b105-h2h/h2h/boards/2.0/3D/Resources/Kiwi/Renders/Kiwi Render.png

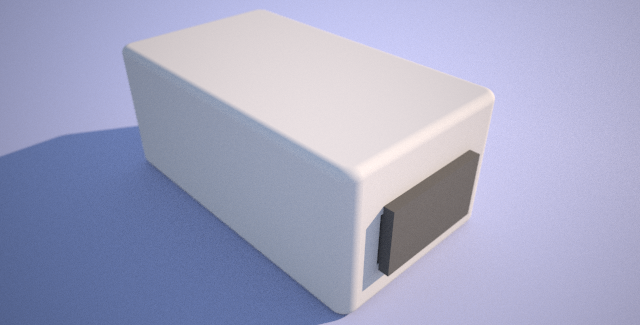
boards/2.0/3D/Resources/Kiwi/Renders/Kiwi Render.png
