b105-h2h/h2h/README.md

# h2h
PFC - Servicio de acceso inalámbrico a dispositivos médicos implantables mediante H2H
