b105-h2h/h2h/boards/2.0/3D/Resources/Persimmon/Renders/Persimmon Render 2.png

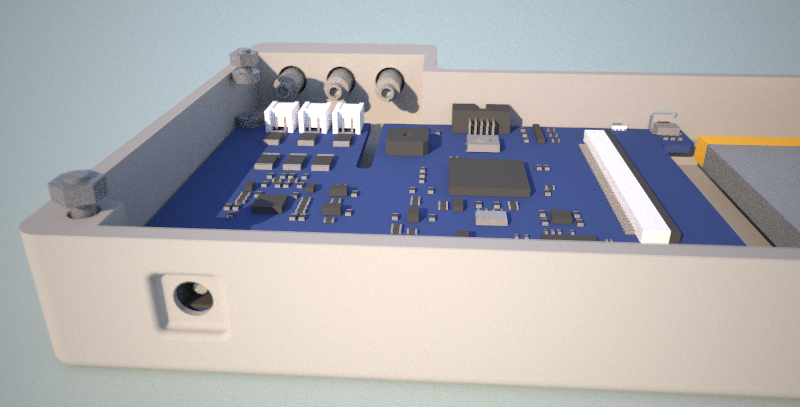
boards/2.0/3D/Resources/Persimmon/Renders/Persimmon Render 2.png
