b105-h2h/h2h/boards/2.0/H2H Main Board v1.1/Res/Images/res/Japanese-Persimmon1.jpg

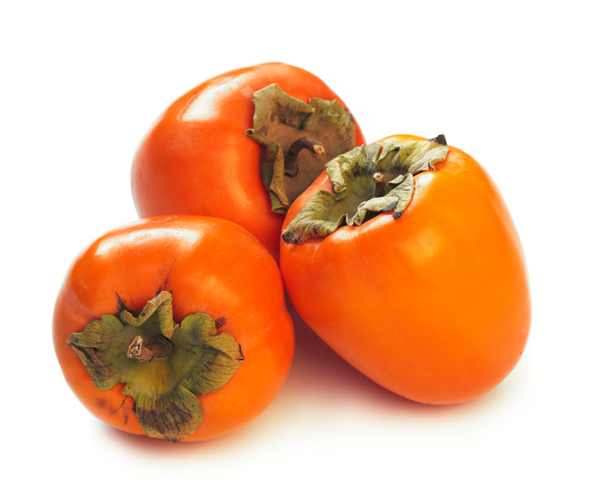
boards/2.0/H2H Main Board v1.1/Res/Images/res/Japanese-Persimmon1.jpg
