b105-h2h/h2h/boards/2.0/H2H Main Board v1.1/Res/Images/res/Persimmon.jpg

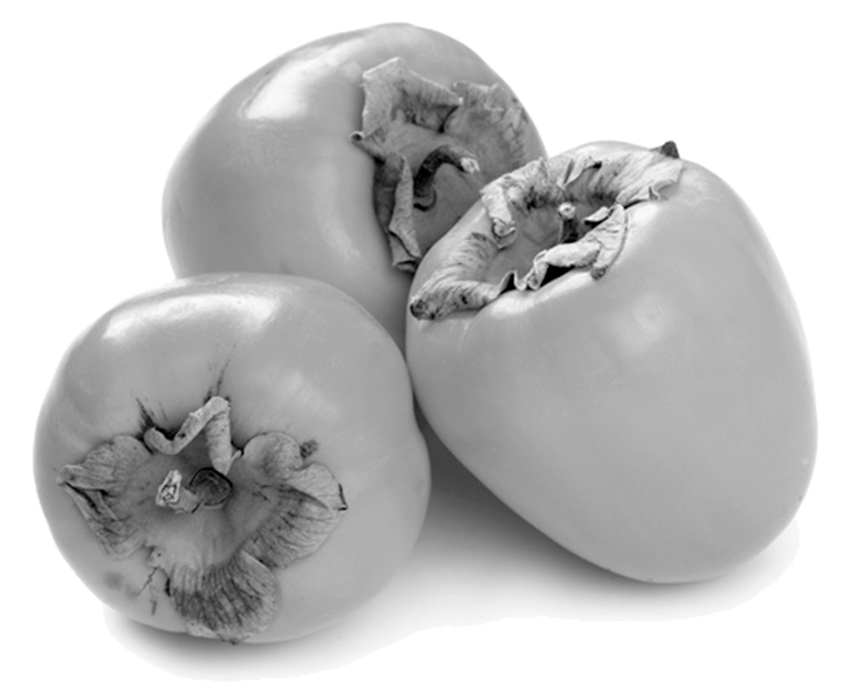
boards/2.0/H2H Main Board v1.1/Res/Images/res/Persimmon.jpg
