b105-h2h/h2h/code/dep/v3.0 PersimmonOS/FSM/Statechart Persimmon.png

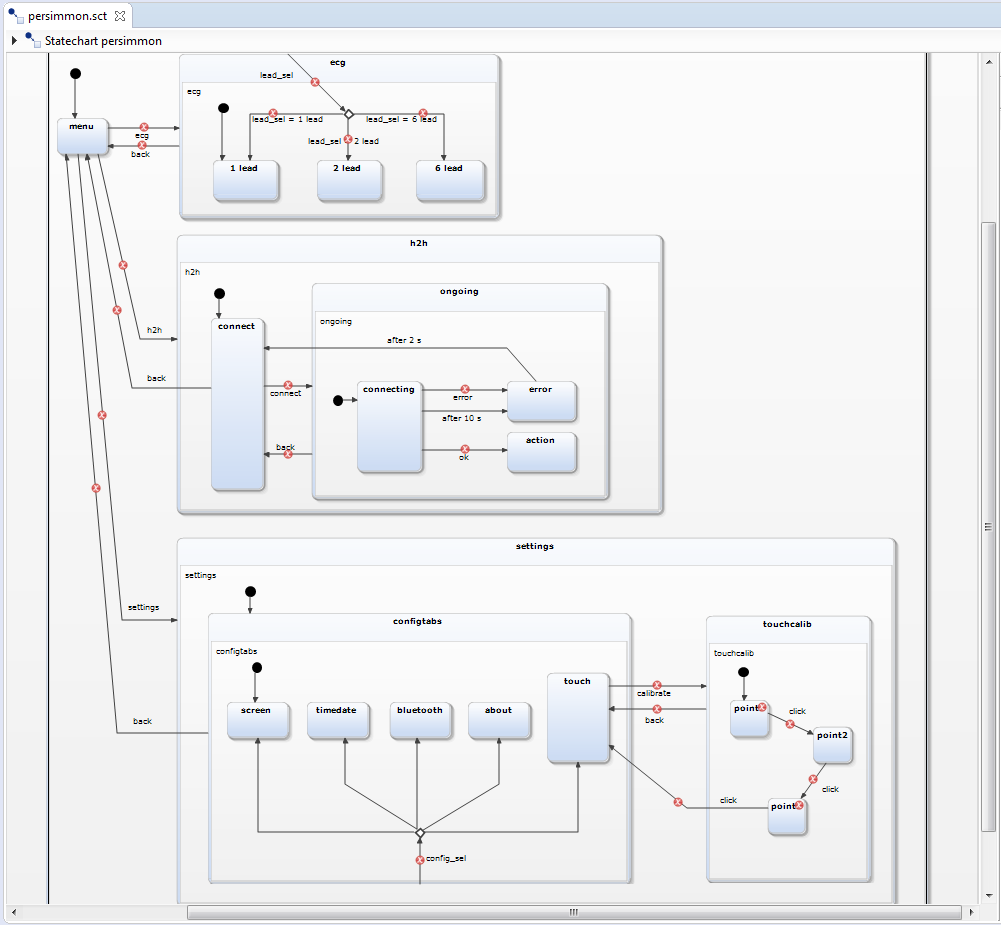
code/dep/v3.0 PersimmonOS/FSM/Statechart Persimmon.png
