b105-h2h/h2h/boards/1.0/BOM/BOM Delivered/Bill of Materials-Docking Station.xls

Sheet: BOM Report
Bill of Materials |  |  | <Parameter Title not found>
Source Data From: |  | Docking Station.PrjPcb
Project: |  | Docking Station.PrjPcb
Variant: |  | None
Creation Date: | 31/07/2015 | 21:06:06
Print Date: | 2015-07-31 | 21:06:16
 | Comment | LibRef | Designator | Description | Quantity
 | 6.8u | Pol Capacitor | C1, C2 | Polarized Capacitor | 2
 | 100p | Capacitor | C3 | Capacitor | 1
 | 4.7u | Pol Capacitor | C4 | Polarized Capacitor | 1
 | 0.1u | Capacitor | C5, C8, C10, C11 | Capacitor | 4
 | 2.2n | Capacitor | C6 | Capacitor | 1
 | 1.2m | Pol Capacitor | C7 | Polarized Capacitor | 1
 | 1u | Capacitor | C9, C12 | Capacitor | 2
 | MB6S-E3/45 | MB6S-E3/45 | D1 | Diode, Bridge Rectifier | 1
 | SM6T150A | SM6T150A | D2 | Diode, Transient Voltage Suppresor, 150V, 600W | 1
 | MRA4005T3G | MRA4005T3G | D3 | Diode, Standard, 1A | 1
 | 1N4148W-7-F | 1N4148W-7-F | D4 | Diode, Switch, 300mA, 100V | 1
 | B340LA-13-F | B340LA-13-F | D5 | Diode, Schottky, 40V, 3A | 1
 | ON | LED | D6 | LED | 1
 | CHG | LED | D7 | LED | 1
 | 4.7 | Fuse Resistor | FR1 | Resistor, Fuse | 1
 | UCC28910 | UCC28910 | IC1 | 700V Flyback Switcher with Constant-Voltage Constant-Current and Primary-side Control | 1
 | BQ24090 | BQ24090 | IC2 | Battery Charger, Single Cell Li-Ion/LiPo, 1A | 1
 | Inlet, IEC | Inlet, IEC - Plug | J1 | Inlet, IEC - Plug | 1
 | Header 3 | Header 3 | JP1 | Header, 3-Pin | 1
 | 1m | Inductor | L1, L2 | Inductor | 2
 | 2N7002 | 2N7002 | Q1 | Transistor, MOSFET, N-Channel, 60V, 300mA | 1
 | 6.8k | Resistor | R1, R2 | Resistor | 2
 | 2K | Resistor | R3, R5, R12 | Resistor | 3
 | 100K | Resistor | R4, R7, R16, R17 | Resistor | 4
 | 33 | Resistor | R6 | Resistor | 1
 | 31.6K | Resistor | R8 | Resistor | 1
 | 180 | Resistor | R9 | Resistor | 1
 | 15K | Resistor | R10 | Resistor | 1
 | 1.2K | Resistor | R11 | Resistor | 1
 | 10K | Resistor | R13 | Resistor | 1
 | 1.5K | Resistor | R14, R15 | Resistor | 2
 | WE7508110151 | WE7508110151 | T1 | Transformer, Flyback | 1
 |  |  |  |  | 45
Approved |  | Notes

Sheet: Project Information
Project Full Path | C:\Users\slopez\workspace\github\tiic-2015\Docking Station.PrjPcb
Project Filename | Docking Station.PrjPcb
Variant Name | None
Data-Source Filename | Docking Station.PrjPcb
Data-Source Full Path | C:\Users\slopez\workspace\github\tiic-2015\Docking Station.PrjPcb
Title | <Parameter Title not found>
Total Quantity | 45
Report Time | 21:06:06
Report Date | 31/07/2015
Report Date & Tine | 31/07/2015 21:06:06
Output Name | Bill of Materials
Output Type | BOM_PartType
Output Generator Name | BOM
Output Generator Description | Bill of Materials
