b105-h2h/h2h/boards/1.0/BOM/BOM Delivered/Bill of Materials-ECG Main Board.xls

Sheet: BOM Report
Bill of Materials |  |  | ECG Main Board
Source Data From: |  | ECG Main Board.PrjPcb
Project: |  | ECG Main Board.PrjPcb
Variant: |  | None
Creation Date: | 31/07/2015 | 21:04:40
Print Date: | 2015-07-31 | 21:05:37
 | Comment | LibRef | Designator | Description | Quantity
 | 6.8n | Capacitor | C1 | Capacitor | 1
 | 47p | Capacitor | C2, C3 | Capacitor | 2
 | 4.7n | Capacitor | C4, C5 | Capacitor | 2
 | 10u | Capacitor | C6, C18 | Capacitor | 2
 | 0.1u | Capacitor | C7, C12, C13, C14, C15, C16, C17, C24, C25, C30, C33, C34, C35, C36, C37 | Capacitor | 15
 | 1u | Capacitor | C8, C9, C10, C11, C31, C32, C40, C41, C42, C43, C44, C45, C46 | Capacitor | 13
 | 2.2n | Capacitor | C19 | Capacitor | 1
 | 15p | Capacitor | C20, C22 | Capacitor | 2
 | 8p | Capacitor | C21, C23 | Capacitor | 2
 | 12p | Capacitor | C26, C27 | Capacitor | 2
 | 0.47u | Capacitor | C28, C29, C39 | Capacitor | 3
 | 22p | Capacitor | C38 | Capacitor | 1
 | LED | LED | D1, D2, D3 | LED | 3
 | Touchscreen | Touchscreen | DISP |  | 1
 | RF Filter | LFB212G45SG8A127 | F1 | RF Filter 2.4 GHz | 1
 | 220 ohm 100 Mhz | Ferrita | FB1 | INDUCTOR, 0.04OHM, 3A, 0805 | 1
 | ADS1291 | ADS1291 | IC1 |  | 1
 | MSP430FR5972IPMR | MSP430FR5972IPMR | IC2 |  | 1
 | CC2560 | CC2560 | IC3 |  | 1
 | FUEL GUAGE | BQ27421 | IC4 |  | 1
 | LP5907 | LP5907 | IC5, IC6, IC7 |  | 3
 | LMS33460 | LMS33460 | IC8 |  | 1
 | TXB0106 | TXB0106 | IC9 |  | 1
 | Electrodes | JST PH 3 Pin Socket | J1 | JST PH 3 Pin Socket | 1
 | Batt | JST PH 2 Pin Socket | J2 | JST PH 2 Pin Socket | 1
 | Charger | JST PH 3 Pin Socket | J3 | JST PH 3 Pin Socket | 1
 | JTAG | JTAG 14 Pins | J4 | JTAG 7X2 Pin Header 90º | 1
 | 2N7002 | 2N7002 | Q1, Q2, Q3 | Transistor, MOSFET, N-Channel, 60V, 300mA | 3
 | BSS84 | BSS84 | Q4 | Transistor, MOSFET, P-Channel, 60V, 300mA | 1
 | 47K | Resistor | R1, R2 | Resistor | 2
 | 1M | Resistor | R3 | Resistor | 1
 | 100 | Resistor | R4, R5 | Resistor | 2
 | 1K | Resistor | R6, R12 | Resistor | 2
 | 220 | Resistor | R7 | Resistor | 1
 | 10K | Resistor | R8, R9, R10, R11, R13, R14, R15, R16 | Resistor | 8
 | 1.5M | Resistor | R17 | Resistor | 1
 | 470K | Resistor | R18 | Resistor | 1
 | 2.2K | Resistor | R19, R20, R21 | Resistor | 3
 | Spacer | Spacer 11mm M3x0.5 | SP1, SP2, SP3, SP4 | PCB Spacer 11mm M3x0.5 | 4
 | Spacer | Spacer 7mm M3x0.5 Screw | SP5, SP6, SP7, SP8 | PCB Spacer 7mm M3x0.5 Screw | 4
 | Switch SPDT | MFS201N-16-Z | SW1 |  | 1
 | XTAL_16MHZ | XTAL_16_MHz | X1 |  | 1
 | XTAL_32768 | XTAL_32768 | X2 |  | 1
 | XTAL_26_MHz | XTAL_26_MHz | X3 |  | 1
 | Buzzer | Buzzer | Z1 | Magnetic Buzzer 2.7 KHz | 1
 |  |  |  |  | 103
Approved |  | Notes

Sheet: Project Information
Project Full Path | C:\Users\slopez\workspace\github\tiic-2015\ECG Main Board.PrjPcb
Project Filename | ECG Main Board.PrjPcb
Variant Name | None
Data-Source Filename | ECG Main Board.PrjPcb
Data-Source Full Path | C:\Users\slopez\workspace\github\tiic-2015\ECG Main Board.PrjPcb
Title | ECG Main Board
Total Quantity | 103
Report Time | 21:04:40
Report Date | 31/07/2015
Report Date & Tine | 31/07/2015 21:04:40
Output Name | Bill of Materials
Output Type | BOM_PartType
Output Generator Name | BOM
Output Generator Description | Bill of Materials
