b105-h2h/h2h/boards/1.0/BOM/Main Board/BOM/Bill of Materials-ECG Main Board.xls

Sheet: BOM Report
Bill of Materials |  |  | ECG Main Board
Source Data From: |  | ECG Main Board.PrjPcb
Project: |  | ECG Main Board.PrjPcb
Variant: |  | None
Creation Date: | 23/07/2015 | 17:16:30
Print Date: | 2015-07-23 | 20:20:22
Production Quantity: | 1
Currency | <none>
 | Comment | LibRef | Designator | Quantity | Supplier 1 | Supplier Part Number 1
 | 6.8n | Capacitor | C1 | 1 | Digi-Key | 399-9120-1-ND
 | 47p | Capacitor | C2, C3 | 2 | Digi-Key | 399-1056-1-ND
 | 4.7n | Capacitor | C4, C5 | 2 | Digi-Key | 399-9091-1-ND
 | 10u | Capacitor | C6, C18 | 2 | Digi-Key | 490-10728-1-ND
 | 0.1u | Capacitor | C7, C12, C13, C14, C15, C16, C17, C24, C25, C30, C33, C34, C35, C36, C37 | 15 | Digi-Key | 490-1532-1-ND
 | 1u | Capacitor | C8, C9, C10, C11, C31, C32, C40, C41, C42, C43, C44, C45, C46 | 13 | Digi-Key | 490-3900-1-ND
 | 2.2n | Capacitor | C19 | 1 | Digi-Key | 399-7881-1-ND
 | 15p | Capacitor | C20, C22 | 2 | Digi-Key | 399-9004-1-ND
 | 8p | Capacitor | C21, C23 | 2 | Digi-Key | 490-9670-1-ND
 | 12p | Capacitor | C26, C27 | 2 | Digi-Key | 490-10704-1-ND
 | 0.47u | Capacitor | C28, C29, C39 | 3 | Digi-Key | 490-3295-1-ND
 | 22p | Capacitor | C38 | 1 | Digi-Key | 399-9031-1-ND
 | 47K | Resistor | R1, R2 | 2 | Digi-Key | CR0603-FX-4702ELFCT-ND
 | 1M | Resistor | R3 | 1 | Digi-Key | CR0603-FX-1004ELFCT-ND
 | 100 | Resistor | R4, R5 | 2 | Digi-Key | CR0603-FX-1000ELFCT-ND
 | 1K | Resistor | R6, R12 | 2 | Digi-Key | CR0603-FX-1001ELFCT-ND
 | 220 | Resistor | R7 | 1 | Digi-Key | CR0603-FX-2200ELFCT-ND
 | 10K | Resistor | R8, R9, R10, R11, R13, R14, R15, R16 | 8 | Digi-Key | CR0603-FX-1002ELFCT-ND
 | 1.5M | Resistor | R17 | 1 | Digi-Key | 311-1.50MHRCT-ND
 | 470K | Resistor | R18 | 1 | Digi-Key | CR0603-FX-4703ELFCT-ND
 | 2.2K | Resistor | R19, R20, R21 | 3 | Digi-Key | CR0603-FX-2201ELFCT-ND
 | 220 ohm 100 Mhz | Ferrita | FB1 | 1 | Digi-Key | 490-1054-1-ND
 | Header 20x2 | Touchscreen | DISP | 1 | Digi-Key | S6106-ND
 | RF Filter | LFB212G45SG8A127 | F1 | 1 | Digi-Key | 490-5021-1-ND
 | ADS1291 | ADS1291 | IC1 | 1 | Digi-Key | 296-36547-5-ND
 | BQ27421 | BQ27421 | IC4 | 1 | Digi-Key | 296-38880-1-ND
 | LP5907 | LP5907 | IC5, IC6 | 2 | Digi-Key | 296-38557-1-ND
 | LP5907 | LP5907 | IC7 | 1 | Digi-Key | 296-41463-1-ND
 | LMS33460 | LMS33460 | IC8 | 1 | Digi-Key | LMS33460MG/NOPBCT-ND
 | TXB0106 | TXB0106 | IC9 | 1 | Digi-Key | 296-23759-1-ND
 | Electrodes | JST PH 3 Pin Socket | J1 | 1 | Digi-Key | 455-1720-ND
 | Batt | JST PH 2 Pin Socket | J2 | 1 | Digi-Key | 455-1719-ND
 | Charger | JST PH 3 Pin Socket | J3 | 1 | Digi-Key | 455-1720-ND
 | JTAG | JTAG 14 Pins | J4 | 1 | Digi-Key | ED10534-ND
 | 2N7002 | 2N7002 | Q1, Q2, Q3 | 3 | Digi-Key | 568-5818-1-ND
 | BSS84 | BSS84 | Q4 | 1 | Digi-Key | BSS84CT-ND
 | Spacer | Spacer 11mm M3x0.5 | SP1, SP2, SP3, SP4 | 4 | Digi-Key | 952-2312-ND
 | Spacer | Spacer 7mm M3x0.5 Screw | SP5, SP6, SP7, SP8 | 4 | Digi-Key | 952-1498-ND
 | Switch SPDT | MFS201N-16-Z | SW1 | 1 | Digi-Key | 563-1558-ND
 | XTAL_32768 | XTAL_32768 | X2 | 1 | Digi-Key | 535-9032-ND
 | XTAL_26_MHz | XTAL_26_MHz | X3 | 1 | Digi-Key | 644-1261-1-ND
 | XTAL_16MHZ | XTAL_16_MHz | X1 | 1 | Farnell | 2467444
 | CC2560 | CC2560 | IC3 | 1 | Farnell | 2334559
 | LED | LED | D1 | 1 | Farnell | 2426228
 | LED | LED | D2 | 1 | Farnell | 2426227
 | LED | LED | D3 | 1 | Farnell | 2426229
 | Buzzer | Buzzer | Z1 | 1 | Farnell | 2215090
 |  |  |  | 102

Sheet: Project Information
Project Full Path | C:\Users\slopez\workspace\github\tiic-2015\ECG Main Board.PrjPcb
Project Filename | ECG Main Board.PrjPcb
Variant Name | None
Data-Source Filename | ECG Main Board.PrjPcb
Data-Source Full Path | C:\Users\slopez\workspace\github\tiic-2015\ECG Main Board.PrjPcb
Title | ECG Main Board
Total Quantity | 103
Report Time | 17:16:30
Report Date | 23/07/2015
Report Date & Tine | 23/07/2015 17:16:30
Output Name | Bill of Materials
Output Type | BOM_PartType
Output Generator Name | BOM
Output Generator Description | Bill of Materials
