b105-h2h/h2h/boards/1.0/BOM/Docking Station/BOM/BOM/Bill of Materials-Docking Station.xls

Sheet: BOM Report
Bill of Materials |  |  | <Parameter Title not found>
Source Data From: |  | Docking Station.PrjPcb
Project: |  | Docking Station.PrjPcb
Variant: |  | None
Creation Date: | 23/07/2015 | 19:10:10
Print Date: | 2015-07-23 | 20:02:44
Production Quantity: | 1
Currency | <none>
 | Comment | LibRef | Designator | Quantity | Supplier 1 | Supplier Part Number 1
 | 6.8u | Pol Capacitor | C1, C2 | 2 | Farnell | 1831315
 | 100p | Capacitor | C3 | 1 | Farnell | 2211011
 | 4.7u | Pol Capacitor | C4 | 1 | Farnell | 2069186
 | 0.1u | Capacitor | C5, C8, C10, C11 | 4 | Farnell | 2407345
 | 2.2n | Capacitor | C6 | 1 | Farnell | 2409062
 | 1.2m | Pol Capacitor | C7 | 1 | Farnell | 1848381
 | 1u | Capacitor | C9, C12 | 2 | Farnell | 2346954
 | MB6S-E3/45 | MB6S-E3/45 | D1 | 1 | Farnell | 1815631
 | SM6T150A | SM6T150A | D2 | 1 | Farnell | 9885889
 | MRA4005T3G | MRA4005T3G | D3 | 1 | Farnell | 1459136
 | 1N4148W-7-F | 1N4148W-7-F | D4 | 1 | Farnell | 1776392
 | B340LA-13-F | B340LA-13-F | D5 | 1 | Farnell | 1843681
 | ON | LED | D6 | 1 | Farnell | 2426228
 | CHG | LED | D7 | 1 | Farnell | 2426227
 | 4.7 | Fuse Resistor | FR1 | 1 | Farnell | 9474080
 | Inlet, IEC | Inlet, IEC - Plug | J1 | 1 | Farnell | 9248161
 | 1m | Inductor | L1, L2 | 2 | Farnell | 2457618
 | 2N7002 | 2N7002 | Q1 | 1 | Digi-key | 568-5818-1-ND
 | 6.8k | Resistor | R1, R2 | 2 | Digi-key | CR1206-FX-6801ELFCT-ND
 | 2K | Resistor | R3, R5, R12 | 3 | Digi-key | CR1206-FX-2001ELFCT-ND
 | 100K | Resistor | R4, R7, R16, R17 | 4 | Digi-key | CR1206-FX-1003ELFCT-ND
 | 33 | Resistor | R6 | 1 | Digi-key | P33.0FCT-ND
 | 31.6K | Resistor | R8 | 1 | Digi-key | CR1206-FX-3162ELFCT-ND
 | 180 | Resistor | R9 | 1 | Digi-key | CR1206-FX-1800ELFCT-ND
 | 15K | Resistor | R10 | 1 | Digi-key | CR1206-FX-1502ELFCT-ND
 | 1.2K | Resistor | R11 | 1 | Digi-key | CR1206-FX-1201ELFCT-ND
 | 10K | Resistor | R13 | 1 | Digi-key | CR1206-FX-1002ELFCT-ND
 | 1.5K | Resistor | R14, R15 | 2 | Digi-key | CR1206-FX-1501ELFCT-ND
 | WE7508110151 | WE7508110151 | T1 | 1 | Digi-key | 1297-1122-ND
 |  |  |  | 42
Approved |  | Notes

Sheet: Project Information
Project Full Path | C:\Users\slopez\workspace\github\tiic-2015\Docking Station.PrjPcb
Project Filename | Docking Station.PrjPcb
Variant Name | None
Data-Source Filename | Docking Station.PrjPcb
Data-Source Full Path | C:\Users\slopez\workspace\github\tiic-2015\Docking Station.PrjPcb
Title | <Parameter Title not found>
Total Quantity | 45
Report Time | 19:10:10
Report Date | 23/07/2015
Report Date & Tine | 23/07/2015 19:10:10
Output Name | Bill of Materials
Output Type | BOM_PartType
Output Generator Name | BOM
Output Generator Description | Bill of Materials
