b105-h2h/h2h/boards/2.0/H2H Main Board v1.1/Output/BOM/2016-07-04/H2H Main Board v1.1 (Persimmon) - BOM.xls

Sheet: BOM Report
Bill of Materials |  |  | Main Board
Source Data From: |  | H2H Main Board v1.1.PrjPCB
Project: |  | H2H Main Board v1.1.PrjPCB
Variant: |  | H2H Main Board (Main Flash Boot)
Creation Date: | 04/07/2016 | 18:04:44
Print Date: | 2016-07-04 | 18:12:51
Production Quantity: | 1
Currency | <none>
Comment | LibRef | Designator | Description | Quantity | Supplier 1 | Supplier Part Number 1 | Supplier Unit Price 1 | Supplier Order Qty 1 | Supplier Subtotal 1 | Manufacturer 1 | Manufacturer Part Number 1
1n | Capacitor | C1, C2 | Capacitor | 2 |  |  |  |  | $0.00
47p | Capacitor | C3, C4, C5 | Capacitor | 3 |  |  |  |  | $0.00
1.5n | Capacitor | C6 | Capacitor | 1 |  |  |  |  | $0.00
4.7n | Capacitor | C7, C8 | Capacitor | 2 |  |  |  |  | $0.00
1u | Capacitor | C9, C11, C15, C16, C17, C22, C25, C34, C60, C61, C62, C63, C65, C66, C67, C68, C69, C70, C71, C72 | Capacitor | 20 |  |  |  |  | $0.00
0.1u | Capacitor | C10, C12, C14, C18, C19, C20, C23, C24, C29, C30, C31, C32, C33, C35, C42, C43, C64 | Capacitor | 17 |  |  |  |  | $0.00
10u | Capacitor | C13, C28 | Capacitor | 2 |  |  |  |  | $0.00
0.47u | Capacitor | C21 | Capacitor | 1 |  |  |  |  | $0.00
10n | Capacitor | C27, C40 | Capacitor | 2 |  |  |  |  | $0.00
6p | Capacitor | C36, C37 | Capacitor | 2 |  |  |  |  | $0.00
10p | Capacitor | C38, C39 | Capacitor | 2 |  |  |  |  | $0.00
22p | Capacitor | C41 | Capacitor | 1 |  |  |  |  | $0.00
12p | Capacitor | C44, C45 | Capacitor | 2 |  |  |  |  | $0.00
1u | Capacitor | C46, C47 | Capacitor | 2 |  |  |  |  | $0.00
0.1u | Capacitor | C48, C49, C50, C51, C52, C53, C54, C55, C56, C57 | Capacitor | 10 |  |  |  |  | $0.00
0.47u | Capacitor | C58, C59 | Capacitor | 2 |  |  |  |  | $0.00
BAS70DW-04 | BAS70DW-04 | D1, D2 | TVS - Dual Schottky Rail-to-rail Protection | 2 | Digi-Key | BAS70DW-04FDICT-ND | 0,49 | 2 | $0.98 | Diodes Incorporated | BAS70DW-04-7-F
PESD5V0X1 | PESD5V0X1 | D3, D4, D5 | TVS - Bidirectional Zener Diode | 3 | Digi-Key | 568-4676-1-ND | 0,69 | 3 | $2.07 | NXP Semiconductors | PESD5V0X1BT,215
BAS16L | BAS16L | D6 | Diode - Switching diode, 1 V, 200 mA | 1 | Digi-Key | BAS16LT1GOSCT-ND | 0,11 | 1 | $0.11 | ON Semiconductor | BAS16LT1G
OVSRRGBCC3 | OVSRRGBCC3 | D7 | LED - RGB, Top/Side-emmiting | 1 | Digi-Key | 365-1981-1-ND | 0,45 | 1 | $0.45 | TT Electronics/Optek Technology | OVSRRGBCC3TM
LFB212G45SG8A127 | LFB212G45SG8A127 | F1 | Filter - RF 2.4 GHz | 1 | Digi-Key | 490-5021-1-ND | 0,32 | 1 | $0.32 | Murata Electronics North America | LFB212G45SG8A127
JST PH 2 Pin | S2B-PH-K-S | J1 | Conn - Battery, Male, 2 Pin, PCB, Right Angle | 1 | Digi-Key | 455-1719-ND | 0,15 | 1 | $0.15 | JST Sales America Inc. | S2B-PH-K-S(LF)(SN)
PJ-018H-SMT | PJ-018H-SMT | J2 | Conn - DC Power Plug - 4.0 mmOD / 1.7 mmID | 1 | Digi-Key | CP-018HPJCT-ND | 1,22 | 1 | $1.22 | CUI Inc. | PJ-018H-SMT-TR
JTAG 10 Pin | 3220-10-0200-00 | J3 | Conn - JTAG, Header, Male, Right Angle, 10 Pin, 1.27mm Pitch, ARM Standard | 1 | Digi-Key | 1175-1628-ND | 0,58 | 1 | $0.58 | CNC Tech | 3220-10-0200-00
FFC 40 Pin | ER-CON40HB-2 | J4 | Conn - FFC/FPC, 40 Pin, 1.0mm Pitch, ZIF | 1 |  |  |  |  | $0.00
Banana Jack | CT3151SP-6 | JE1, JE2, JE3, JE4 | Conn - 4mm Banana Female Jack, PCB mount, Right Angle | 4 | Digi-Key | BKCT3151SP-6-ND | 1,85 | 4 | $7.40 | B&K Precision | CT3151SP-6
GDT | 2051-09-SM | N1, N2, N3 | TVS - Gas Discharge Tube | 3 | Digi-Key | 2051-09-SM-RPLFCT-ND | 0,69 | 3 | $2.07 | Bourns Inc. | 2051-09-SM-RPLF
DMP3056L | DMP3056L | Q1 | Transistor - MOSFET, P-Channel, 30V, 4.3A | 1 | Digi-Key | DMP3056L-7DICT-ND | 0,35 | 1 | $0.35 | Diodes Incorporated | DMP3056L-7
BSS84 | BSS84 | Q2 | Transistor - MOSFET, P-Channel, 50V, 130mA | 1 | Digi-Key | BSS84CT-ND | 0,21 | 1 | $0.21 | Fairchild Semiconductor | BSS84
2N7002P | 2N7002P | Q3, Q4, Q5, Q6 | Transistor - MOSFET, N-Channel, 60V, 300mA | 4 | Digi-Key | 568-5818-1-ND | 0,13 | 4 | $0.52 | NXP Semiconductors | 2N7002P,215
22k | Resistor | R1, R2, R3, R4, R5, R6 | Resistor | 6 | Digi-Key | 541-22KXCT-ND | 0,32 | 6 | $1.92 | Vishay Dale | CRCW251222K0JNEG
47k | Resistor | R7, R8, R9 | Resistor | 3 |  |  |  |  | $0.00
0 | Resistor | R10, R27, R33, R41, R42 | Resistor | 5 |  |  |  |  | $0.00
1M | Resistor | R11, R20, R50, R51, R52, R53, R54 | Resistor | 7 |  |  |  |  | $0.00
100k | Resistor | R12, R25, R31, R32, R36, R37, R43, R47, R48, R49 | Resistor | 10 |  |  |  |  | $0.00
100 | Resistor | R13, R14, R18, R23 | Resistor | 4 |  |  |  |  | $0.00
10k | Resistor | R15, R16, R17, R29, R38, R40 | Resistor | 6 |  |  |  |  | $0.00
0.01 | Resistor | R19 | Resistor | 1 | Digi-Key | MCS1632R010FERCT-ND | 0,44 | 1 | $0.44 | Ohmite | MCS1632R010FER
1.2k | Resistor | R26 | Resistor | 1 |  |  |  |  | $0.00
2k | Resistor | R28 | Resistor | 1 |  |  |  |  | $0.00
680 | Resistor | R44 | Resistor | 1 |  |  |  |  | $0.00
220 | Resistor | R45, R46 | Resistor | 2 |  |  |  |  | $0.00
WS-TASU 436331045822 | WS-TASU 436331045822 | SW1 | Switch - Tactile, Off-Mom, SPST, Side-Actuated | 1 | Digi-Key | 732-7059-1-ND | 0,49 | 1 | $0.49 | Wurth Electronics Inc | 436331045822
EVQ-Q2K01W | EVQ-Q2K01W | SW2 | Switch - Tactile, Off-Mom, SPST | 1 | Digi-Key | P12941SCT-ND | 0,36 | 1 | $0.36 | Panasonic Electronic Components | EVQ-Q2K01W
ADS1292 | ADS1292 | U1 | IC - Analog Front End - Medical | 1 | Digi-Key | 296-30137-5-ND | 9,52 | 1 | $9.52 | Texas Instruments | ADS1292IPBS
BQ27441DRZR-G1A | BQ27441DRZR-G1A | U2 | IC - Fuel Gauge, System-Side Impedance Track | 1 | Digi-Key | 296-39941-1-ND | 2,55 | 1 | $2.55 | Texas Instruments | BQ27441DRZR-G1A
BQ24090 | BQ24090 | U3 | IC - Battery Charger, Single Cell Li-Ion/LiPo, 1A | 1 | Digi-Key | 296-38875-1-ND | 1,10 | 1 | $1.10 | Texas Instruments | BQ24090DGQR
STM32L162VDT6 | STM32L162VDT6 | U4 | ARM Cortex-M3 32-bit MCU, 384 KB Flash, 48 KB Internal RAM, 83 I/Os, 100-pin LQFP, -40 to 85 degC, Tray | 1 | Farnell | 2333341 | 10,22 | 1 | $10.22 | STMICROELECTRONICS | STM32L162VDT6
SN74LV4T125 | SN74LV4T125 | U5, U7 | IC - Voltage Level Translator | 2 | Digi-Key | 296-40546-1-ND | 1,00 | 2 | $2.00 | Texas Instruments | SN74LV4T125RGYR
CC2560A | CC2560A | U6 | IC - Bluetooth 4.0 controller (BR/EDR) | 1 | Farnell | 2334559 | 5,67 | 1 | $5.67 | TEXAS INSTRUMENTS | CC2560ARVMT
LP5907-3.3 | LP5907-3.3 | U8, U10, U12, U13 | Voltage Regulator - Linear | 4 | Digi-Key | 296-38557-1-ND | 0,51 | 4 | $2.04 | Texas Instruments | LP5907MFX-3.3/NOPB
TPS73633 | TPS73633 | U9 | Voltage Regulator - Linear | 1 | Digi-Key | 296-17884-1-ND | 1,98 | 1 | $1.98 | Texas Instruments | TPS73633DRBR
LP5907-1.8 | LP5907-1.8 | U11 | Voltage Regulator - Linear | 1 | Digi-Key | 296-41463-1-ND | 0,51 | 1 | $0.51 | Texas Instruments | LP5907MFX-1.8/NOPB
ABS07-120-32.768KHZ-T | ABS07-120-32.768KHZ-T | X1 | Crystal - 32.768 kHz | 1 | Digi-Key | 535-11937-1-ND | 0,64 | 1 | $0.64 | Abracon LLC | ABS07-120-32.768KHZ-T
ABM3B-16.000MHZ-10-1-U | ABM3B-16.000MHZ-10-1-U | X2 | Crystal - 16 MHz | 1 | Digi-Key | 300-8206-1-ND | 0,62 | 1 | $0.62 | Abracon LLC | ABM3B-16.000MHZ-10-1-U-T
NX2016SA | NX2016SA | X3 | Crystal - 26 MHz | 1 | Digi-Key | 644-1220-1-ND | 0,69 | 1 | $0.69 | NDK | NX2016SA-26M-STD-CZS-1
2.7 kHz | KSSG74B16 | Z1 | Transductor - Buzzer 2.7 kHz | 1 | Farnell | 2215090 | 1,47 | 1 | $1.47 | KINGSTATE | KSSG74B16
 |  |  |  | 162 |  |  |  |  | $58.65
Approved |  | Notes

Sheet: Project Information
Project Full Path | C:\Users\slopez\workspace\github\tiic-2015\boards\2.0\H2H Main Board v1.1\H2H Main Board v1.1.PrjPCB
Project Filename | H2H Main Board v1.1.PrjPCB
Variant Name | H2H Main Board (Main Flash Boot)
Data-Source Filename | H2H Main Board v1.1.PrjPCB
Data-Source Full Path | C:\Users\slopez\workspace\github\tiic-2015\boards\2.0\H2H Main Board v1.1\H2H Main Board v1.1.PrjPCB
Title | Main Board
Total Quantity | 162
Report Time | 18:04:44
Report Date | 04/07/2016
Report Date & Tine | 04/07/2016 18:04:44
Output Name | Bill of Materials
Output Type | BOM_PartType
Output Generator Name | BOM
Output Generator Description | Bill of Materials
