b105-h2h/h2h/boards/2.0/H2H Main Board v1.1/Output/BOM/2016-07-29/H2H Main Board v1.1 (Persimmon) - BOM.xls

Sheet: BOM Report
Bill of Materials |  |  | Main Board
Source Data From: |  | H2H Main Board v1.1.PrjPCB
Project: |  | H2H Main Board v1.1.PrjPCB
Variant: |  | H2H Main Board (Main Flash Boot)
Creation Date: | 29/07/2016 | 18:36:52
Print Date: | 2016-07-29 | 18:40:47
Production Quantity: | 1
Currency | <none>
Footprint | Comment | Designator | Description | Quantity | Supplier 1 | Supplier Part Number 1 | Supplier Unit Price 1
C0603 | 1n | C1, C2 | Capacitor | 2
C0603 | 47p | C3, C4, C5 | Capacitor | 3
C0603 | 1.5n | C6 | Capacitor | 1
C0603 | 4.7n | C7, C8 | Capacitor | 2
C0603 | 1u | C9, C11, C15, C16, C17, C22, C25, C27, C28, C29, C30, C32, C33, C34, C35, C36, C37, C38, C39, C66 | Capacitor | 20
C0603 | 0.1u | C10, C12, C14, C18, C19, C20, C23, C24, C31, C41, C42, C61, C62, C63, C64, C65, C67 | Capacitor | 17
C0603 | 10u | C13, C60 | Capacitor | 2
C0603 | 0.47u | C21 | Capacitor | 1
C0402 | 22p | C40 | Capacitor | 1
C0402 | 12p | C43, C44 | Capacitor | 2
C0402 | 1u | C45, C46 | Capacitor | 2
C0402 | 0.1u | C47, C48, C49, C50, C51, C52, C53, C54, C55, C56 | Capacitor | 10
C0402 | 0.47u | C57, C58 | Capacitor | 2
C0603 | 10n | C59, C72 | Capacitor | 2
C0603 | 6p | C68, C69 | Capacitor | 2
C0603 | 10p | C70, C71 | Capacitor | 2
 | BAS70DW-04 | D1, D2 | TVS - Dual Schottky Rail-to-rail Protection | 2 | Digi-Key | BAS70DW-04FDICT-ND | 0,49
 | PESD5V0X1 | D3, D4, D5 | TVS - Bidirectional Zener Diode | 3 | Digi-Key | 568-4676-1-ND | 0,69
 | BAS16L | D6 | Diode - Switching diode, 1 V, 200 mA | 1 | Digi-Key | BAS16LT1GOSCT-ND | 0,11
 | OVSRRGBCC3 | D7 | LED - RGB, Top/Side-emmiting | 1 | Digi-Key | 365-1981-1-ND | 0,45
 | LFB212G45SG8A127 | F1 | Filter - RF 2.4 GHz | 1 | Digi-Key | 490-5021-1-ND | 0,32
 | JST PH 2 Pin | J1 | Conn - Battery, Male, 2 Pin, PCB, Right Angle | 1 | Digi-Key | 455-1719-ND | 0,15
 | PJ-018H-SMT | J2 | Conn - DC Power Plug - 4.0 mmOD / 1.7 mmID | 1 | Digi-Key | CP-018HPJCT-ND | 1,22
 | FFC 40 Pin | J3 | Conn - FFC/FPC, 40 Pin, 1.0mm Pitch, ZIF | 1
 | JTAG 10 Pin | J4 | Conn - JTAG, Header, Male, Right Angle, 10 Pin, 1.27mm Pitch, ARM Standard | 1 | Digi-Key | 1175-1628-ND | 0,58
 | CT3151-6 | JE1, JE2, JE3, JE4 | Conn - 4mm Banana Female Jack, PCB mount, Right Angle | 4 | Digi-Key | BKCT3151SP-6-ND | 1,85
 | GDT | N1, N2, N3 | TVS - Gas Discharge Tube | 3 | Digi-Key | 2051-09-SM-RPLFCT-ND | 0,69
 | DMP3056L | Q1 | Transistor - MOSFET, P-Channel, 30V, 4.3A | 1 | Digi-Key | DMP3056L-7DICT-ND | 0,35
 | BSS84 | Q2 | Transistor - MOSFET, P-Channel, 50V, 130mA | 1 | Digi-Key | BSS84CT-ND | 0,21
 | 2N7002P | Q3, Q4, Q5, Q6 | Transistor - MOSFET, N-Channel, 60V, 300mA | 4 | Digi-Key | 568-5818-1-ND | 0,13
R2512 | 22k | R1, R2, R3, R4, R5, R6 | Resistor | 6 | Digi-Key | 541-22KXCT-ND | 0,32
R0603 | 47k | R7, R8, R9 | Resistor | 3
R0603 | 0 | R10, R25, R38, R39, R47 | Resistor | 5
R0603 | 1M | R11, R21, R33, R34, R35, R36, R37 | Resistor | 7
R0603 | 100k | R12, R28, R29, R31, R40, R44, R45, R46, R49, R50 | Resistor | 10
R0603 | 100 | R13, R14, R16, R17 | Resistor | 4
R1206 | 0.01 | R15 | Resistor | 1 | Digi-Key | MCS1632R010FERCT-ND | 0,51
R0603 | 10k | R18, R19, R20, R27, R52, R54 | Resistor | 6
R0603 | 1.2k | R24 | Resistor | 1
R0603 | 2k | R26 | Resistor | 1
R0603 | 680 | R41 | Resistor | 1
R0603 | 220 | R42, R43 | Resistor | 2
 | WS-TASU 436331045822 | SW1 | Switch - Tactile, Off-Mom, SPST, Side-Actuated | 1 | Digi-Key | 732-7059-1-ND | 0,49
 | EVQ-Q2K01W | SW2 | Switch - Tactile, Off-Mom, SPST | 1 | Digi-Key | P12941SCT-ND | 0,36
 | ADS1292 | U1 | IC - Analog Front End - Medical | 1 | Digi-Key | 296-30137-5-ND | 9,52
 | BQ27441DRZR-G1A | U2 | IC - Fuel Gauge, System-Side Impedance Track | 1 | Digi-Key | 296-39941-1-ND | 2,55
 | BQ24090 | U3 | IC - Battery Charger, Single Cell Li-Ion/LiPo, 1A | 1 | Digi-Key | 296-38875-1-ND | 1,10
 | LP5907-3.3 | U4, U6, U8, U9 | Voltage Regulator - Linear | 4 | Digi-Key | 296-38557-1-ND | 0,51
 | TPS73633 | U5 | Voltage Regulator - Linear | 1 | Digi-Key | 296-17884-1-ND | 1,98
 | LP5907-1.8 | U7 | Voltage Regulator - Linear | 1 | Digi-Key | 296-41463-1-ND | 0,51
 | SN74LV4T125 | U10, U11 | IC - Voltage Level Translator | 2 | Digi-Key | 296-40546-1-ND | 1,00
 | CC2560A | U12 | IC - Bluetooth 4.0 controller (BR/EDR) | 1 | Farnell | 2334559 | 5,67
 | STM32L162VDT6 | U13 | ARM Cortex-M3 32-bit MCU, 384 KB Flash, 48 KB Internal RAM, 83 I/Os, 100-pin LQFP, -40 to 85 degC, Tray | 1 | Farnell | 2333341 | 10,22
 | ABM3B-16.000MHZ-10-1-U | X1 | Crystal - 16 MHz | 1 | Digi-Key | 300-8206-1-ND | 0,62
 | ABS07-120-32.768KHZ-T | X2 | Crystal - 32.768 kHz | 1 | Digi-Key | 535-11937-1-ND | 0,64
 | NX2016SA | X3 | Crystal - 26 MHz | 1 | Digi-Key | 644-1220-1-ND | 0,69
 | 2.7 kHz | Z1 | Transductor - Buzzer 2.7 kHz | 1 | Farnell | 2215090 | 1,47
 |  |  |  | 162
Approved |  | Notes

Sheet: Project Information
Project Full Path | C:\Users\slopez\workspace\github\tiic-2015\boards\2.0\H2H Main Board v1.1\H2H Main Board v1.1.PrjPCB
Project Filename | H2H Main Board v1.1.PrjPCB
Variant Name | H2H Main Board (Main Flash Boot)
Data-Source Filename | H2H Main Board v1.1.PrjPCB
Data-Source Full Path | C:\Users\slopez\workspace\github\tiic-2015\boards\2.0\H2H Main Board v1.1\H2H Main Board v1.1.PrjPCB
Title | Main Board
Total Quantity | 162
Report Time | 18:36:52
Report Date | 29/07/2016
Report Date & Tine | 29/07/2016 18:36:52
Output Name | Bill of Materials
Output Type | BOM_PartType
Output Generator Name | BOM
Output Generator Description | Bill of Materials
