b105-h2h/h2h/boards/2.0/H2H Power Supply v1.1/Output/BOM/2016-07-04/H2H Power Supply v1.1 (Kiwi) - BOM.xls

Sheet: BOM Report
Bill of Materials |  |  | Bill of Materials For Project [H2H Power Supply v1.1.PrjPCB] (No PCB Document Selected)
Source Data From: |  | H2H Power Supply v1.1.PrjPCB
Project: |  | H2H Power Supply v1.1.PrjPCB
Variant: |  | None
Creation Date: | 04/07/2016 | 18:14:20
Print Date: | 2016-07-04 | 18:16:52
Production Quantity: | 1
Currency | <none>
Comment | LibRef | Designator | Description | Quantity | Supplier 1 | Supplier Part Number 1 | Supplier Unit Price 1 | Supplier Order Qty 1 | Supplier Subtotal 1 | Manufacturer 1 | Manufacturer Part Number 1
6.8u | 450BXC6R8MEFC10X16 | C1, C2 | Capacitor - Electrolytic Capacitor, 6.8 uF, 450 V, 20%, 10 mm | 2 | Farnell | 1831315 | 0,95 | 2 | $1.90 | RUBYCON | 450BXC6R8MEFC10X16
680p | Capacitor | C3 | Capacitor | 1 |  |  |  |  | $0.00
1n | Capacitor | C4, C7, C11 | Capacitor | 3 |  |  |  |  | $0.00
0.1u | Capacitor | C5, C9 | Capacitor | 2 |  |  |  |  | $0.00
4.7u | EXV475M035A9BAA | C6 | Capacitor - Electrolytic Capacitor, SMD, 4.7 uF, 35 V, 4 mm | 1 | Farnell | 2069186 |  | 1 | $0.00 | KEMET | EXV475M035A9BAA
1200u | EEUFM1A122 | C8 | Capacitor - Electrolytic Capacitor, 1200 uF, 10 V, 20%, 10 mm | 1 | Farnell | 1848381 | 0,798 | 1 | $0.80 | PANASONIC ELECTRONIC COMPONENTS | EEUFM1A122
10n | Capacitor | C10 | Capacitor | 1 |  |  |  |  | $0.00
MB6S-E3/45 | MB6S-E3/45 | D1 | Diode - Bridge Rectifier, 600 V, 0.5 A | 1 | Farnell | 1815631 | 0,396 | 1 | $0.40 | VISHAY | MB6S-E3/45
US1M-13-F | US1M-13-F | D2 | Diode - Ultra-fast, 75 ns, 1.7V, 1A, 1000V | 1 | Digi-Key | US1M-FDICT-ND | 0,38 | 1 | $0.38 | Diodes Incorporated | US1M-13-F
1N4148W-7-F | 1N4148W-7-F | D3 | Diode - Standard, Switch, 1.25V, 300mA, 100V | 1 | Farnell | 1776392 |  | 1 | $0.00 | DIODES INC. | 1N4148W-7-F.
B340LA-13-F | B340LA-13-F | D4 | Diode - Schottky, 450mV, 3A, 40V | 1 | Farnell | 1843681 |  | 1 | $0.00 | DIODES INC. | B340LA-13-F
4.7 | NFR25H0004708JA500 | FR1 | Resistor - Fusible, Non-flammable Resistor | 1 | Farnell | 9474080 |  | 1 | $0.00 | VISHAY | NFR25H0004708JA500
JR-201S | JR-201S | J1 | Conn - 250 V AC, Inlet, IEC, Plug | 1 | Farnell | 9248161 | 1,96 | 1 | $1.96 | MULTICOMP | JR-201S(PCB)
JST PH 2 Pin | B2B-PH-K-S | J2 | Conn - Battery, Male, 2 Pin, PCB | 1 | Digi-Key | 455-1704-ND | 0,15 | 1 | $0.15 | JST Sales America Inc. | B2B-PH-K-S(LF)(SN)
1m | DR0810-105L | L1, L2 | Inductor - Power, 1 mH, 0.5 A Sat. Current, 10% | 2 | Farnell | 2457618 | 2,56 | 2 | $5.12 | COILCRAFT | DR0810-105L
6.8k | Resistor | R1, R2 | Resistor | 2 |  |  |  |  | $0.00
2k | Resistor | R3 | Resistor | 1 |  |  |  |  | $0.00
0 | Resistor | R4 | Resistor | 1 |  |  |  |  | $0.00
150k | Resistor | R5 | Resistor | 1 |  |  |  |  | $0.00
33 | Resistor | R6 | Resistor | 1 |  |  |  |  | $0.00
100k | Resistor | R7 | Resistor | 1 |  |  |  |  | $0.00
33k | Resistor | R8 | Resistor | 1 |  |  |  |  | $0.00
22 | Resistor | R9 | Resistor | 1 |  |  |  |  | $0.00
15k | Resistor | R10 | Resistor | 1 |  |  |  |  | $0.00
WE7508110151 | WE7508110151 | T1 | Transformer - Flyback/Offline Transformer | 1 | Digi-Key | 1297-1122-ND | 4,00 | 1 | $4.00 | Wurth Electronics Midcom | 7508110151
UCC28910 | UCC28910 | U1 | IC - SMPS Flyback, 700V Flyback Switcher with Constant-Voltage/Constant-Current and Primary-Side Control | 1 | Digi-Key | 296-37829-1-ND | 1,85 | 1 | $1.85 | Texas Instruments | UCC28910DR
 |  |  |  | 32 |  |  |  |  | $16.55
Approved |  | Notes

Sheet: Project Information
Project Full Path | C:\Users\slopez\workspace\github\tiic-2015\boards\2.0\H2H Power Supply v1.1\H2H Power Supply v1.1.PrjPCB
Project Filename | H2H Power Supply v1.1.PrjPCB
Variant Name | None
Data-Source Filename | H2H Power Supply v1.1.PrjPCB
Data-Source Full Path | C:\Users\slopez\workspace\github\tiic-2015\boards\2.0\H2H Power Supply v1.1\H2H Power Supply v1.1.PrjPCB
Title | Bill of Materials For Project [H2H Power Supply v1.1.PrjPCB] (No PCB Document Selected)
Total Quantity | 32
Report Time | 18:14:20
Report Date | 04/07/2016
Report Date & Tine | 04/07/2016 18:14:20
Output Name | Bill of Materials
Output Type | BOM_PartType
Output Generator Name | BOM
Output Generator Description | Bill of Materials
