b105-h2h/h2h/boards/1.0/BOM/BOM Delivered/BOM Docking Station.png

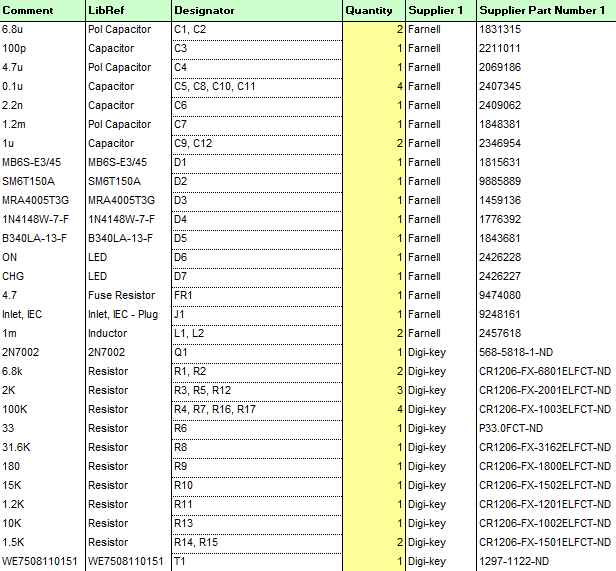
boards/1.0/BOM/BOM Delivered/BOM Docking Station.png
