b105-h2h/h2h/boards/1.0/BOM/BOM Delivered/BOM ECG Main Board.png

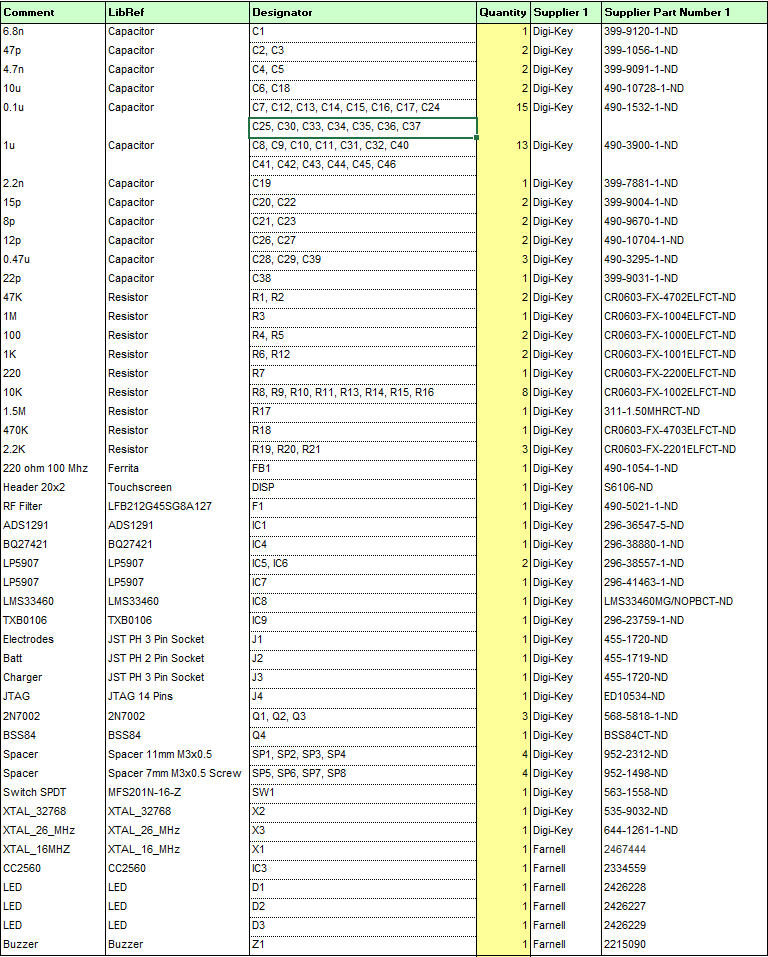
boards/1.0/BOM/BOM Delivered/BOM ECG Main Board.png
