b105-h2h/h2h/boards/1.0/3D/TIIC Main Board/TIIC Main Board STL/TIIC Main Board (hollow screen print).stl

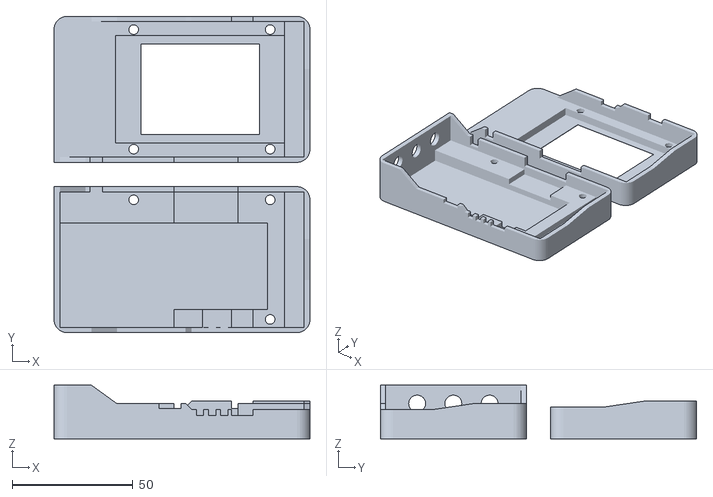
[picture p19: CAD file, 2016-09-28]
boards/1.0/3D/TIIC Main Board/TIIC Main Board STL/TIIC Main Board (hollow screen print).stl
106.0 x 131.0 x 22.2
