b105-h2h/h2h/boards/2.0/H2H Main Board v1.1/Output/3D Models/Main Board.step

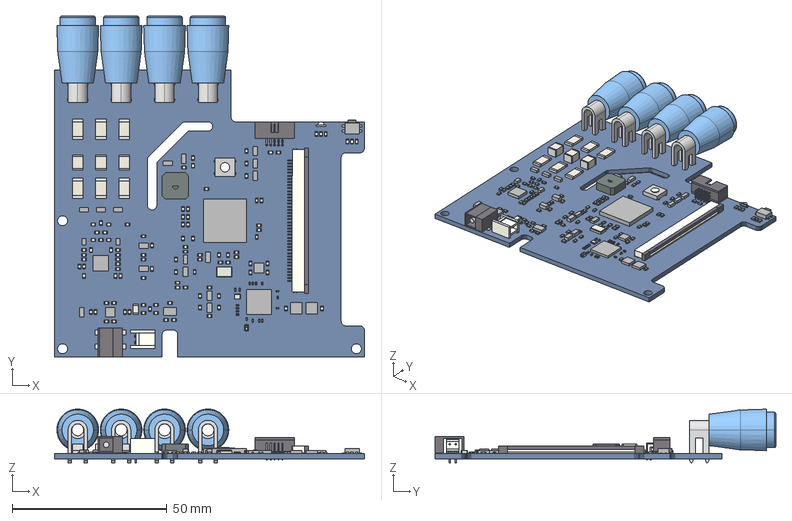
[picture p20: CAD file, 2016-09-28]
boards/2.0/H2H Main Board v1.1/Output/3D Models/Main Board.step
100.0 x 109.9 x 17.4 mm
Board
Extruded x 573
User_Library-ct3151sp-6-BLU-300 x 4
User_Library-ct3151sp-6-BLU-301 x 4
