b105-h2h/h2h/boards/1.0/3D/TIIC Power Supply/Batt.step

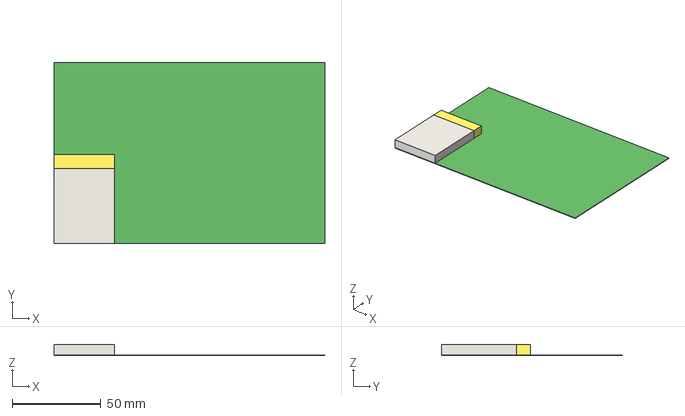
[picture p21: CAD file, 2016-09-28]
boards/1.0/3D/TIIC Power Supply/Batt.step
152.4 x 101.6 x 6.41 mm
Board
Extruded x 2
