b105-h2h/h2h/boards/2.0/3D/Print Service/2016-03-29 Print Service/Persimmon Access Device Print v1.1 - Top.stl

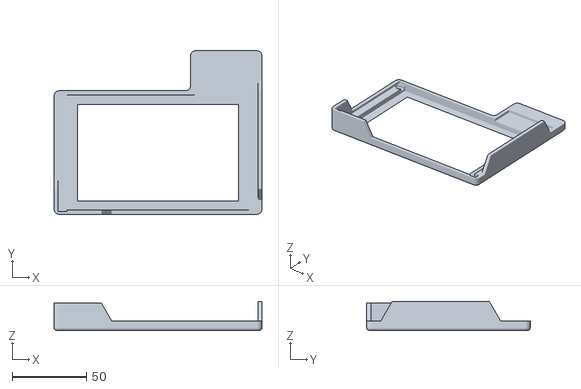
[picture p23: CAD file, 2016-09-28]
boards/2.0/3D/Print Service/2016-03-29 Print Service/Persimmon Access Device Print v1.1 - Top.stl
139.7 x 109.9 x 19.6
