b105-h2h/h2h/boards/2.0/3D/Print Service/2016-06-01 Print Service/Persimmon Pacemaker Print v1.3 - Top.stl

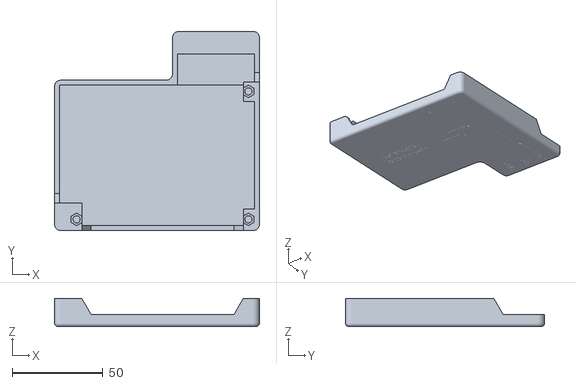
[picture p24: CAD file, 2016-09-28]
boards/2.0/3D/Print Service/2016-06-01 Print Service/Persimmon Pacemaker Print v1.3 - Top.stl
113.1 x 109.9 x 15.6
