b105-h2h/h2h/boards/2.0/3D/Print Service/2016-06-01 Result v1.3/Persimmon Pacemaker Belt Holder v1.3.stl

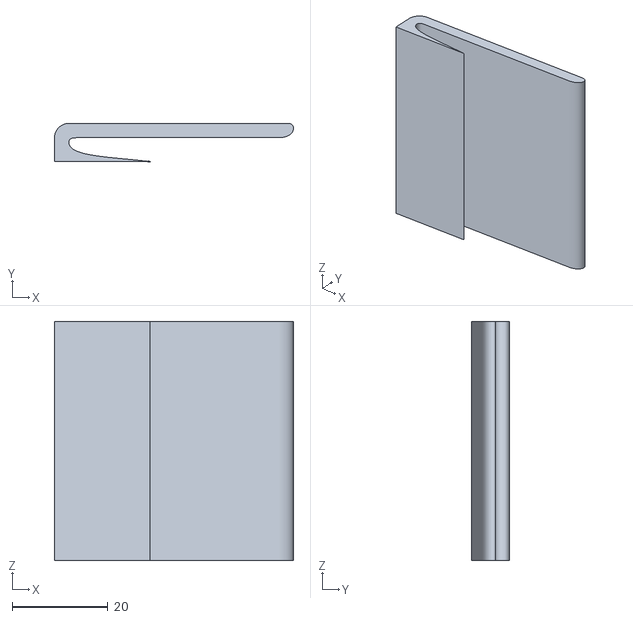
[picture p25: CAD file, 2016-09-28]
boards/2.0/3D/Print Service/2016-06-01 Result v1.3/Persimmon Pacemaker Belt Holder v1.3.stl
50.0 x 8.00 x 50.0
