b105-h2h/h2h/boards/2.0/3D/Print Service/2016-07-07 Result/Kiwi Charger Print v2.0 - Top.stl

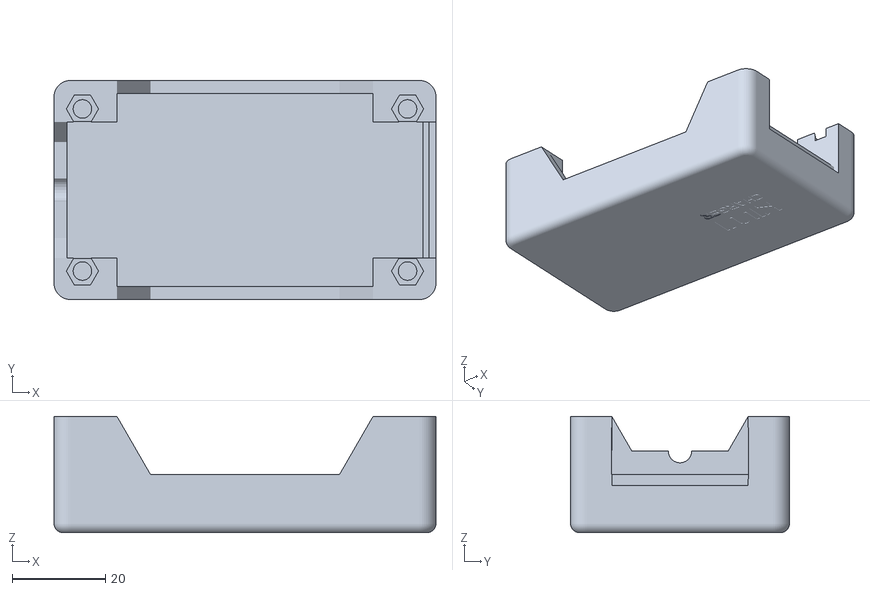
[picture p26: CAD file, 2016-09-28]
boards/2.0/3D/Print Service/2016-07-07 Result/Kiwi Charger Print v2.0 - Top.stl
82.0 x 47.0 x 25.0
