b105-h2h/h2h/boards/2.0/3D/Print Service/2016-07-13 Final Result/Persimmon Pacemaker Print v2.1 - Bottom.stl

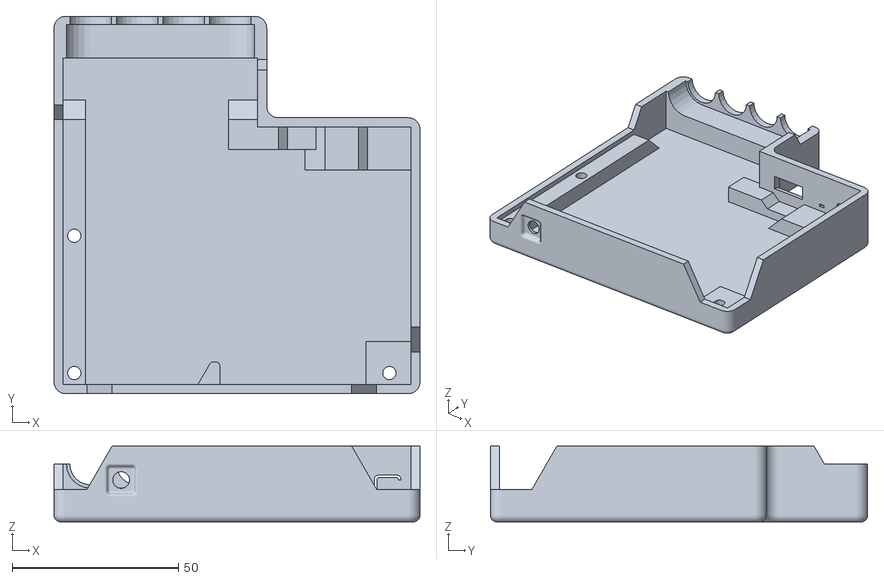
[picture p27: CAD file, 2016-09-28]
boards/2.0/3D/Print Service/2016-07-13 Final Result/Persimmon Pacemaker Print v2.1 - Bottom.stl
110.1 x 113.5 x 22.8
