b105-h2h/h2h/boards/2.0/3D/Prototypes/Persimmon Access Device/Persimmon Access Device v2.1/STL/Persimmon Access Device Print v2.1 - Bottom.stl

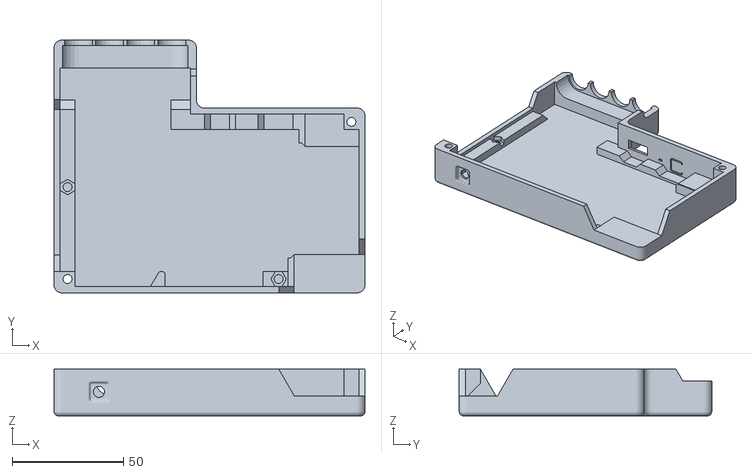
[picture p28: CAD file, 2016-09-28]
boards/2.0/3D/Prototypes/Persimmon Access Device/Persimmon Access Device v2.1/STL/Persimmon Access Device Print v2.1 - Bottom.stl
139.7 x 113.5 x 21.0
