b105-h2h/h2h/boards/2.0/3D/Resources/3D Lib/Banana PCB/ct3151sp-6.STEP

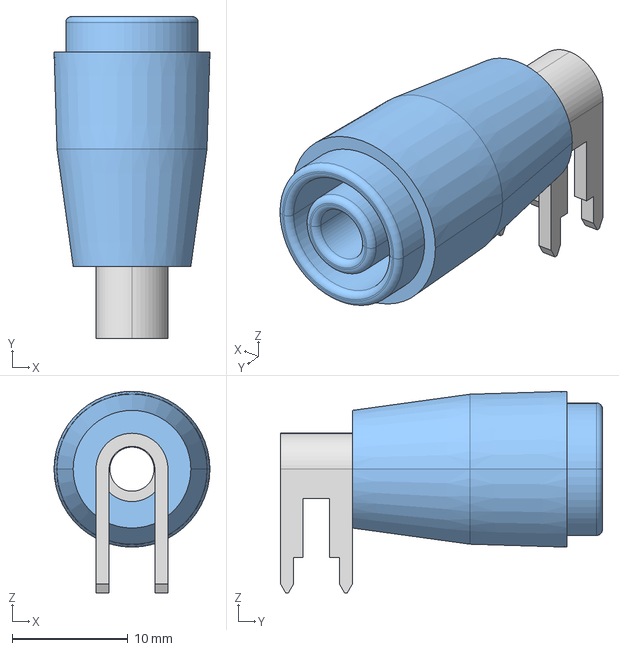
[picture p29: CAD file, 2016-09-28]
boards/2.0/3D/Resources/3D Lib/Banana PCB/ct3151sp-6.STEP
13.5 x 27.8 x 17.4 mm
User_Library-ct3151sp-6-BLU-300
User_Library-ct3151sp-6-BLU-301
