b105-h2h/h2h/boards/2.0/3D/Resources/3D Lib/Banana PCB/Exports/Banana PCB.step

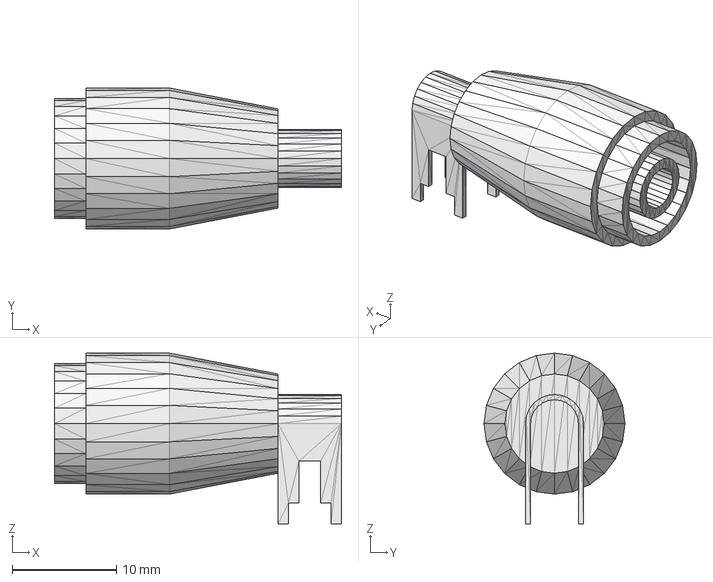
[picture p30: CAD file, 2016-09-28]
boards/2.0/3D/Resources/3D Lib/Banana PCB/Exports/Banana PCB.step
27.5 x 13.5 x 16.4 mm
