b105-h2h/h2h/boards/2.0/3D/Resources/Kiwi/Board - Kiwi/Kiwi Board.step

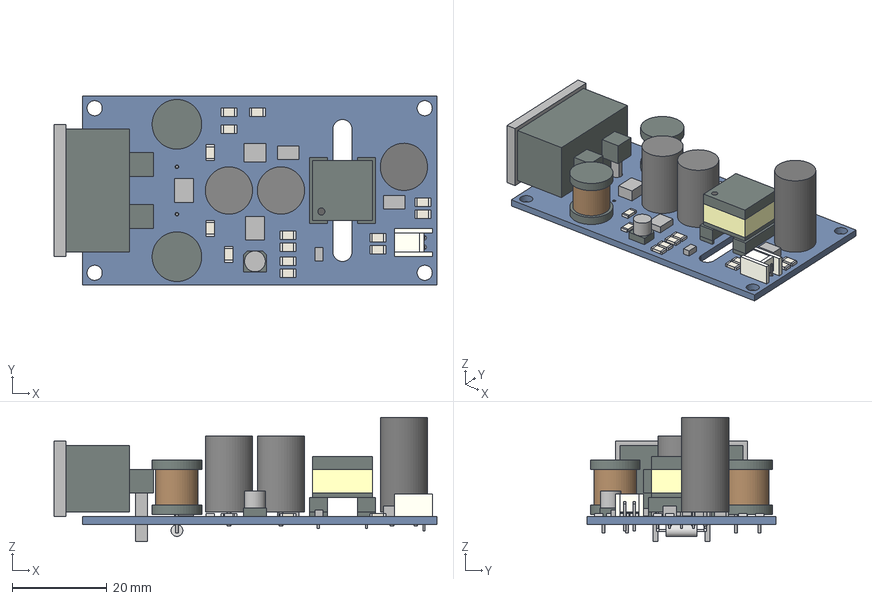
[picture p31: CAD file, 2016-09-28]
boards/2.0/3D/Resources/Kiwi/Board - Kiwi/Kiwi Board.step
81.0 x 40.0 x 26.3 mm
Board
Extruded x 88
