b105-h2h/h2h/boards/2.0/3D/Resources/Persimmon/Board - Persimmon/Persimmon Board.step

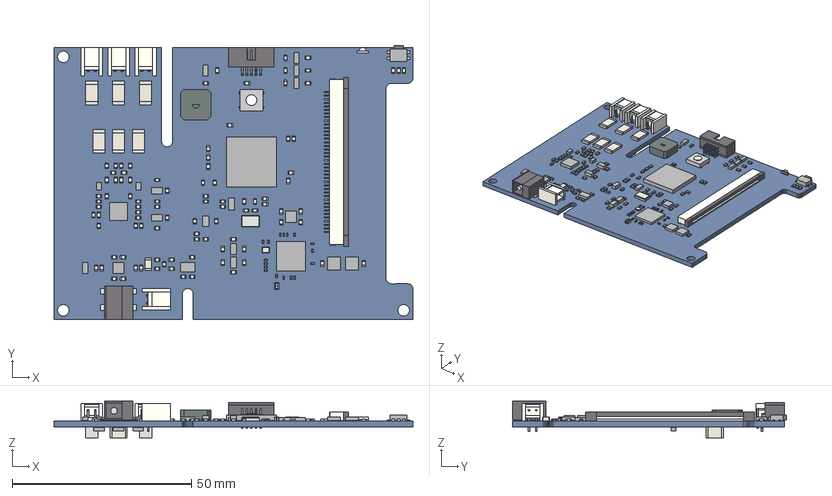
[picture p32: CAD file, 2016-09-28]
boards/2.0/3D/Resources/Persimmon/Board - Persimmon/Persimmon Board.step
100.0 x 76.4 x 10.3 mm
Board
Extruded x 577
