b105-h2h/h2h/boards/2.0/3D/Resources/Persimmon/Board - Screen/Screen.step

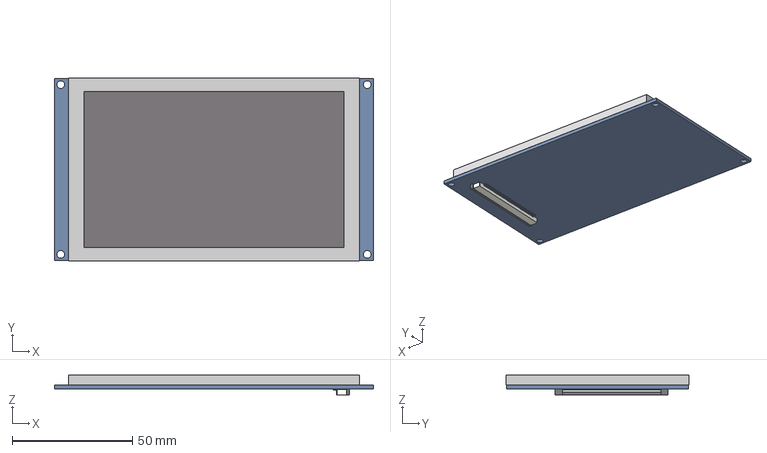
[picture p33: CAD file, 2016-09-28]
boards/2.0/3D/Resources/Persimmon/Board - Screen/Screen.step
132.7 x 76.0 x 8.29 mm
Board
Extruded x 89
