b105-h2h/h2h/boards/1.0/3D/TIIC Power Supply/STL/TIIC Power Supply (Box).stl

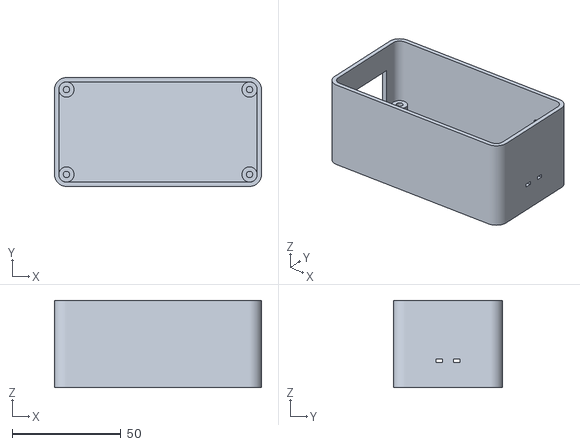
[picture p34: CAD file, 2016-09-28]
boards/1.0/3D/TIIC Power Supply/STL/TIIC Power Supply (Box).stl
95.0 x 50.0 x 40.0
