b105-h2h/h2h/boards/1.0/3D/TIIC Power Supply/Touchscreen.step

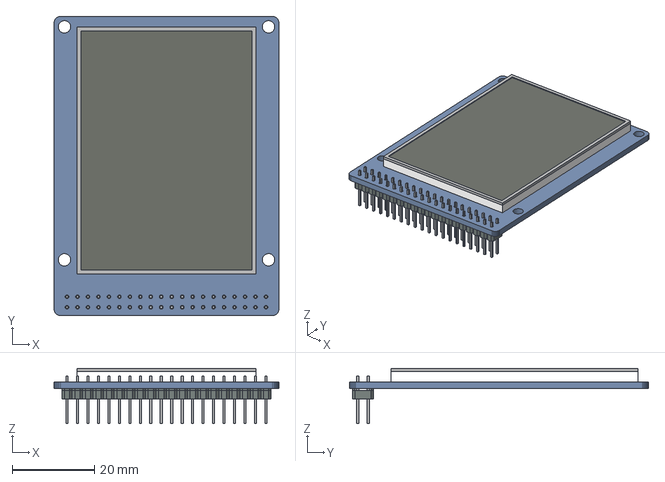
[picture p35: CAD file, 2016-09-28]
boards/1.0/3D/TIIC Power Supply/Touchscreen.step
54.5 x 72.5 x 13.4 mm
Board
Extruded x 103
