b105-h2h/h2h/boards/2.0/3D/Print Service/2016-03-29 Print Service/Kiwi Charger Print v1.2 - Bottom.stl

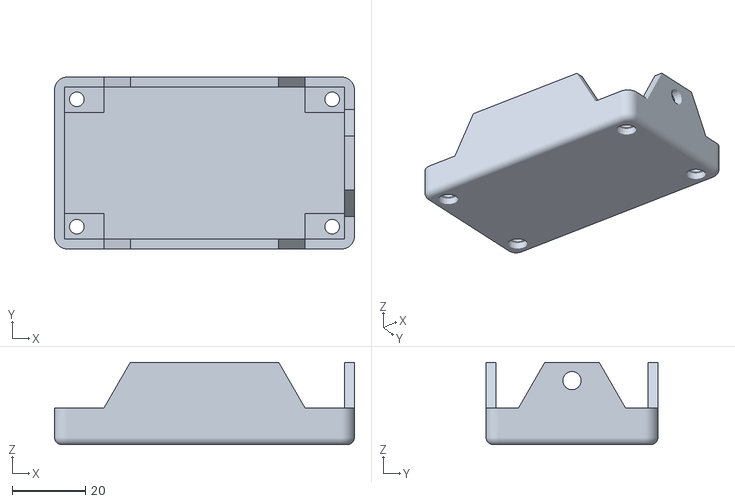
[picture p36: CAD file, 2016-09-28]
boards/2.0/3D/Print Service/2016-03-29 Print Service/Kiwi Charger Print v1.2 - Bottom.stl
82.0 x 47.0 x 22.5
