b105-h2h/h2h/boards/2.0/3D/Print Service/2016-06-01 Print Service/Persimmon Access Device Print v1.2 - Top.stl

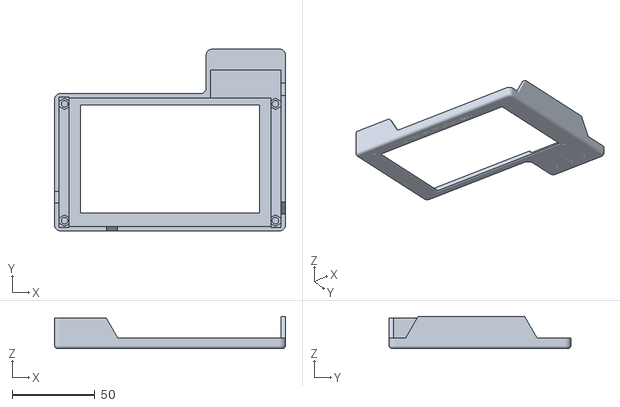
[picture p37: CAD file, 2016-09-28]
boards/2.0/3D/Print Service/2016-06-01 Print Service/Persimmon Access Device Print v1.2 - Top.stl
139.7 x 109.9 x 19.6
