b105-h2h/h2h/boards/2.0/3D/Prototypes/Persimmon Access Device/Persimmon Access Device v2.1/STL/Persimmon Access Device Print v2.1 - Top.stl

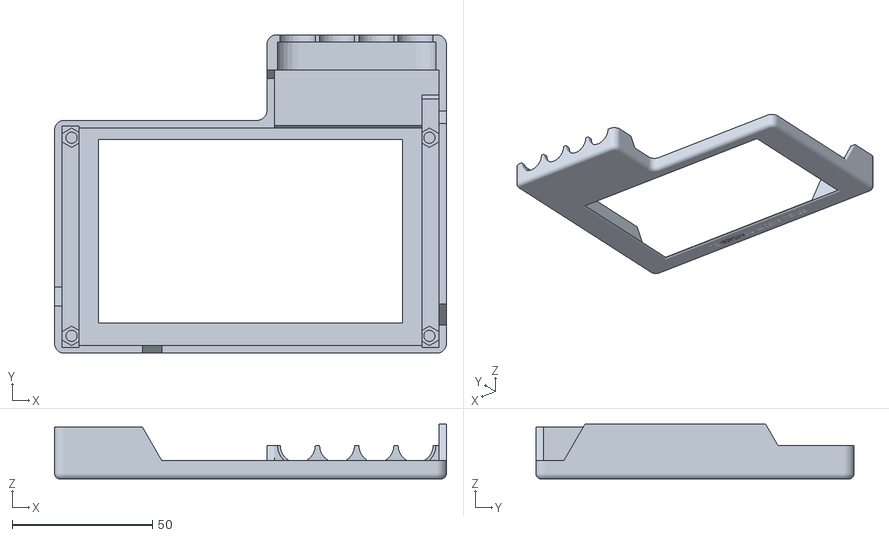
[picture p38: CAD file, 2016-09-28]
boards/2.0/3D/Prototypes/Persimmon Access Device/Persimmon Access Device v2.1/STL/Persimmon Access Device Print v2.1 - Top.stl
139.7 x 113.5 x 19.6
