b105-h2h/h2h/boards/2.0/3D/Print Service/2016-07-07 Result/Persimmon Pacemaker Print v2.0 - Top.stl

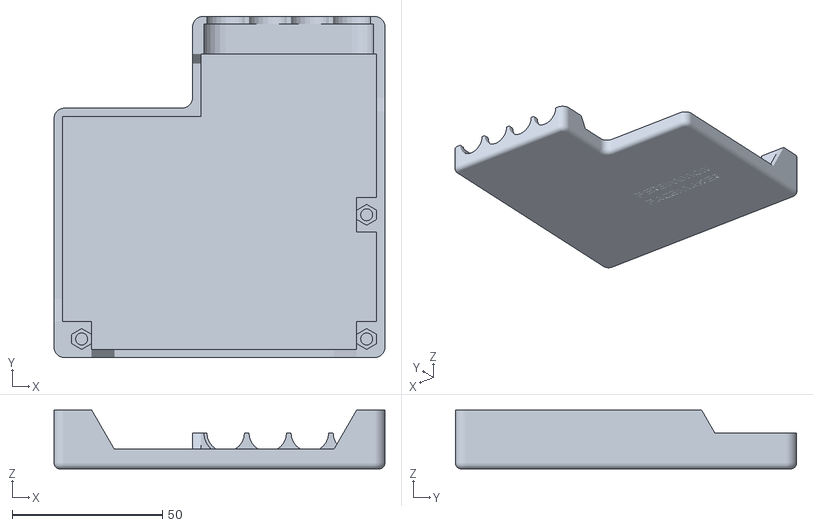
[picture p39: CAD file, 2016-09-28]
boards/2.0/3D/Print Service/2016-07-07 Result/Persimmon Pacemaker Print v2.0 - Top.stl
110.1 x 113.5 x 19.6
