b105-h2h/h2h/boards/2.0/3D/Print Service/2016-03-29 Print Service/Persimmon Pacemaker Print v1.1 - Bottom.stl

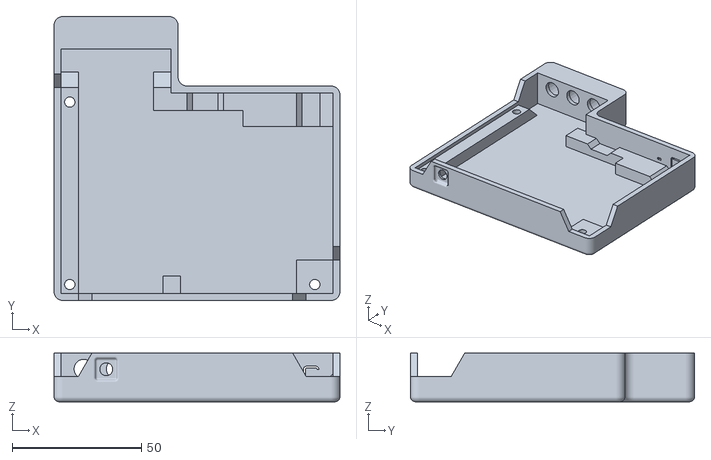
[picture p40: CAD file, 2016-09-28]
boards/2.0/3D/Print Service/2016-03-29 Print Service/Persimmon Pacemaker Print v1.1 - Bottom.stl
110.7 x 109.9 x 18.8
