b105-h2h/h2h/(list of files, cad)

Other CAD files:
boards/1.0/3D/TIIC Main Board/TIIC Main Board STL/TIIC Main Board (print).stl
boards/2.0/H2H Power Supply v1.1/Output/3D Models/Power Supply.step
boards/2.0/3D/Print Service/2016-07-07 Result/Persimmon Pacemaker Print v2.0 - Bottom.stl
boards/2.0/3D/Prototypes/Kiwi Charger/Kiwi Charger v2.0/STL/Kiwi Charger Print v2.0 - Bottom.stl
boards/2.0/3D/Prototypes/Persimmon Pacemaker/Persimmon Pacemaker v2.1/STL/Persimmon Pacemaker Belt Holder Print v2.1.stl
boards/2.0/3D/Resources/3D Lib/Banana PCB/ct3151sp-6-BLU-300.STEP
boards/2.0/3D/Print Service/2016-03-29 Print Service/Persimmon Pacemaker Belt Holder v1.1.stl
boards/2.0/3D/Print Service/2016-06-01 Result v1.3/Kiwi Charger Print v1.3 - Top.stl
boards/2.0/3D/Print Service/2016-07-13 Final Result/Kiwi Charger Print v2.0 - Bottom.stl
boards/2.0/3D/Print Service/2016-03-29 Print Service/Persimmon Pacemaker Print v1.1 - Top.stl
boards/2.0/3D/Print Service/2016-07-07 Result/Kiwi Charger Print v2.0 - Bottom.stl
boards/2.0/3D/Print Service/2016-07-13 Final Result/Persimmon Pacemaker Belt Holder Print v2.1.stl
boards/2.0/3D/Print Service/2016-03-29 Print Service/Kiwi Charger Print v1.2 - Top.stl
boards/2.0/3D/Print Service/2016-06-01 Result v1.3/Kiwi Charger Print v1.3 - Bottom.stl
boards/2.0/3D/Print Service/2016-07-07 Result/Persimmon Access Device Print v2.0 - Bottom.stl
boards/2.0/3D/Print Service/2016-03-29 Print Service/Persimmon Access Device Print v1.1 - Bottom.stl
boards/2.0/3D/Print Service/2016-07-07 Result/Persimmon Pacemaker Belt Holder Print v2.0.stl
boards/1.0/3D/TIIC Main Board/TIIC Main Board (hollow screen print).skp
boards/1.0/3D/TIIC Main Board/TIIC Main Board (hollow screen).skp
boards/1.0/3D/TIIC Main Board/TIIC Main Board (print).skp
boards/1.0/3D/TIIC Main Board/TIIC Main Board STL/TIIC Main Board (old print Alfonso).stl
boards/1.0/3D/TIIC Main Board/TIIC Main Board.skp
boards/1.0/3D/TIIC Power Supply/STL/deprecated/TIIC Power Supply.stl
boards/1.0/3D/TIIC Power Supply/TIIC Power Supply (With text).skp
boards/2.0/3D/Prototypes/Kiwi Charger/Kiwi Charger v1.0/Kiwi Charger Merged v1.0.skp
boards/2.0/3D/Prototypes/Kiwi Charger/Kiwi Charger v1.0/Kiwi Charger Print v1.0.skp
boards/2.0/3D/Prototypes/Kiwi Charger/Kiwi Charger v1.0/Kiwi Charger v1.0.skp
boards/2.0/3D/Prototypes/Kiwi Charger/Kiwi Charger v1.0/STL/Kiwi Charger Print v1.0.stl
boards/2.0/3D/Prototypes/Kiwi Charger/Kiwi Charger v1.1/Kiwi Charger Merged v1.1.skp
boards/2.0/3D/Prototypes/Kiwi Charger/Kiwi Charger v1.1/Kiwi Charger Print v1.1.skp
boards/2.0/3D/Prototypes/Kiwi Charger/Kiwi Charger v1.1/Kiwi Charger v1.1.skp
boards/2.0/3D/Prototypes/Kiwi Charger/Kiwi Charger v1.1/STL/Kiwi Charger Print v1.1.stl
boards/2.0/3D/Prototypes/Kiwi Charger/Kiwi Charger v1.2/Kiwi Charger v1.2.skp
boards/2.0/3D/Prototypes/Kiwi Charger/Kiwi Charger v1.2/Print/Kiwi Charger Print v1.2.skp
boards/2.0/3D/Prototypes/Kiwi Charger/Kiwi Charger v1.2/STL/Kiwi Charger Print v1.2 - Top.stl
boards/2.0/3D/Prototypes/Kiwi Charger/Kiwi Charger v1.3/Kiwi Charger v1.3.skp
boards/2.0/3D/Prototypes/Kiwi Charger/Kiwi Charger v1.3/Print/Kiwi Charger Print v1.3.skp
boards/2.0/3D/Prototypes/Kiwi Charger/Kiwi Charger v1.3/STL/Kiwi Charger Print v1.3 - Bottom.stl
boards/2.0/3D/Prototypes/Kiwi Charger/Kiwi Charger v1.3/STL/Kiwi Charger Print v1.3 - Top.stl
boards/2.0/3D/Prototypes/Kiwi Charger/Kiwi Charger v2.0/Kiwi Charger v2.0.skp
boards/2.0/3D/Prototypes/Kiwi Charger/Kiwi Charger v2.0/Print/Kiwi Charger Print v2.0.skp
boards/2.0/3D/Prototypes/Persimmon Access Device/Persimmon Access Device v1.0/Persimmon Access Device Print v1.0.skp
boards/2.0/3D/Prototypes/Persimmon Access Device/Persimmon Access Device v1.0/STL/Persimmon Access Device Print v1.0.stl
boards/2.0/3D/Prototypes/Persimmon Access Device/Persimmon Access Device v1.1/STL/Persimmon Access Device Print v1.1 - Bottom.stl
boards/2.0/3D/Prototypes/Persimmon Access Device/Persimmon Access Device v2.0/Print/Persimmon Access Device Print v2.0.skp
boards/2.0/3D/Prototypes/Persimmon Access Device/Persimmon Access Device v2.0/STL/Persimmon Access Device Print v2.0 - Bottom.stl
boards/2.0/3D/Prototypes/Persimmon Access Device/Persimmon Access Device v2.1/Print/Persimmon Access Device Print v2.1.skp
boards/2.0/3D/Prototypes/Persimmon Pacemaker/Persimmon Pacemaker v1.0/Persimmon Pacemaker v1.0.skp
boards/2.0/3D/Prototypes/Persimmon Pacemaker/Persimmon Pacemaker v1.1/Persimmon Pacemaker Belt Holder v1.1.skp
boards/2.0/3D/Prototypes/Persimmon Pacemaker/Persimmon Pacemaker v1.1/STL/Persimmon Pacemaker Belt Holder v1.1.stl
boards/2.0/3D/Prototypes/Persimmon Pacemaker/Persimmon Pacemaker v1.1/STL/Persimmon Pacemaker Print v1.1 - Top.stl
boards/2.0/3D/Prototypes/Persimmon Pacemaker/Persimmon Pacemaker v1.2/Persimmon Pacemaker Belt Holder v1.2.skp
boards/2.0/3D/Prototypes/Persimmon Pacemaker/Persimmon Pacemaker v1.2/STL/Persimmon Pacemaker Print v1.2 - Top.stl
boards/2.0/3D/Prototypes/Persimmon Pacemaker/Persimmon Pacemaker v1.3/Persimmon Pacemaker Belt Holder v1.3.skp
boards/2.0/3D/Prototypes/Persimmon Pacemaker/Persimmon Pacemaker v2.0/Persimmon Pacemaker Belt Holder v2.0.skp
boards/2.0/3D/Prototypes/Persimmon Pacemaker/Persimmon Pacemaker v2.0/Print/Persimmon Pacemaker Belt Holder Print v2.0.skp
boards/2.0/3D/Prototypes/Persimmon Pacemaker/Persimmon Pacemaker v2.0/Print/Persimmon Pacemaker Print v2.0.skp
boards/2.0/3D/Prototypes/Persimmon Pacemaker/Persimmon Pacemaker v2.0/STL/Persimmon Pacemaker Belt Holder Print v2.0.stl
boards/2.0/3D/Prototypes/Persimmon Pacemaker/Persimmon Pacemaker v2.0/STL/Persimmon Pacemaker Print v2.0 - Bottom.stl
boards/2.0/3D/Prototypes/Persimmon Pacemaker/Persimmon Pacemaker v2.1/Persimmon Pacemaker Belt Holder v2.1.skp
boards/2.0/3D/Prototypes/Persimmon Pacemaker/Persimmon Pacemaker v2.1/Print/Persimmon Pacemaker Belt Holder Print v2.1.skp
boards/2.0/3D/Prototypes/Persimmon Pacemaker/Persimmon Pacemaker v2.1/Print/Persimmon Pacemaker Print v2.1.skp
boards/2.0/3D/Resources/3D Lib/Banana PCB/Banana PCB.skp
boards/2.0/3D/Resources/3D Lib/Banana PCB/Exports/Banana PCB.FCStd
boards/2.0/3D/Resources/3D Lib/Banana PCB/Exports/Banana PCB.stl
boards/2.0/3D/Resources/3D Lib/Banana PCB/ct3151sp-6.FCStd
boards/2.0/3D/Resources/3D Lib/Nut M3-0.5.skp
boards/2.0/3D/Resources/3D Lib/Screw M3x0.5 20mm.skp
boards/2.0/3D/Resources/3D Lib/Screw M3x0.5 25mm.skp
boards/2.0/3D/Resources/3D Lib/Screw M3x0.5 5mm.skp
boards/2.0/3D/Resources/Kiwi/Board - Kiwi/Kiwi Board.FCStd
boards/2.0/3D/Resources/Persimmon/Board - Persimmon/Persimmon Board.FCStd
boards/2.0/3D/Resources/Persimmon/Board - Screen/Screen.FCStd
boards/2.0/H2H Main Board v1.0/3D/Screen.skp
boards/2.0/H2H Main Board v1.1/Output/3D Models/Main Board.FCStd
boards/2.0/H2H Main Board v1.1/Res/3D/Screen.skp
boards/2.0/H2H Power Supply v1.1/Output/3D Models/Power Supply.FCStd
