b105-h2h/h2h/boards/2.0/3D/Print Service/2016-06-01 Result v1.3/README.txt

Samuel López Asunción
ETSI Telecomunicación - UPM B105Lab
samuel.lopez.asuncion@alumnos.upm.es

Software de diseño:	SketchUp Make 15.3
Slicer:			Cura 15.04
Perfil de impresión:	BQ Witbox 2 - PLA - Medium Quality (altura de capa = 0.2 mm)
Color preferido:	Blanco/Azul/Gris

							Tiempo		Longitud	Peso		X		Y		Z

Kiwi Charger Print v1.3 - Bottom			1h 27m		5.99 m		18 g		82 mm		47 mm		22.5 mm
Kiwi Charger Print v1.3 - Top				1h 39m		7.06 m		21 g		82 mm		47 mm		25 mm
Persimmon Access Device Print v1.2 - Bottom		4h 25m		18.37 m		55 g		139.7 mm	109.9 mm	21 mm
Persimmon Access Device Print v1.2 - Top		1h 41m		6.83 m		20 g		139.7 mm	109.9 mm	19.6 mm
Persimmon Pacemaker Belt Holder v1.3			39m		2.57 m		8 g		50 mm		8 mm		50 mm
Persimmon Pacemaker Print v1.3 - Bottom			3h 37m		14.93 m		45 g		113.1 mm	109.9 mm	18.8 mm
Persimmon Pacemaker Print v1.3 - Top			2h 46m		12.01 m		36 g		113.1 mm	109.9 mm	15.6 mm
