b105-h2h/h2h/boards/2.0/3D/Print Service/2016-07-07 Result/README.txt

Samuel López Asunción
ETSI Telecomunicación - UPM B105Lab
samuel.lopez.asuncion@alumnos.upm.es

Software de diseño:	SketchUp Make 15.3
Slicer:			Cura 15.04
Perfil de impresión:	BQ Witbox 2 - PLA - Medium Quality (altura de capa = 0.2 mm)
Color preferido:	Blanco/Azul/Gris

							Tiempo		Longitud	Peso		X		Y		Z

Kiwi Charger Print v2.0 - Bottom			1h 27m		5.99 m		18 g		82 mm		47 mm		22.5 mm
Kiwi Charger Print v2.0 - Top				1h 41m		6.90 m		21 g		82 mm		47 mm		25 mm
Persimmon Access Device Print v2.0 - Bottom		4h 17m		18.04 m		54 g		139.7 mm	113.5 mm	21 mm
Persimmon Access Device Print v2.0 - Top		1h 53m		7.50 m		22 g		139.7 mm	113.5 mm	19.6 mm
Persimmon Pacemaker Belt Holder v2.0			39m		2.57 m		8 g		50 mm		8 mm		50 mm
Persimmon Pacemaker Print v2.0 - Bottom			3h 41m		15.42 m		46 g		110.1 mm	113.5 mm	22.8 mm
Persimmon Pacemaker Print v2.0 - Top			3h 4m		12.95 m		39 g		110.1 mm	113.5 mm	19.6 mm
