b105-h2h/h2h/code/res/matlab_testerino/Filter coef.xlsx

LP FIR 1 KSPS (f3dB = 151) |  |  |  | LP FIR 1 KSPS (f3dB = 41) |  |  |  | DIFF FIR 1KSPS(Fc = 35 Hz) |  |  |  | DIFF FIR 1KSPS(all pass) |  |  |  | sintonizer num |  |  | sintonizer dem
fpass = 145 | fstop=165 | ripple = 0.1 | at = 60 | fpass = 35 | fstop=55 | ripple = 0.1 | at = 60 | fpass = 35 | fstop=55 | ripple = 1 | at = 60 | fpass = 35 | fstop=55 | ripple = 0.1 | at = 60
-0.0003283035223 | -0.3361828068 | 0 | 0 | 0.0004901222743 | 0.5018852089 | 1 | 1 | -2.447926236e-05 | -0.02506676465 | 0 | 0 | 0.01963494451 | 20.10618318 | 20 | 20 | 0.5960861831 | 610 | 610 | 1 | 1024 | 1024
0.0005393883425 | 0.5523336627 | 1 | 0, 1 | -7.75248313e-07 | -0.0007938542725 | 0 | 1, 0 | -1.020104012e-06 | -0.001044586508 | 0 | 0, 0 | -0.03861118164 | -39.53785 | -40 | 20, -40 | -2.384339431 | -2442 | 610, -2442 | -3.153940376 | -3230 | 1024, -3230
0.001022713493 | 1.047258617 | 1 | 0, 1, 1 | -5.356529204e-05 | -0.05485085905 | 0 | 1, 0, 0 | 9.367662816e-07 | 0.0009592486724 | 0 | 0, 0, 0 | 0.05499172569 | 56.31152711 | 56 | 20, -40, 56 | 3.943095568 | 4038 | 610, -2442, 4038 | 3.943095568 | 4038 | 1024, -3230, 4038
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
