b105-h2h/h2h/code/res/matlab_testerino/stored probability.xlsx

Pe4= | 0.009 |  | Qe1 | 0.5
Pe3= | 0.018
Pe2= | 0.039
Pe1= | 0.08
 | 0 | 1 | 2 | 3 | 4 | 5 | 6 | 7 | 8 | 9 | 10 | 11 | 12 | 13 | 14 | 15 | 16
Q(x4) | 0.8653234473 | 0.1257382204 | 0.008564409563 | 0.0003629719492 | 1.071334966e-05 | 2.335099421e-07 | 3.887905192e-09 | 5.044132439e-11 | 5.15356619e-13 | 4.160295613e-15 | 2.64478934e-17 | 1.310142412e-19 | 4.957652922e-22 | 1.385356712e-24 | 2.696023585e-27 | 3.26460979e-30 | 1.853020189e-33
Q(x3) | 0.7477971482 | 0.2193132166 | 0.03014998395 | 0.00257902103 | 0.0001536382182 | 6.758829966e-06 | 2.271297239e-07 | 5.947534231e-09 | 1.226451814e-10 | 1.998292162e-12 | 2.564000126e-14 | 2.563525399e-16 | 1.957885997e-18 | 1.104244022e-20 | 4.337298311e-23 | 1.060032174e-25 | 1.214395311e-28
Q(x2) | 0.5291443981 | 0.3435859567 | 0.1045774114 | 0.01980550351 | 0.002612224318 | 0.000254426843 | 1.892978073e-05 | 1.097460158e-06 | 5.01051659e-08 | 1.807470431e-09 | 5.134645451e-11 | 1.136606788e-12 | 1.921941759e-14 | 2.399927274e-16 | 2.087048395e-18 | 1.129308185e-20 | 2.864400312e-23
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
