b105-h2h/h2h/boards/meas/H2H Power Supply debug/dep/BMP/BK000004.BMP

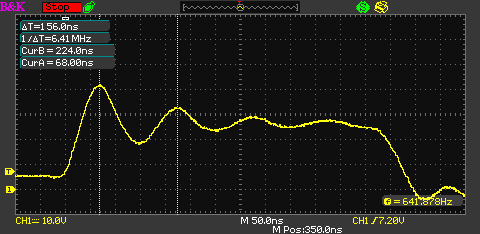
boards/meas/H2H Power Supply debug/dep/BMP/BK000004.BMP
