b105-h2h/h2h/boards/meas/H2H Power Supply debug/dep/H2H_PS_Vout_100mA_Freq_1.BMP

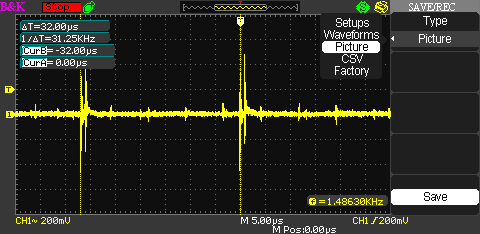
boards/meas/H2H Power Supply debug/dep/H2H_PS_Vout_100mA_Freq_1.BMP
