b105-h2h/h2h/boards/meas/H2H Power Supply debug/dep/H2H_PS_Vout_Vsec_AC.BMP

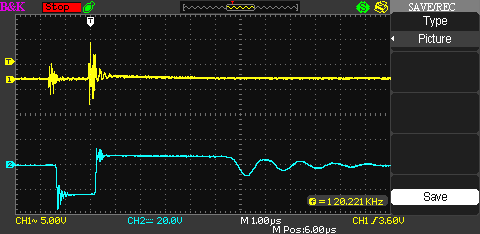
boards/meas/H2H Power Supply debug/dep/H2H_PS_Vout_Vsec_AC.BMP
