b105-h2h/h2h/boards/meas/H2H Power Supply debug/H2H_PS_Iout_500mA_100us.BMP

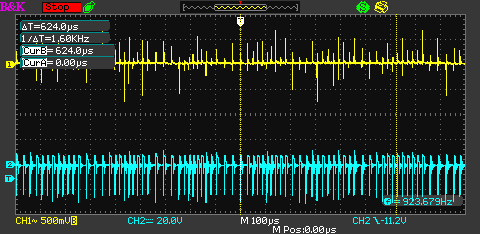
boards/meas/H2H Power Supply debug/H2H_PS_Iout_500mA_100us.BMP
