b105-h2h/h2h/boards/meas/H2H Power Supply debug/H2H_PS_PW_Iout_500mA_1us.BMP

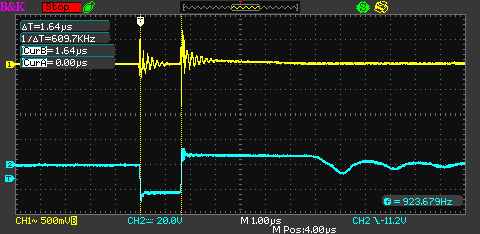
boards/meas/H2H Power Supply debug/H2H_PS_PW_Iout_500mA_1us.BMP
