b105-h2h/h2h/boards/meas/H2H Power Supply debug/H2H_PS_ResTime_FEdge_Snubber_2.BMP

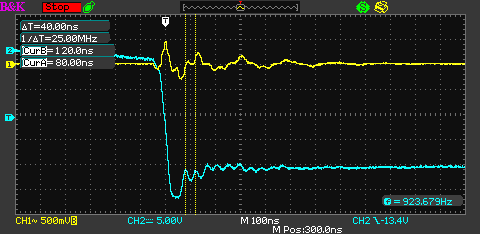
boards/meas/H2H Power Supply debug/H2H_PS_ResTime_FEdge_Snubber_2.BMP
