b105-h2h/h2h/boards/meas/H2H Power Supply debug/H2H_PS_ResTime_Primary.BMP

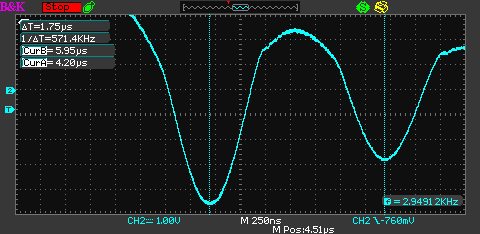
boards/meas/H2H Power Supply debug/H2H_PS_ResTime_Primary.BMP
