b105-h2h/h2h/boards/meas/H2H Power Supply debug/H2H_PS_ResTime_REdge_NoSnubber.BMP

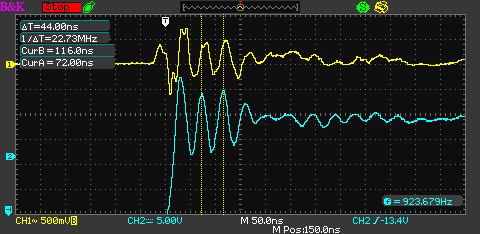
boards/meas/H2H Power Supply debug/H2H_PS_ResTime_REdge_NoSnubber.BMP
