b105-h2h/h2h/boards/2.0/H2H Main Board v1.1/Output/Schematics/H2H Main Board v1.1 (Persimmon).pdf

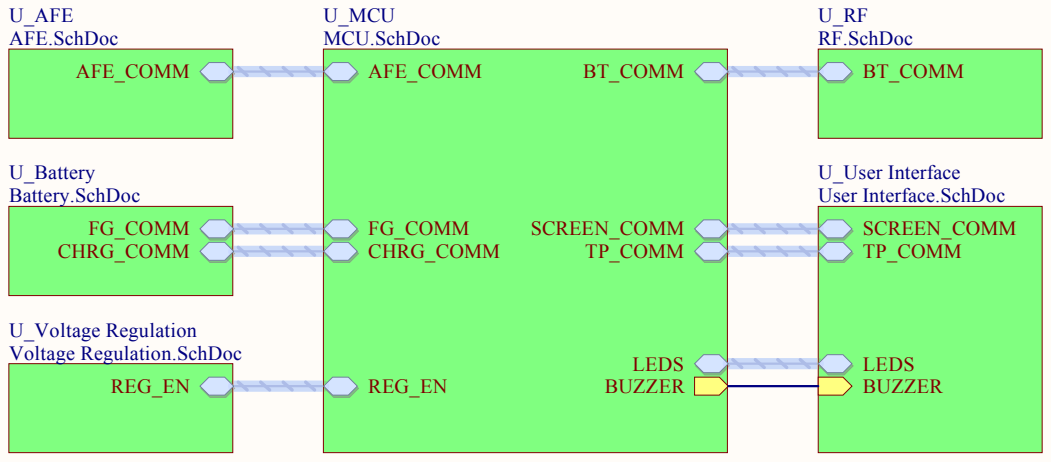
[picture p70: page 1]

Cannot open file
C:\Users\Smau\Deskt
op\IMGs\Eye\Eye.pn

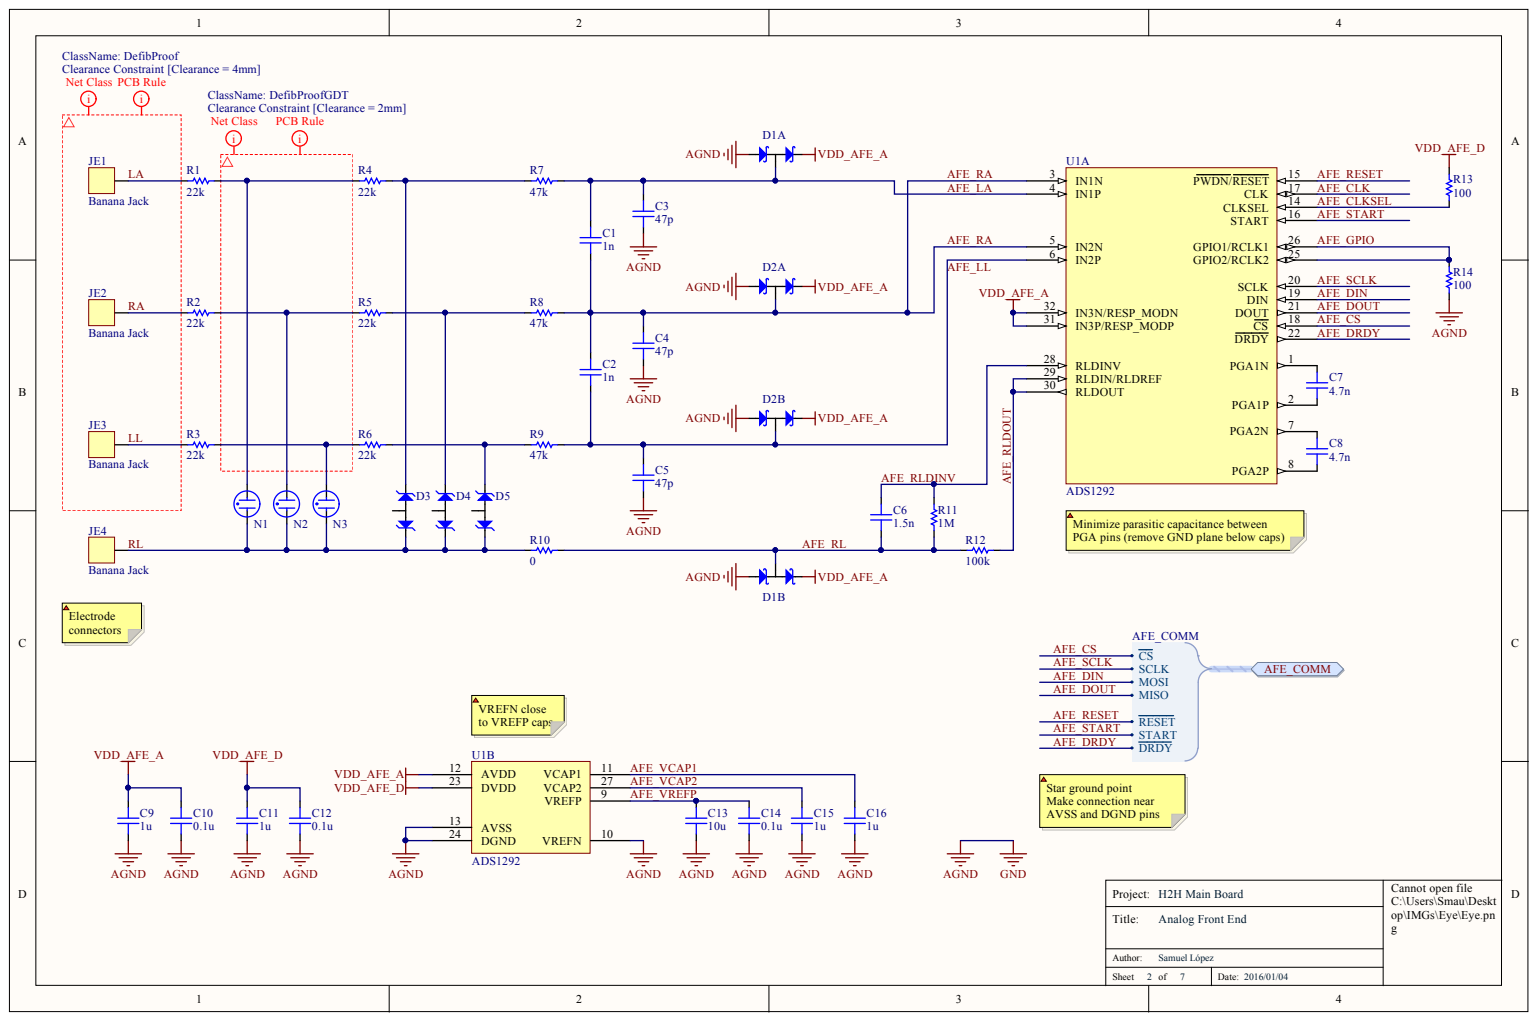
[picture p71: page 2]

IN3N/RESP_MODN 32 IN3P/RESP_MODP 31

Minimize parasitic capacitance between
PGA pins (remove GND plane below caps)

Star ground point
Make connection near
AVSS and DGND pins

Cannot open file
C:\Users\Smau\Deskt
op\IMGs\Eye\Eye.pn

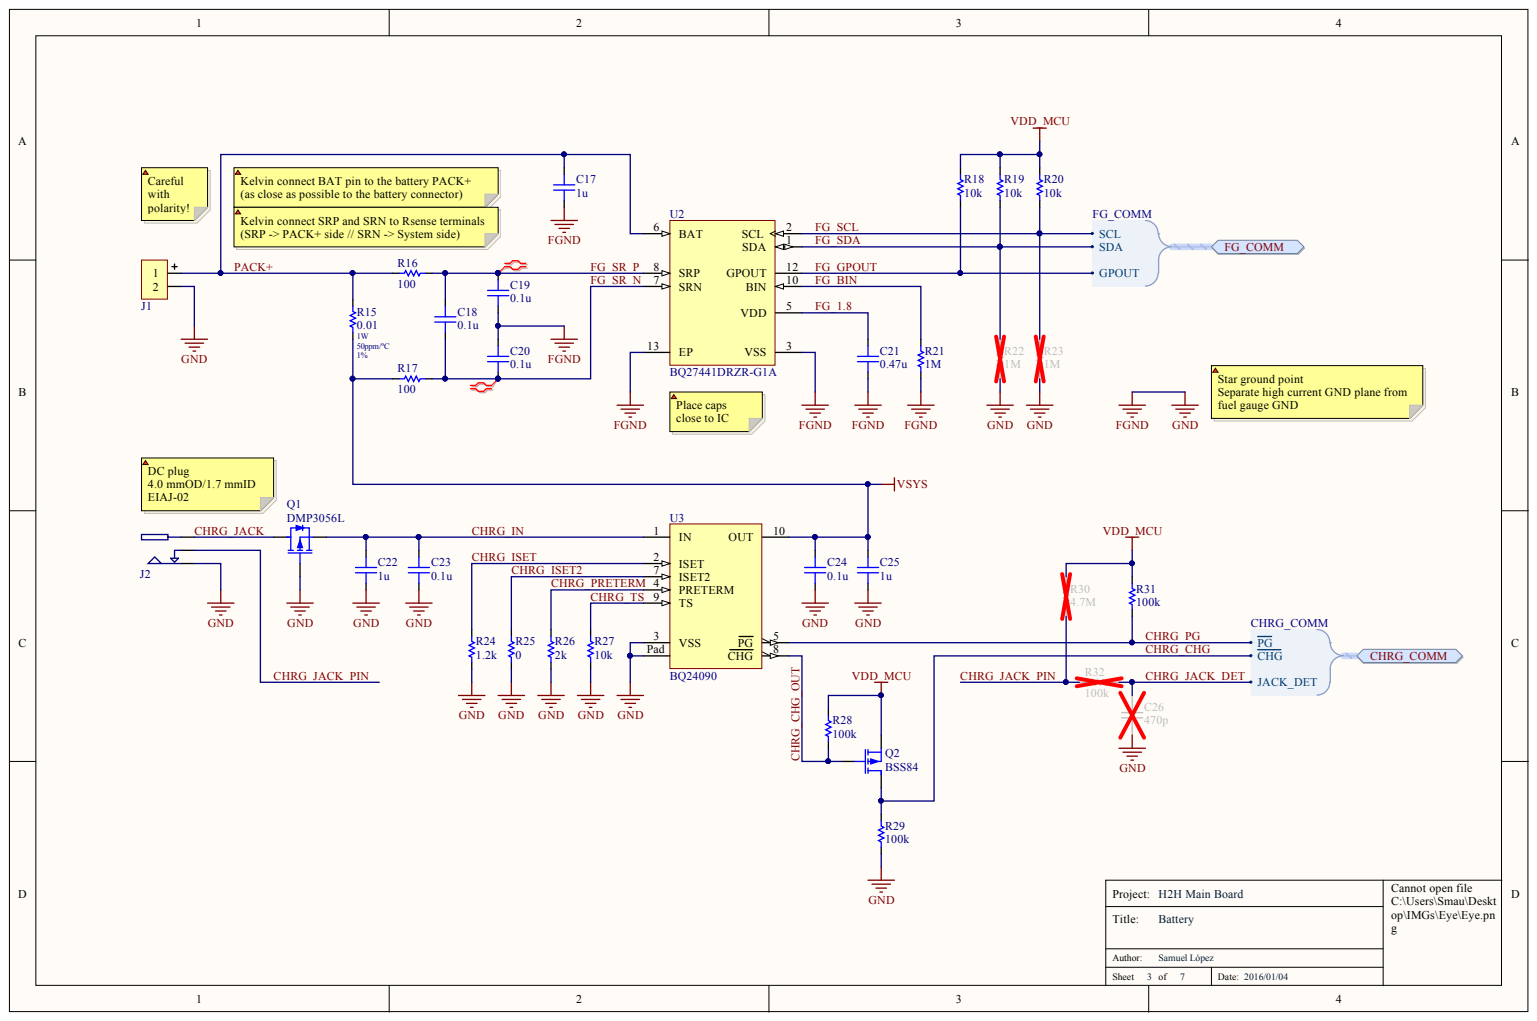
[picture p72: page 3]

Kelvin connect BAT pin to the battery PACK+
(as close as possible to the battery connector)

Kelvin connect SRP and SRN to Rsense terminals
(SRP -> PACK+ side // SRN -> System side)

Star ground point
Separate high current GND plane from
fuel gauge GND

ISET 2

CHRG_ISET2 | ISET2 7

CHRG_PRETERM | PRETERM 4

VSS 3
Pad

Q2 BSS84 | CHRG_JACK_DET

Cannot open file
C:\Users\Smau\Deskt
op\IMGs\Eye\Eye.pn

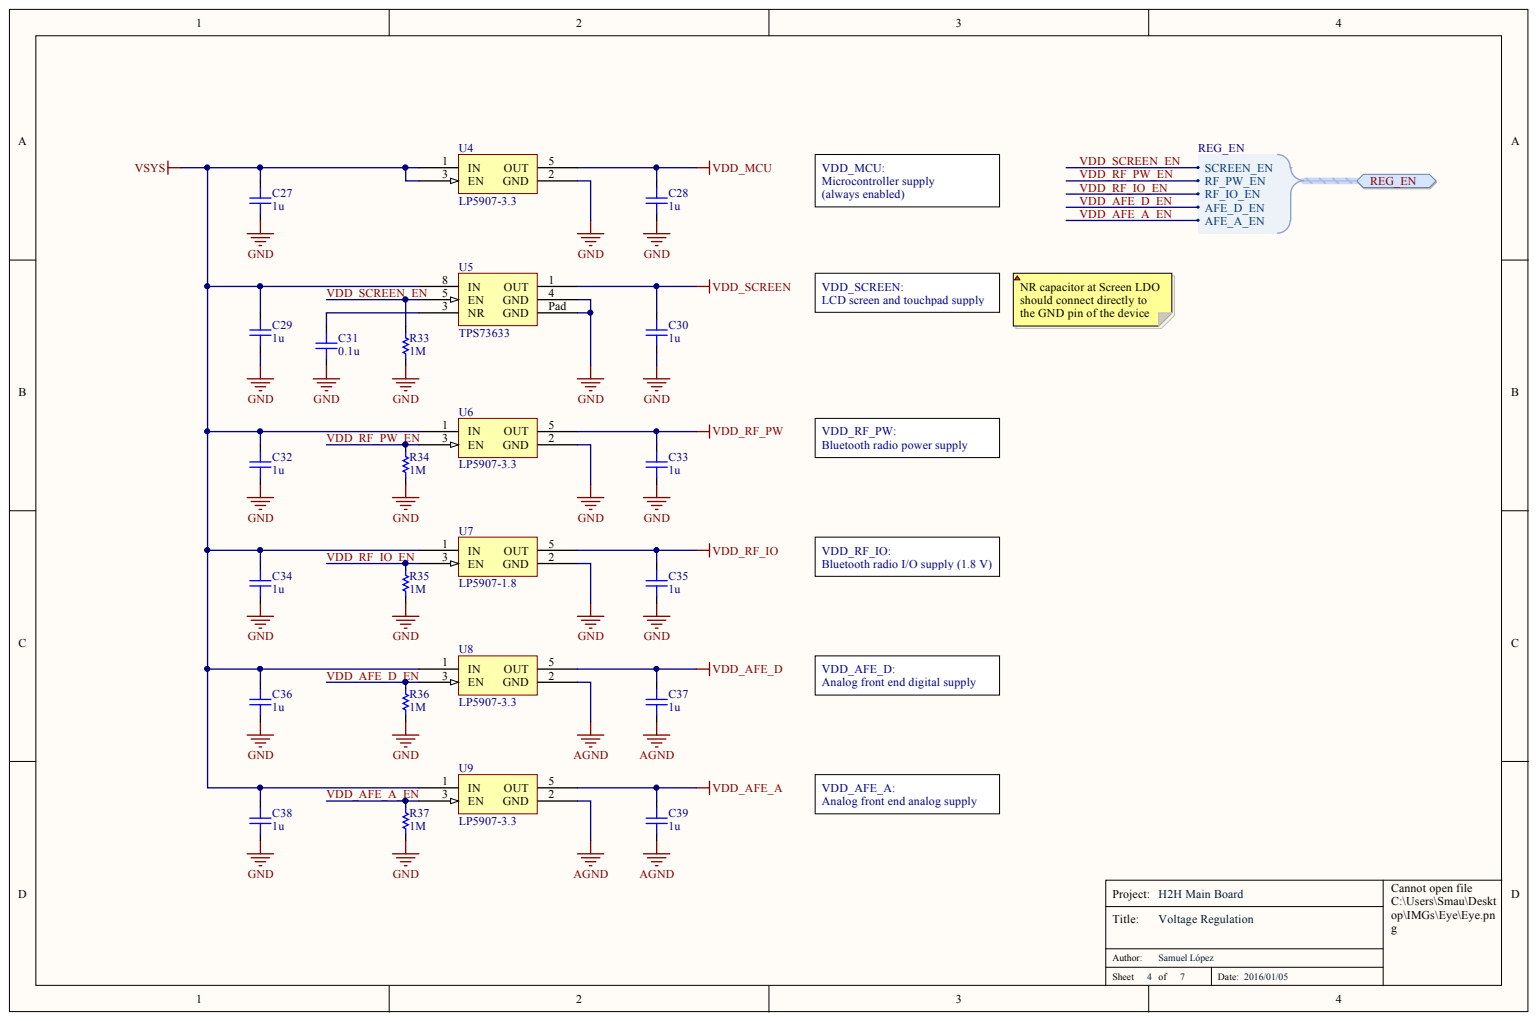
[picture p73: page 4]

G | V D D _SCRE E N _ E | N 5 | 4

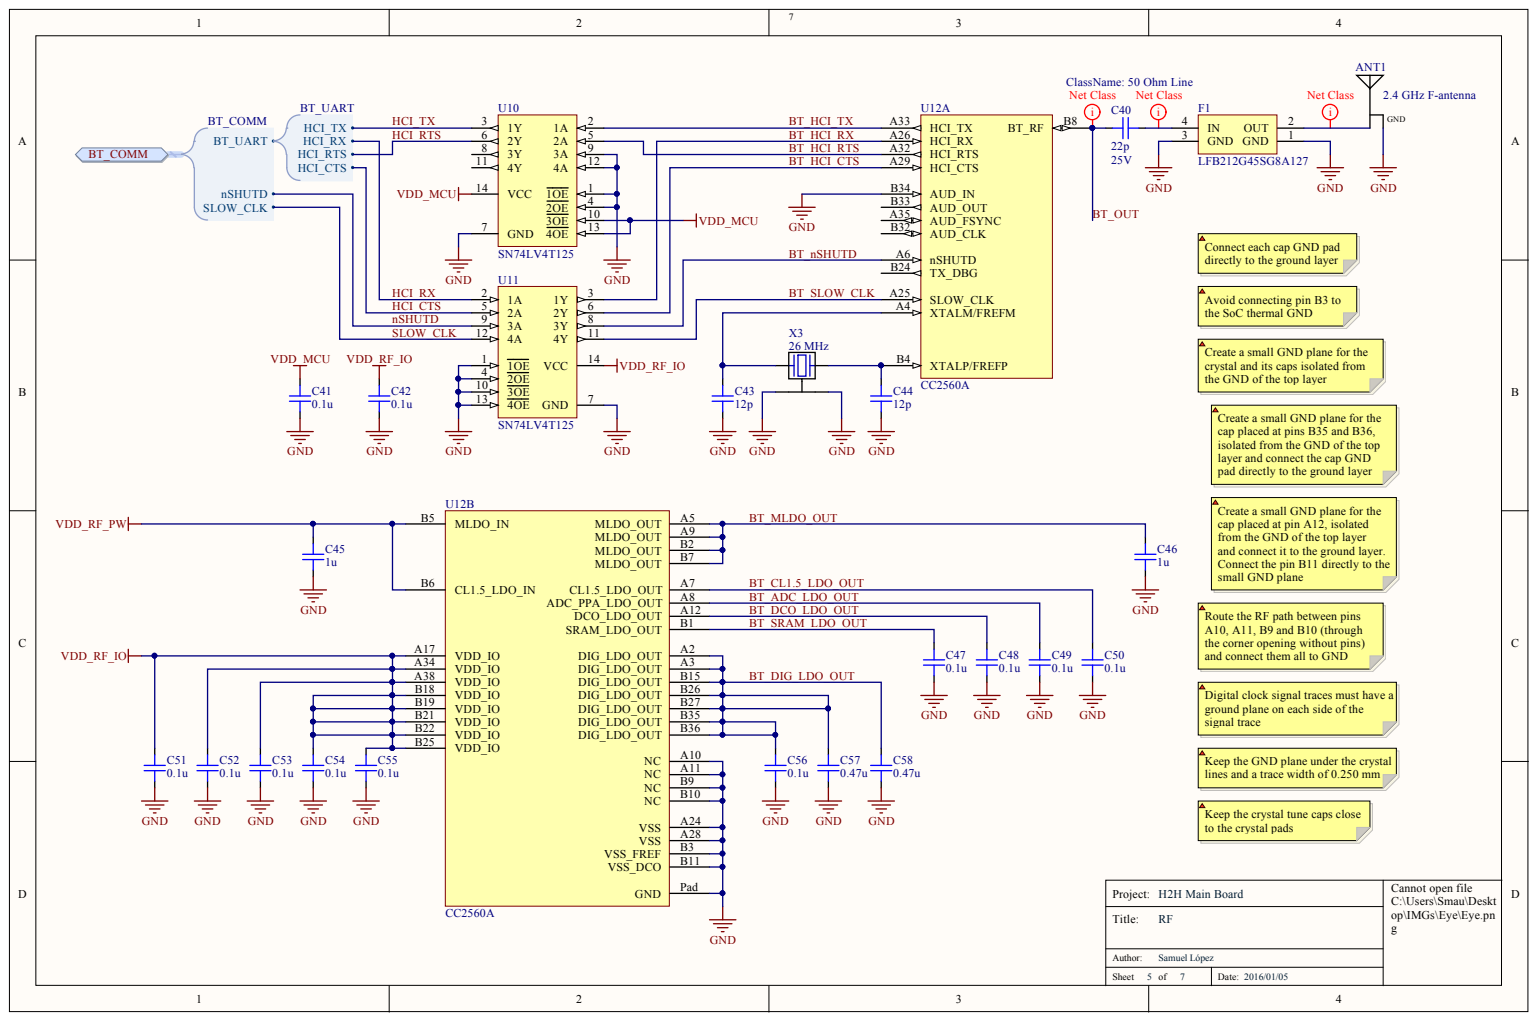
[picture p74: page 5]

Connect each cap GND pad
directly to the ground layer

Avoid connecting pin B3 to
the SoC thermal GND

SLOW_CLK | | X3

1OE 1 | 26 MHz

Create a small GND plane for the
crystal and its caps isolated from
the GND of the top layer

cap placed at pins B35 and B36,
isolated from the GND of the top
layer and connect the cap GND
pad directly to the ground layer

cap placed at pin A12, isolated
from the GND of the top layer
and connect it to the ground layer.
Connect the pin B11 directly to the
small GND plane

CL1.5_LDO_IN B6
VDD_IO A17 | | BT_ADC_LDO_OUT

BT_DCO_LDO_OUT
BT_SRAM_LDO_OUT

Route the RF path between pins
A10, A11, B9 and B10 (through
the corner opening without pins)
and connect them all to GND

VDD_IO A34
VDD_IO A38
VDD_IO B18
VDD_IO B19
VDD_IO B21
VDD_IO B22
VDD_IO B25

Digital clock signal traces must have a
ground plane on each side of the
signal trace

Keep the GND plane under the crystal
lines and a trace width of 0.250 mm

Keep the crystal tune caps close
to the crystal pads

Cannot open file
C:\Users\Smau\Deskt
op\IMGs\Eye\Eye.pn

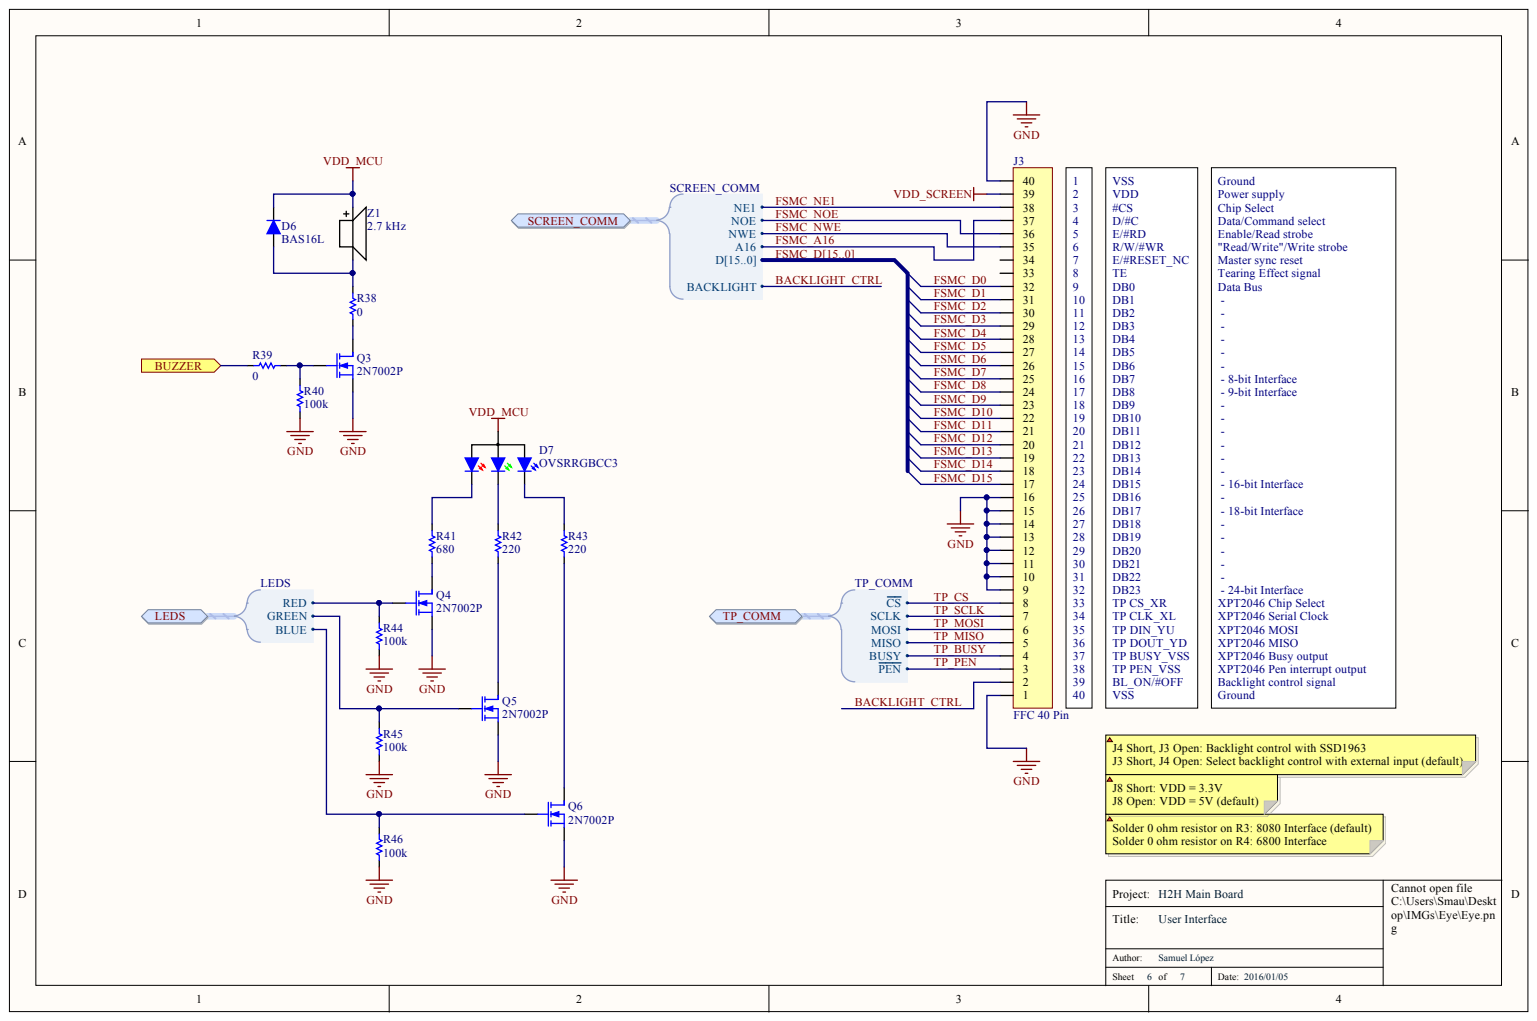
[picture p75: page 6]

FSMC_NWE
FSMC_A16

J4 Short, J3 Open: Backlight control with SSD1963
J3 Short, J4 Open: Select backlight control with external input (default)

Solder 0 ohm resistor on R3: 8080 Interface (default)
Solder 0 ohm resistor on R4: 6800 Interface

Cannot open file
C:\Users\Smau\Deskt
op\IMGs\Eye\Eye.pn

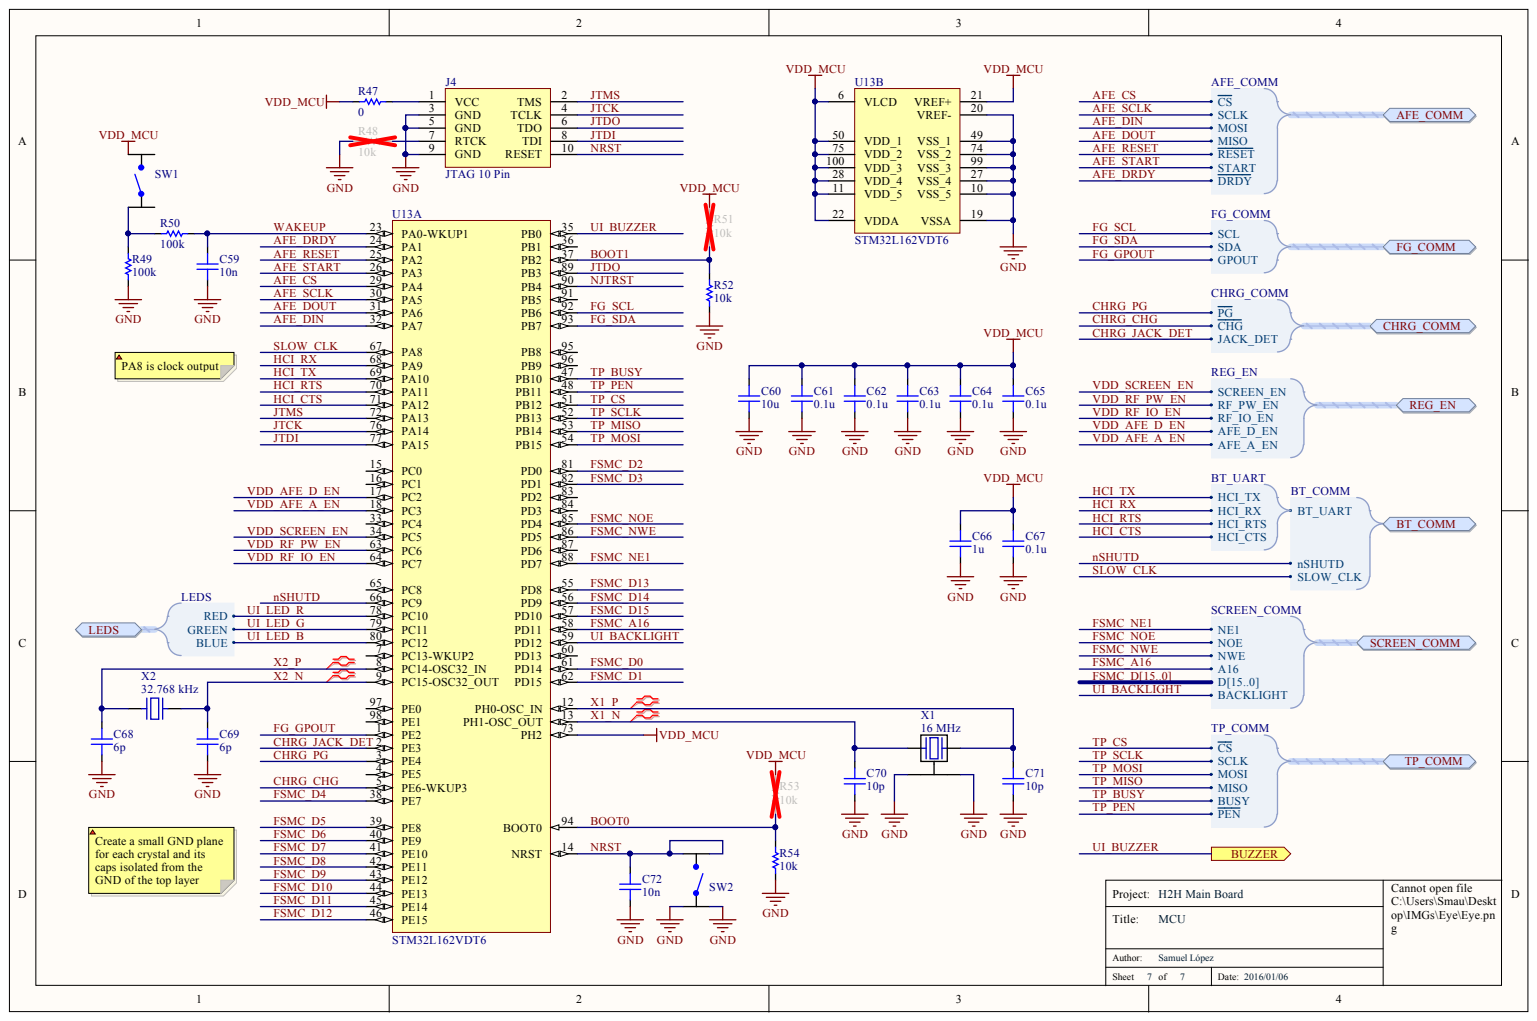
[picture p76: page 7]

7 5 | 7 4
1 0 0 | 9 9
2 8 | 2 7
1 1 | 1 0

9 | 13 PH0-OSC_IN 12 3 PH1-OSC_OUT | X 1 _N X 1
