b105-h2h/h2h/boards/2.0/H2H Power Supply v1.1/Output/PCB Prints/H2H Power Supply v1.1 (Kiwi) - PCB.pdf

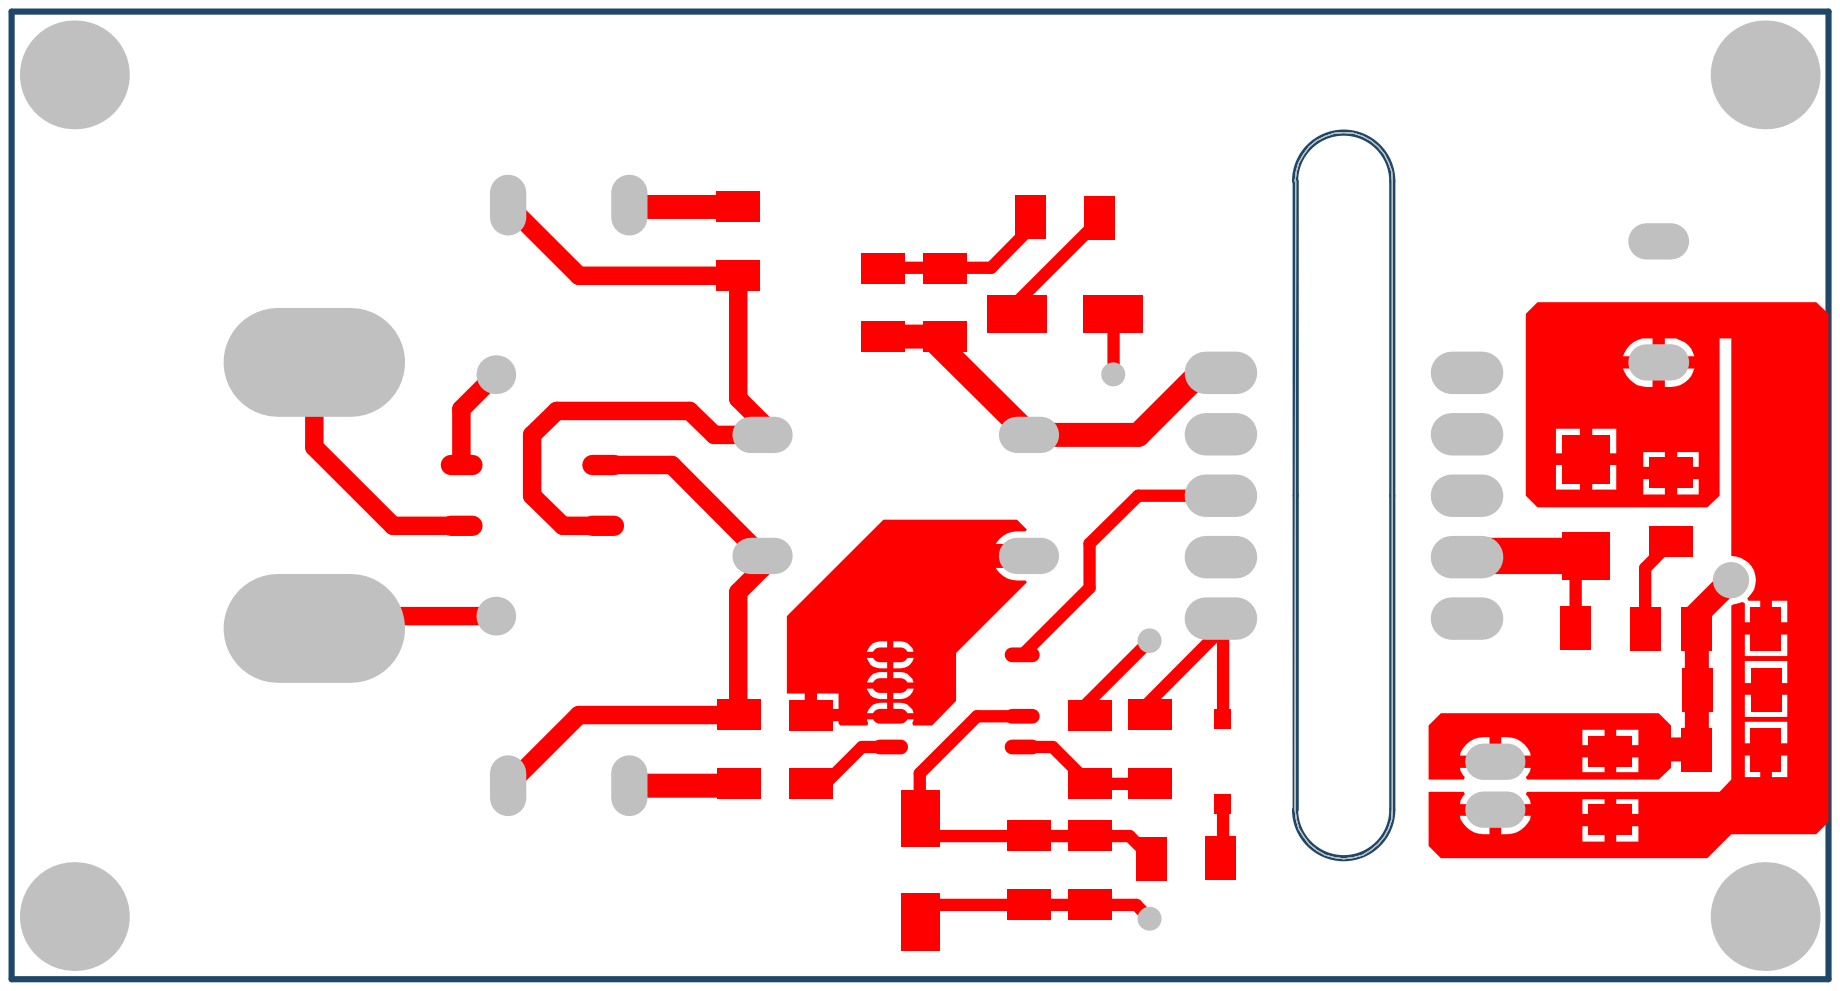
[picture p77: page 1]

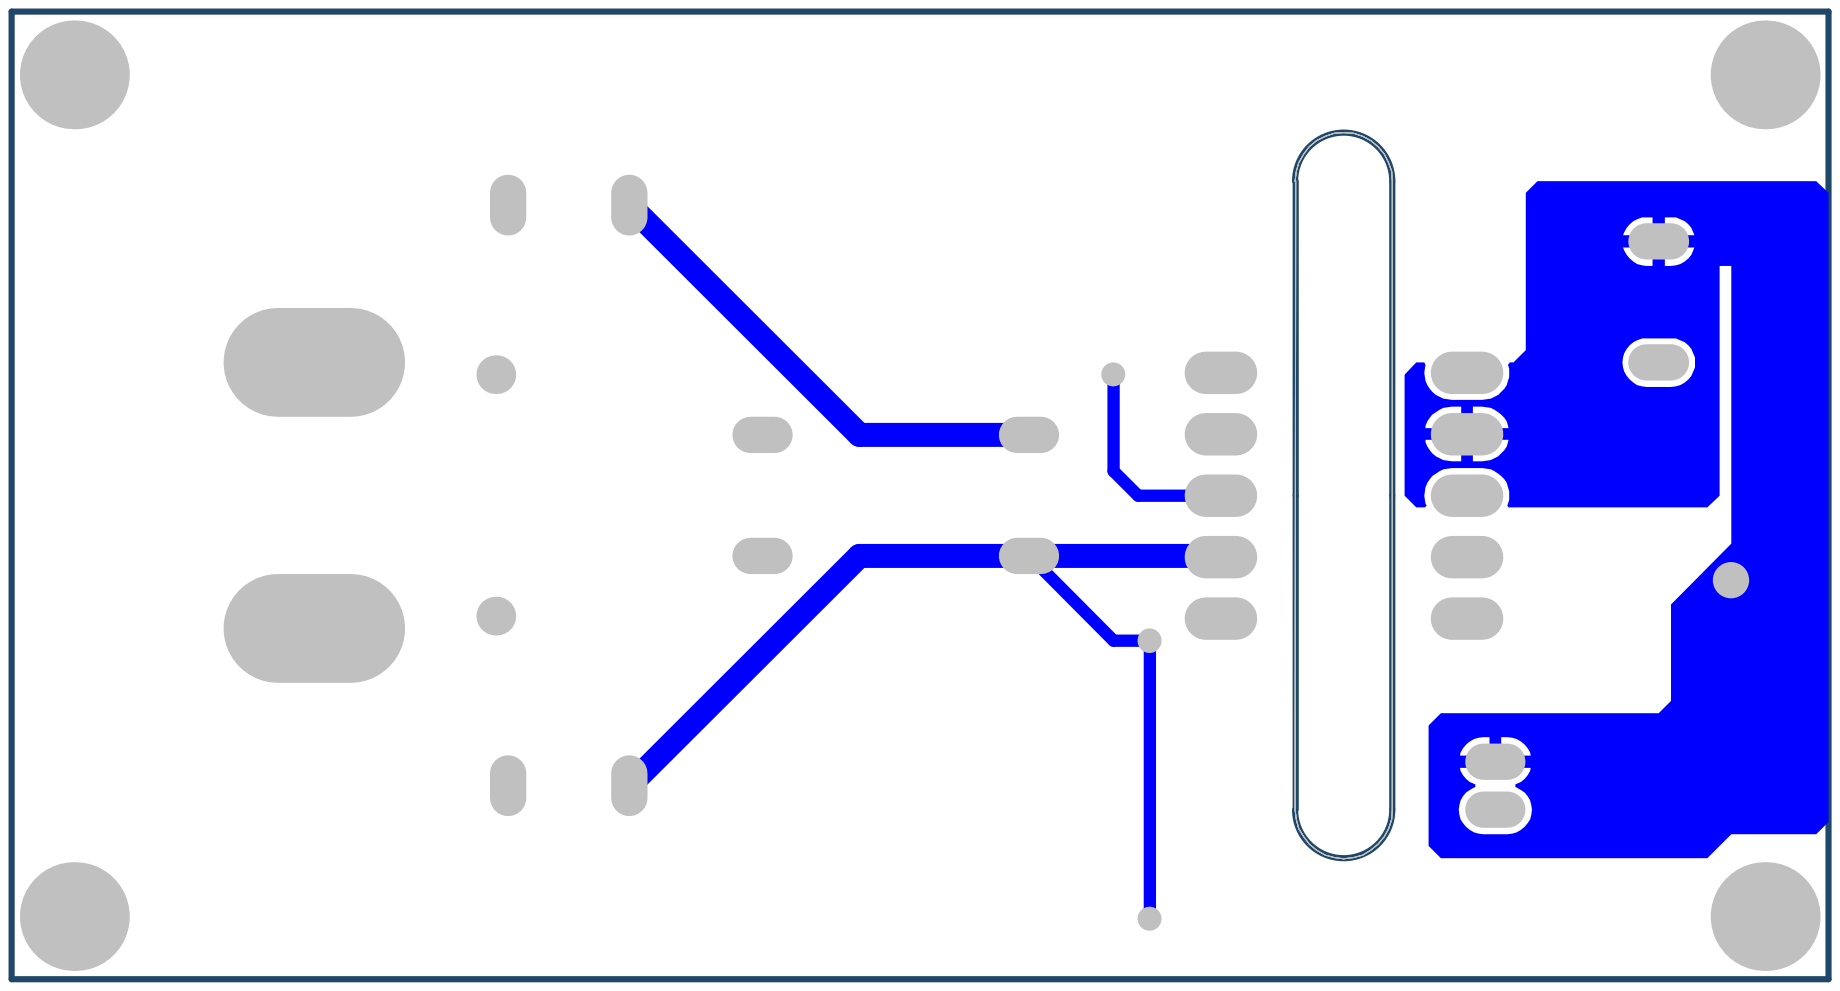
[picture p78: page 2]

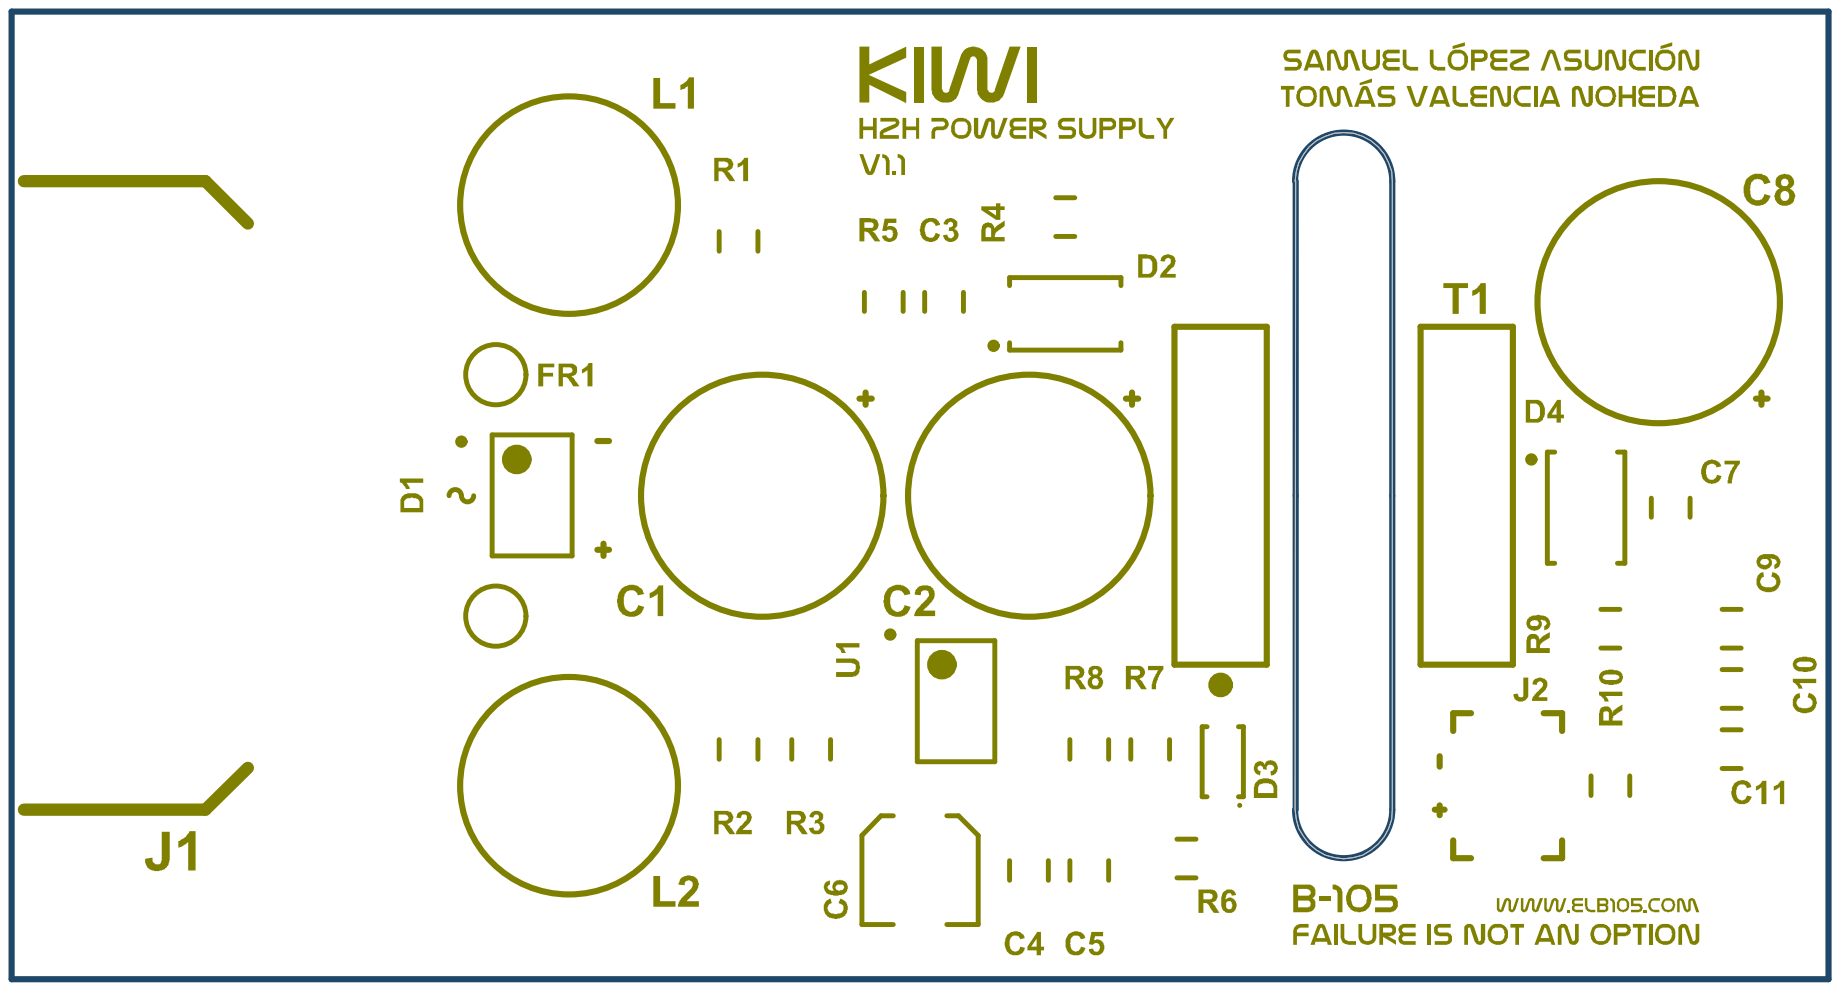
[picture p79: page 3]

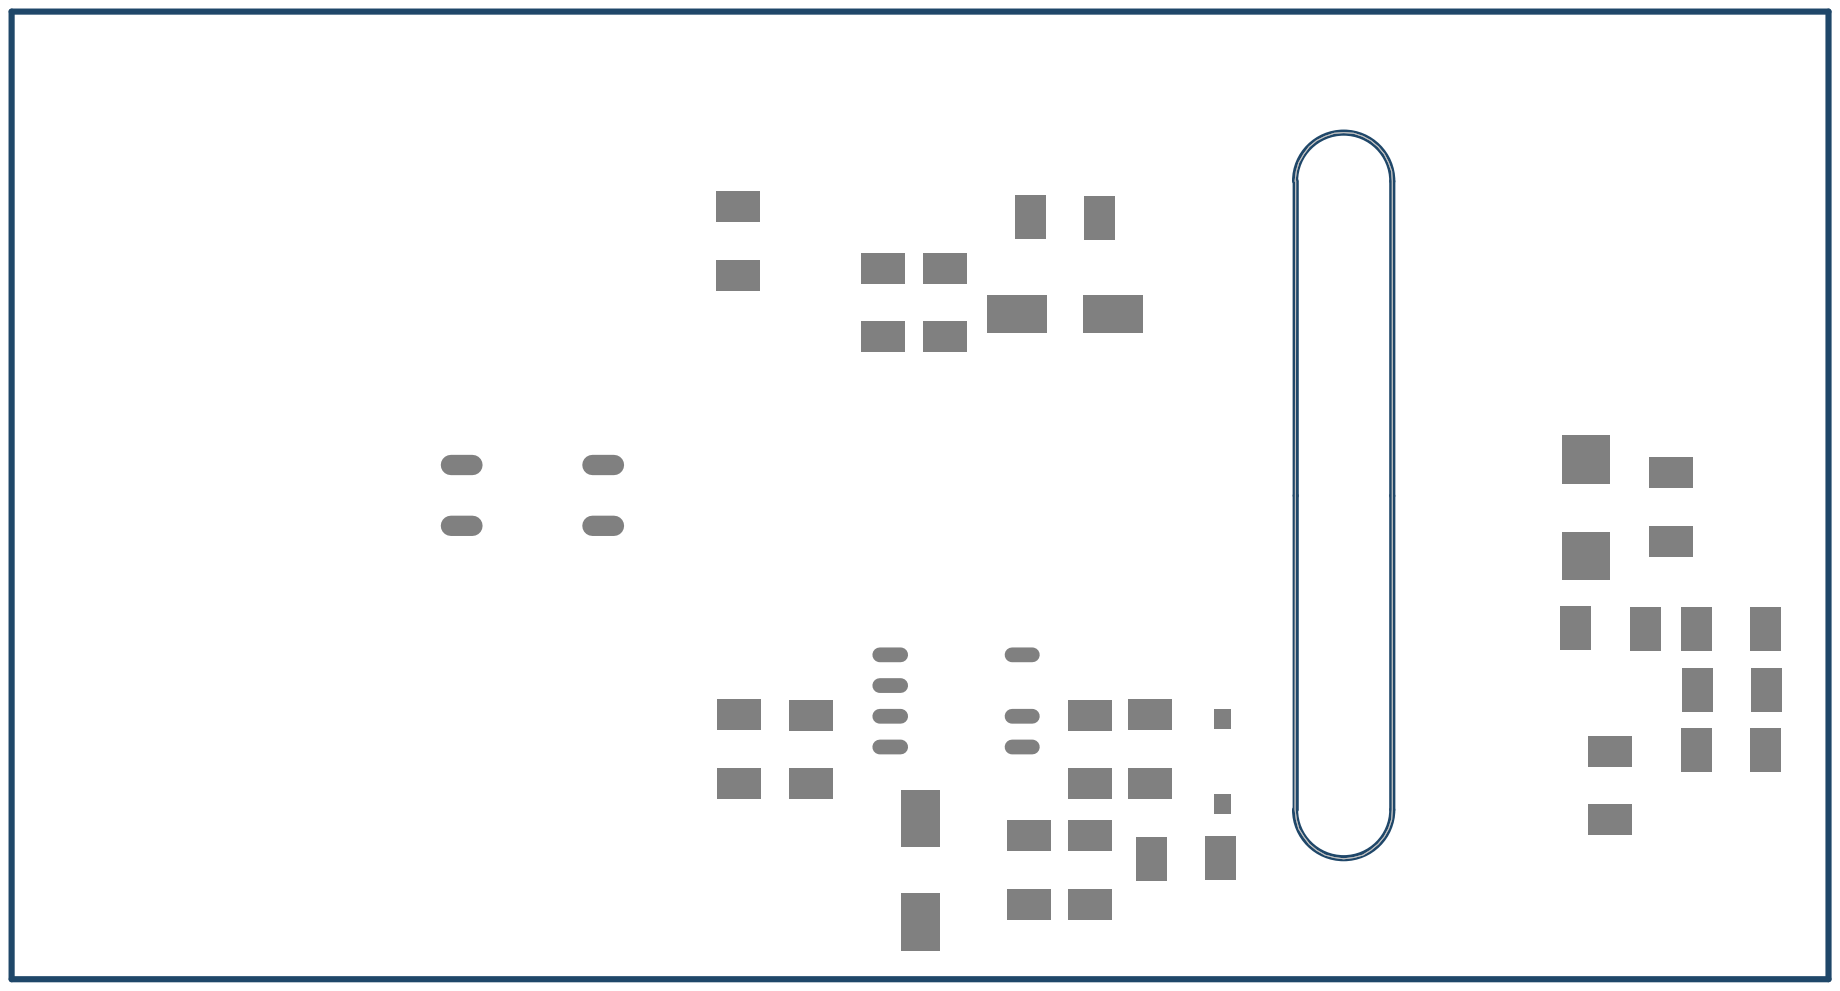
[picture p80: page 4]
