b105-h2h/h2h/boards/2.0/H2H Power Supply v1.1/Output/Schematics/H2H Power Supply v1.1 (Kiwi).pdf

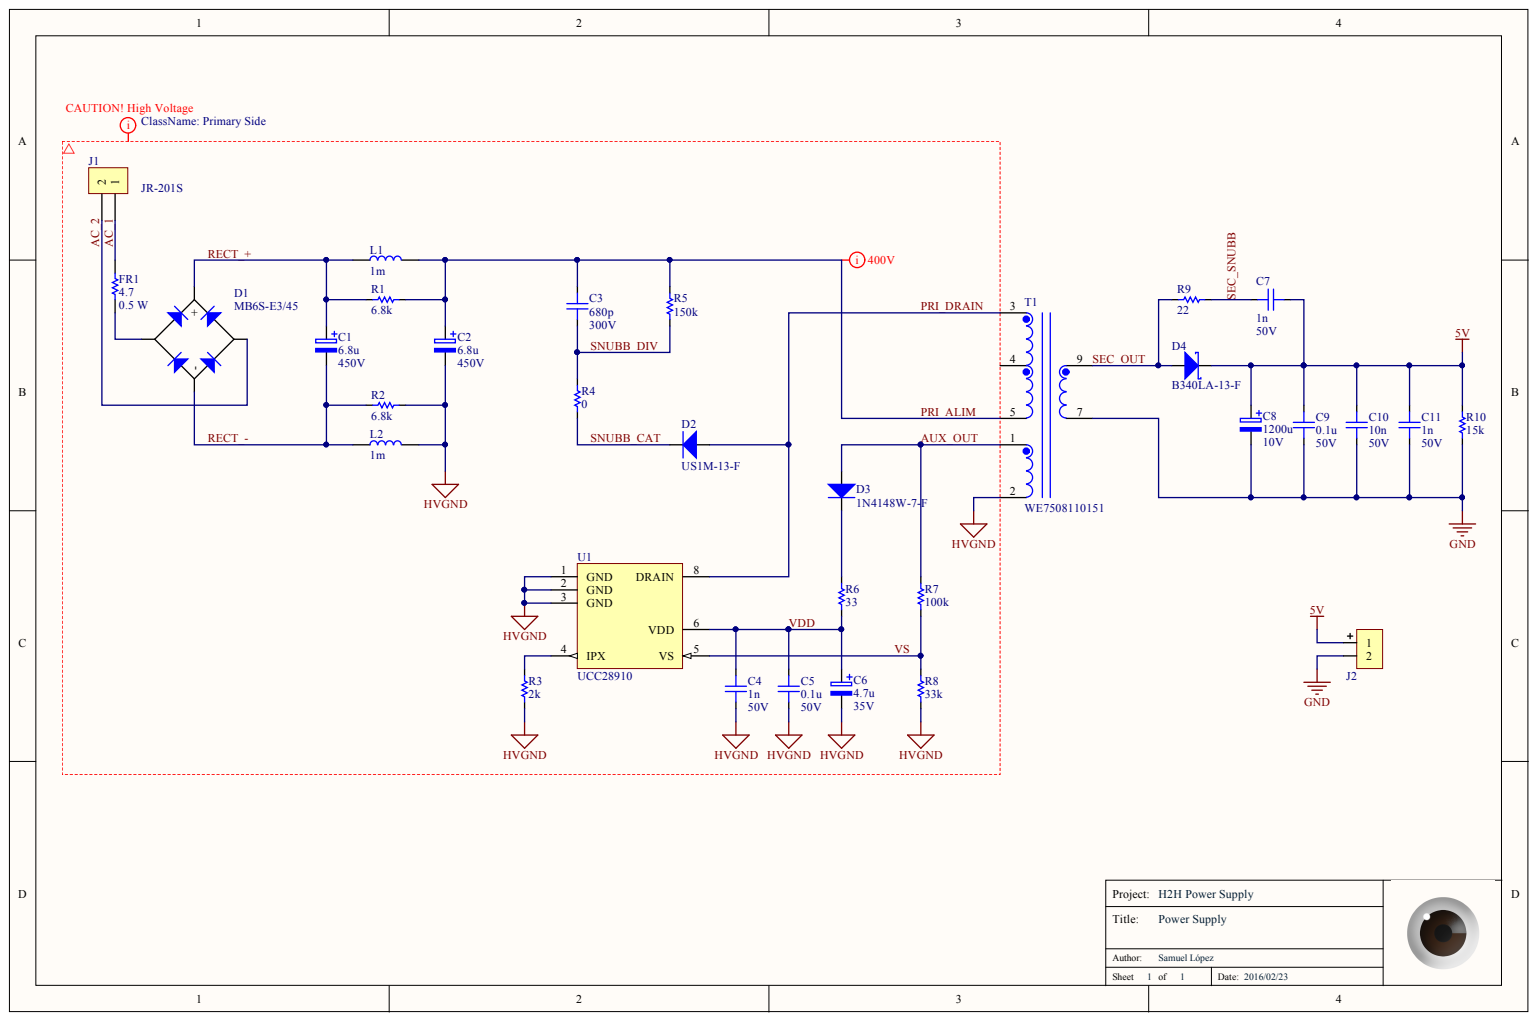
[picture p81: page 1]

RECT _ | +
