b105-h2h/h2h/boards/2.0/H2H Main Board v1.0/PDF/Output Main Board.PDF

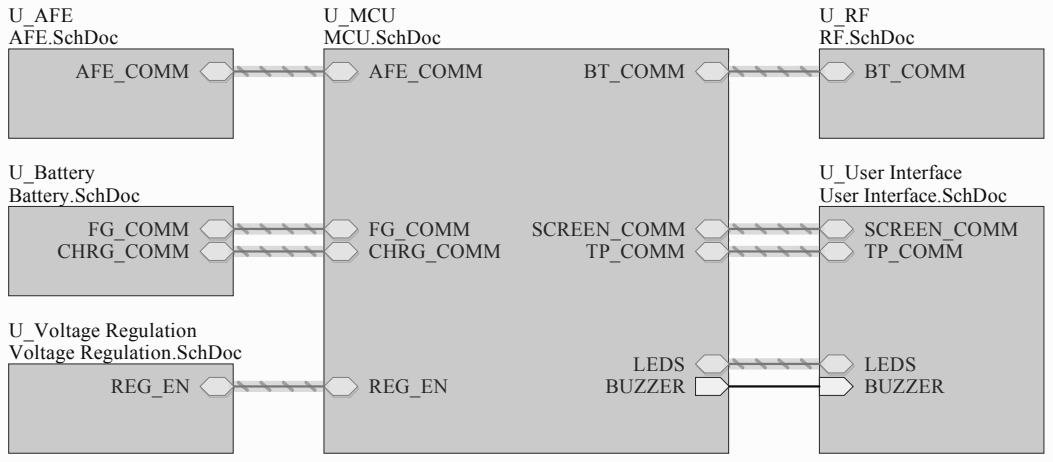
[picture p82: page 1]

Cannot open file
C:\Users\Smau\Deskt
op\IMGs\Eye\Eye.pn

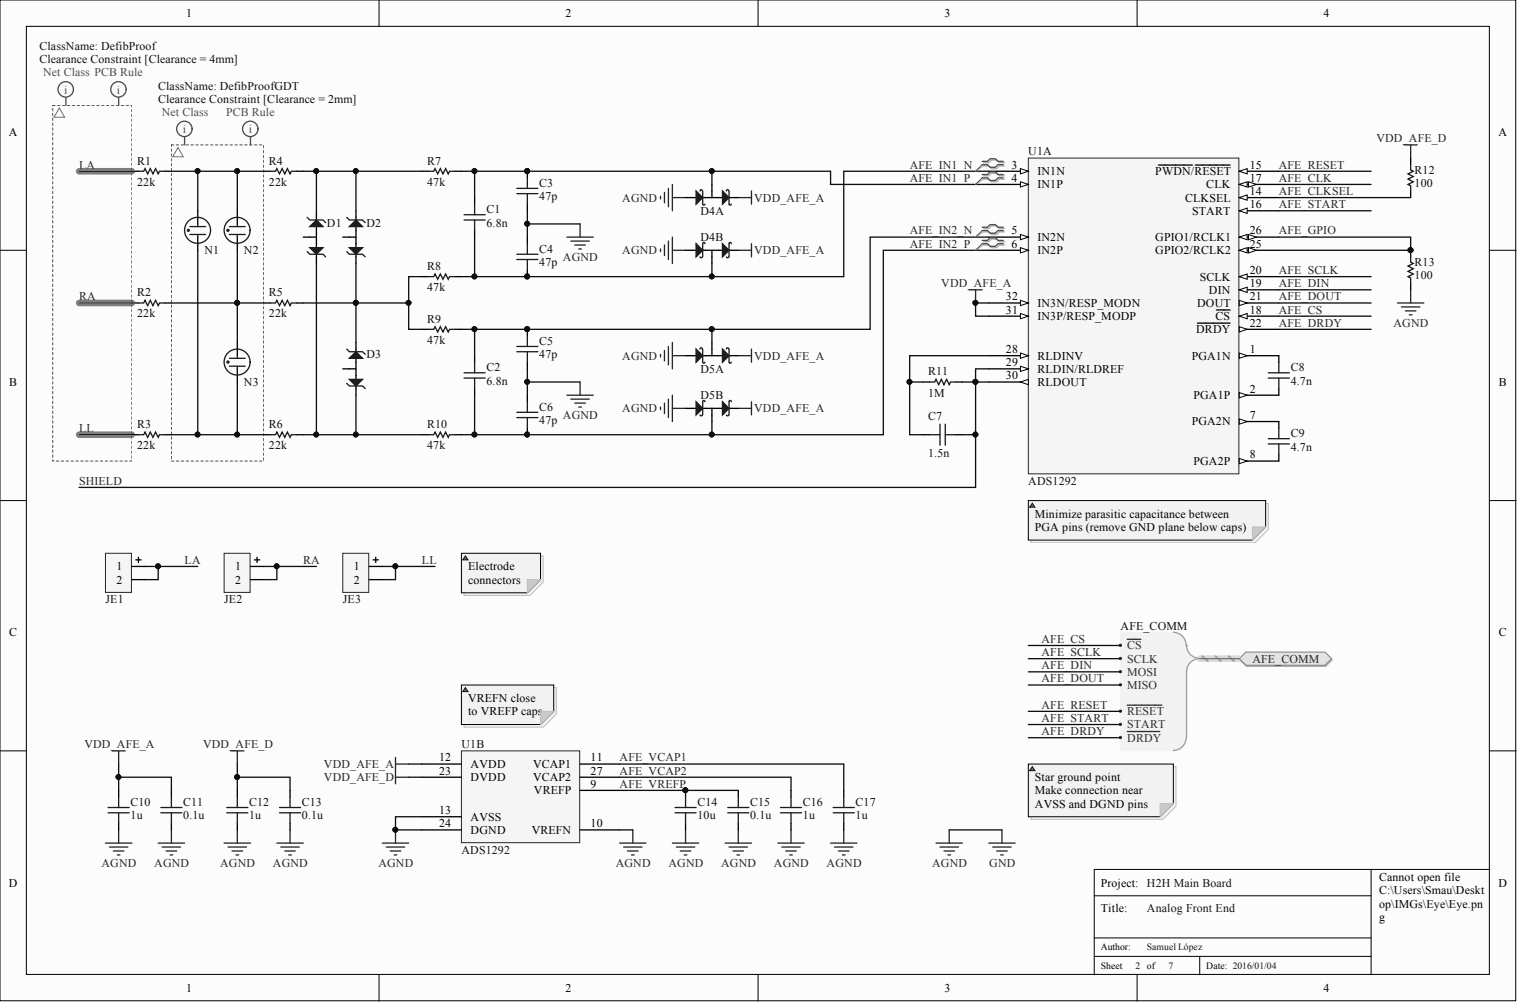
[picture p83: page 2]

AFE_IN2_N | | IN2N 5

IN3N/RESP_MODN 32

Minimize parasitic capacitance between
PGA pins (remove GND plane below caps)

Star ground point
Make connection near
AVSS and DGND pins

Cannot open file
C:\Users\Smau\Deskt
op\IMGs\Eye\Eye.pn

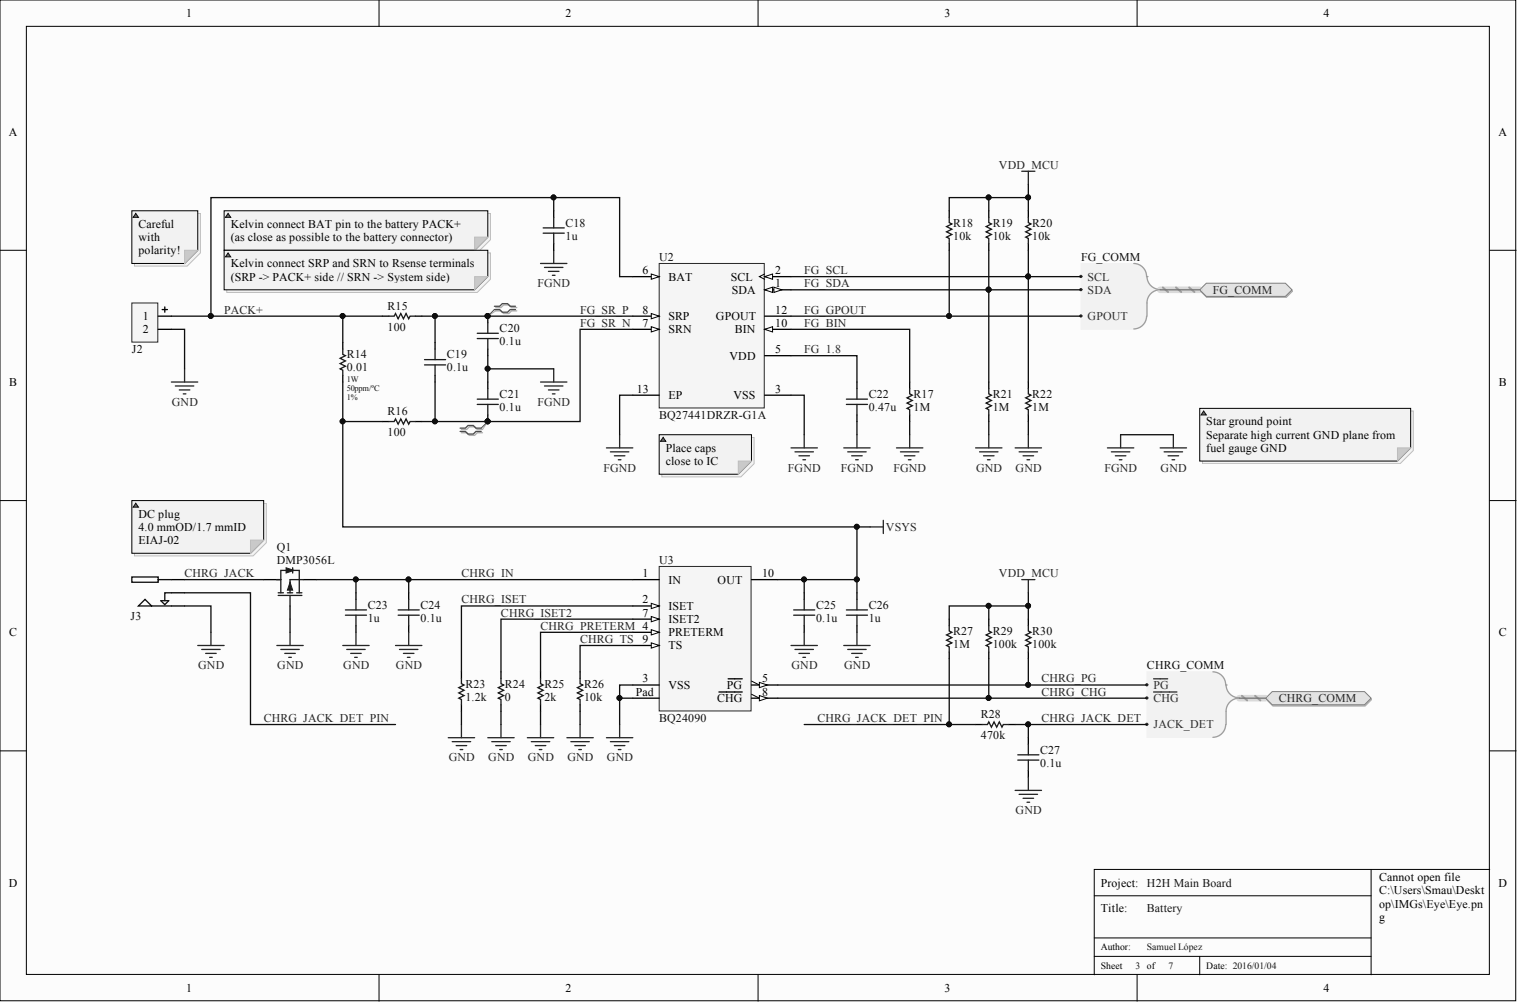
[picture p84: page 3]

Kelvin connect BAT pin to the battery PACK+
(as close as possible to the battery connector)

Kelvin connect SRP and SRN to Rsense terminals
(SRP -> PACK+ side // SRN -> System side)

Star ground point
Separate high current GND plane from
fuel gauge GND

CHRG_ISET2 | | ISET2 7

ISET 2

CHRG_PRETERM | | PRETERM 4

CHRG_TS | | TS 9

VSS 3
Pad

Cannot open file
C:\Users\Smau\Deskt
op\IMGs\Eye\Eye.pn

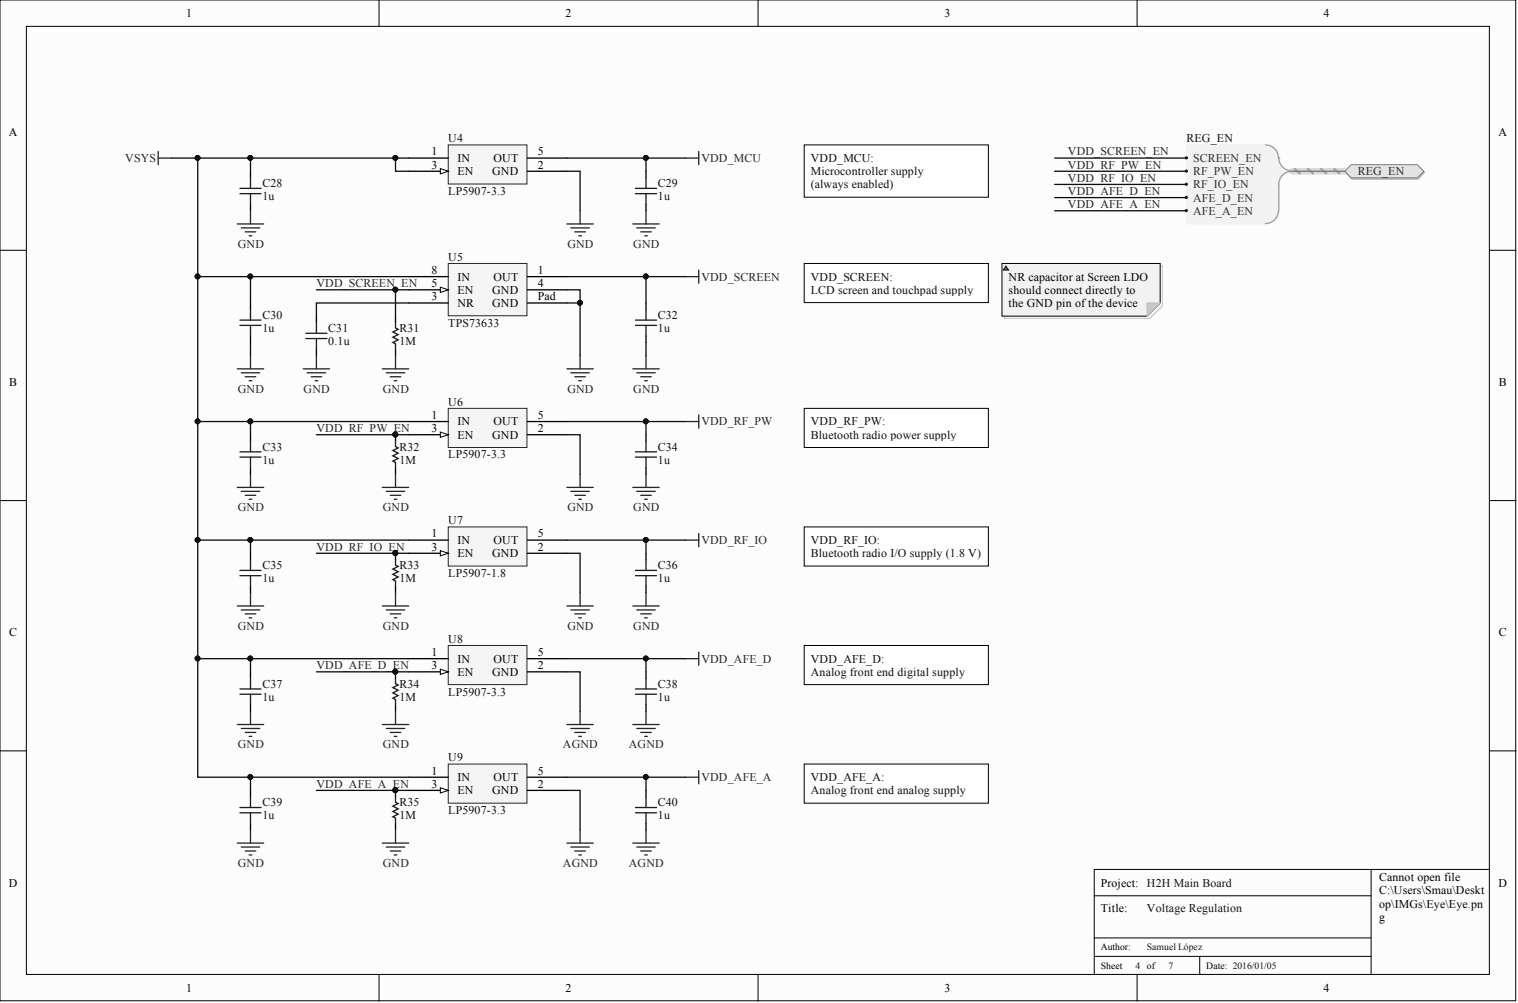
[picture p85: page 4]

G | V D D _SCRE E N _ E | N 5 | 4

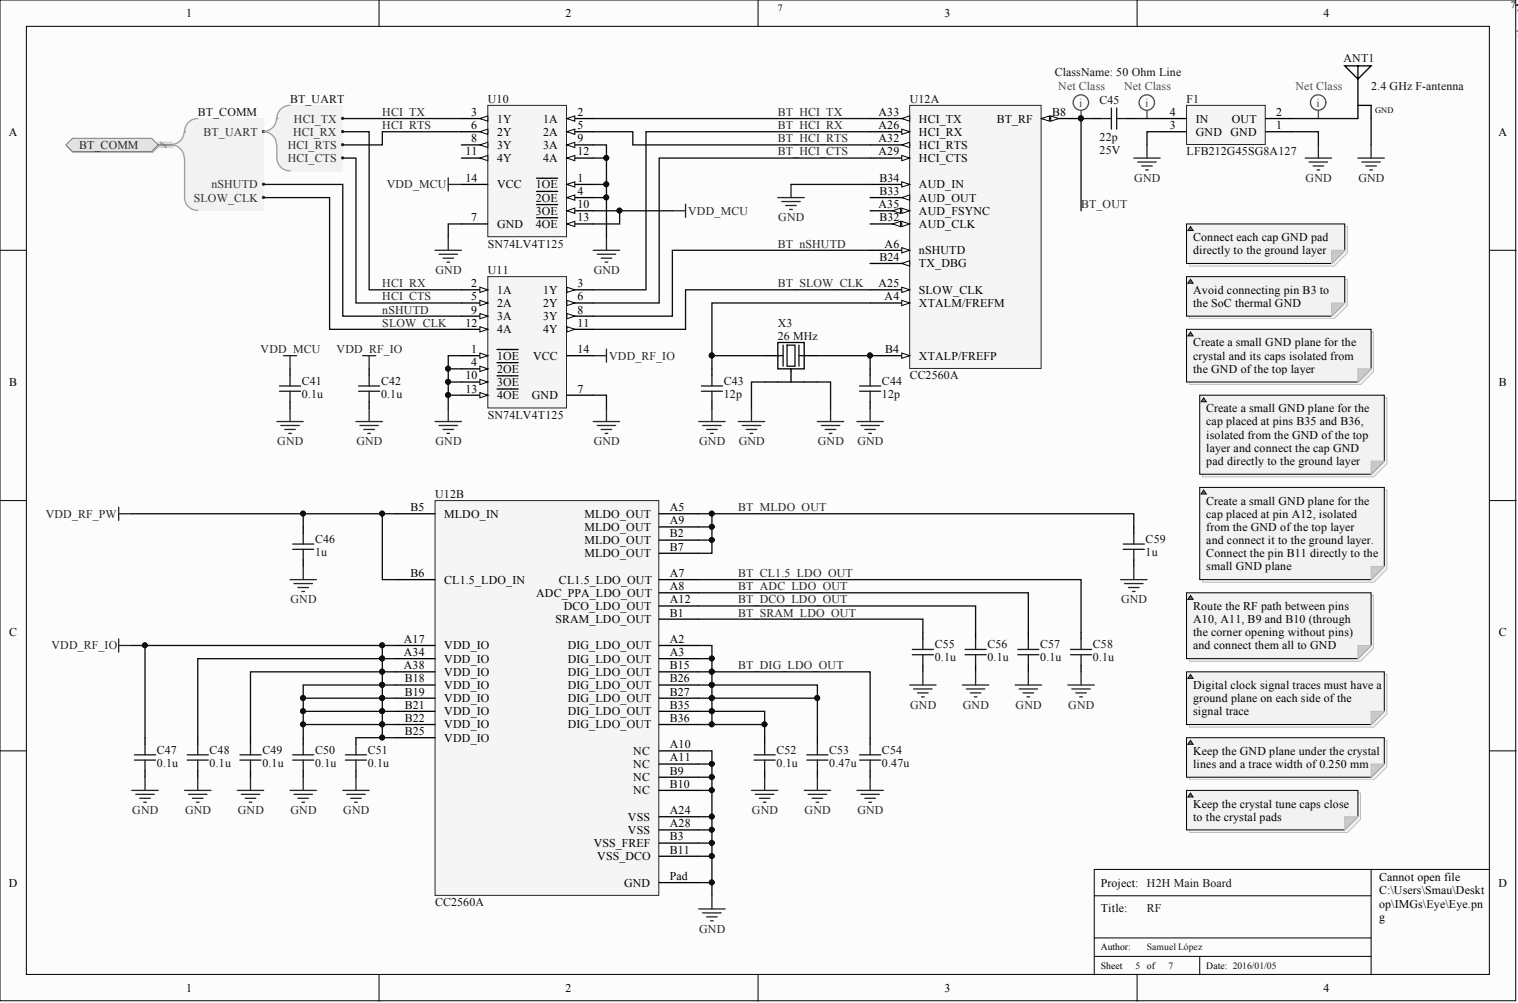
[picture p86: page 5]

Connect each cap GND pad
directly to the ground layer

Avoid connecting pin B3 to
the SoC thermal GND

SLOW_CLK | | X3

1OE 1 | 26 MHz

Create a small GND plane for the
crystal and its caps isolated from
the GND of the top layer

cap placed at pins B35 and B36,
isolated from the GND of the top
layer and connect the cap GND
pad directly to the ground layer

cap placed at pin A12, isolated
from the GND of the top layer
and connect it to the ground layer.
Connect the pin B11 directly to the
small GND plane

CL1.5_LDO_IN B6
VDD_IO A17 | | BT_ADC_LDO_OUT

BT_DCO_LDO_OUT
BT_SRAM_LDO_OUT

Route the RF path between pins
A10, A11, B9 and B10 (through
the corner opening without pins)
and connect them all to GND

VDD_IO A34
VDD_IO A38
VDD_IO B18
VDD_IO B19

Digital clock signal traces must have a
ground plane on each side of the
signal trace

VDD_IO B22

Keep the GND plane under the crystal
lines and a trace width of 0.250 mm

Keep the crystal tune caps close
to the crystal pads

Cannot open file
C:\Users\Smau\Deskt
op\IMGs\Eye\Eye.pn

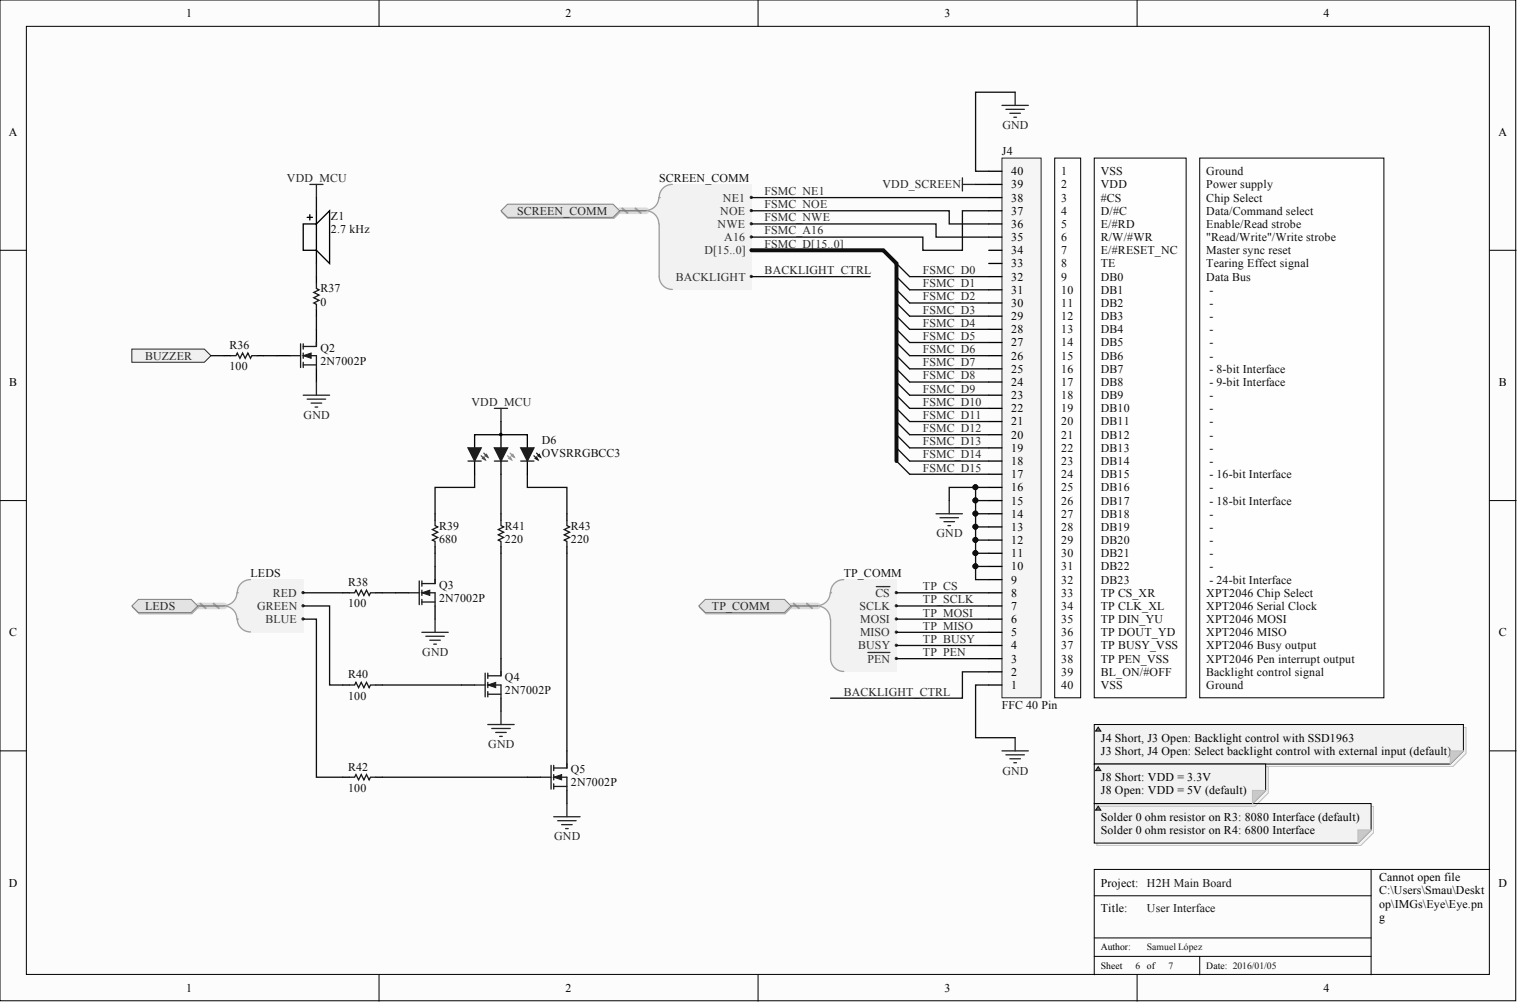
[picture p87: page 6]

VSS VDD #CS D/#C E/#RD

FSMC_N W E
FSMC_ A 1 6

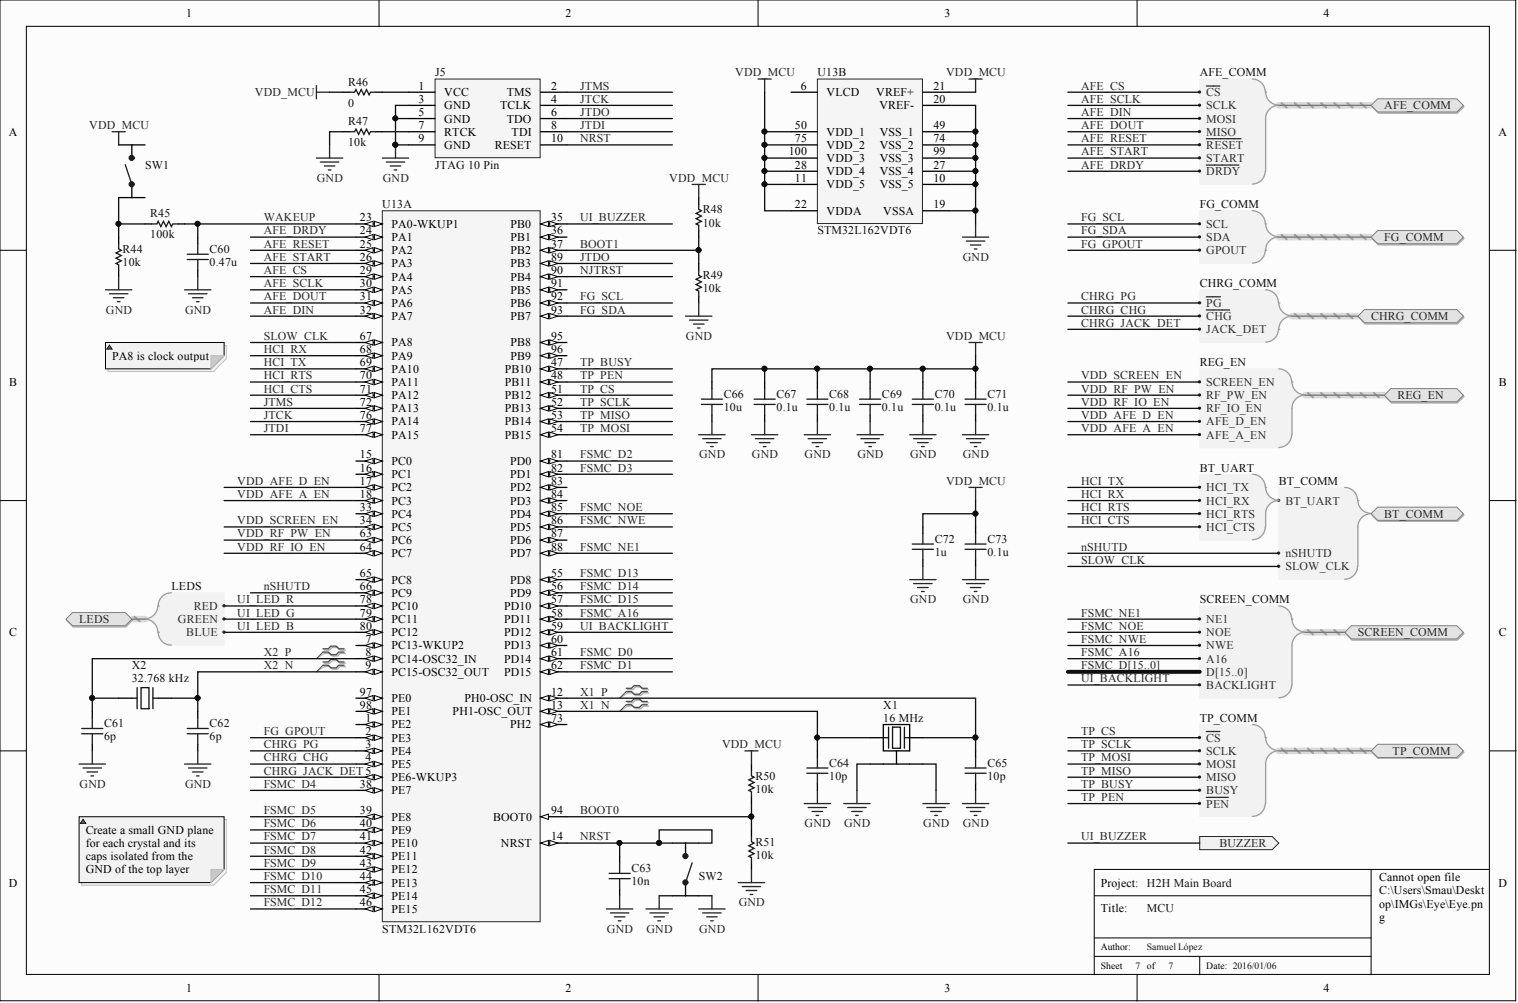
[picture p88: page 7]

7 5 | 7 4
1 0 0 | 9 9
2 8 | 2 7
1 1 | 1 0

13 PH0-OSC_IN 12 3 PH1-OSC_OUT | X 1 _N X 1
