b105-h2h/h2h/boards/sim/AFE Input.asc

C1: cap; 6.8n
C2: cap; 47p
C3: cap; 47p
R1: res; 47K
R2: res; 47K
V1: voltage; SINE(2 1 10 0); AC 1 0; Rser=10K
V2: voltage; SINE(2 1 10 0); AC 1 180; Rser=10K
Named nets: 0
.ac dec 20 0.1 1000
