b105-h2h/h2h/(list of files, drawings)

Other design files:
boards/1.0/3D/TIIC Power Supply/Touchscreen/Touchscreen.PcbDoc
boards/1.0/3D/TIIC Power Supply/Touchscreen/Touchscreen.PrjPcb
boards/1.0/AFE.SchDoc
boards/1.0/Battery Charger.SchDoc
boards/1.0/Docking Station 2.0.PrjPcb
boards/1.0/Docking Station.PcbDoc
boards/1.0/Docking Station.PrjPcb
boards/1.0/Docking Station.SchDoc
boards/1.0/ECG Main Board.PrjPcb
boards/1.0/Main Board.PcbDoc
boards/1.0/Main Board.SchDoc
boards/1.0/MCU.SchDoc
boards/1.0/Mechanical.SchDoc
boards/1.0/Power Supply.SchDoc
boards/1.0/RF.SchDoc
boards/1.0/Supply.SchDoc
boards/2.0/H2H Main Board v1.0/3D/Persimon Logo.PcbDoc
boards/2.0/H2H Main Board v1.0/3D/Screen.PcbDoc
boards/2.0/H2H Main Board v1.0/H2H Main Board v1.0.PrjPCB
boards/2.0/H2H Main Board v1.0/Schematics/AFE.SchDoc
boards/2.0/H2H Main Board v1.0/Schematics/Battery.SchDoc
boards/2.0/H2H Main Board v1.0/Schematics/Main Board.SchDoc
boards/2.0/H2H Main Board v1.0/Schematics/MCU.SchDoc
boards/2.0/H2H Main Board v1.0/Schematics/old/AFE_old.SchDoc
boards/2.0/H2H Main Board v1.0/Schematics/old/Battery_old.SchDoc
boards/2.0/H2H Main Board v1.0/Schematics/old/MCU_old.SchDoc
boards/2.0/H2H Main Board v1.0/Schematics/old/RF_old.SchDoc
boards/2.0/H2H Main Board v1.0/Schematics/old/Voltage Regulation_old.SchDoc
boards/2.0/H2H Main Board v1.0/Schematics/RF.SchDoc
boards/2.0/H2H Main Board v1.0/Schematics/User Interface.SchDoc
boards/2.0/H2H Main Board v1.0/Schematics/Voltage Regulation.SchDoc
boards/2.0/H2H Main Board v1.1/H2H Main Board v1.1.PrjPCB
boards/2.0/H2H Main Board v1.1/Res/3D/Persimon Logo.PcbDoc
boards/2.0/H2H Main Board v1.1/Res/3D/Screen.PcbDoc
boards/2.0/H2H Main Board v1.1/Schematics/AFE.SchDoc
boards/2.0/H2H Main Board v1.1/Schematics/Battery.SchDoc
boards/2.0/H2H Main Board v1.1/Schematics/Main Board.SchDoc
boards/2.0/H2H Main Board v1.1/Schematics/MCU.SchDoc
boards/2.0/H2H Main Board v1.1/Schematics/old/AFE_old.SchDoc
boards/2.0/H2H Main Board v1.1/Schematics/old/Battery_old.SchDoc
boards/2.0/H2H Main Board v1.1/Schematics/old/MCU_old.SchDoc
boards/2.0/H2H Main Board v1.1/Schematics/old/RF_old.SchDoc
boards/2.0/H2H Main Board v1.1/Schematics/old/Voltage Regulation_old.SchDoc
boards/2.0/H2H Main Board v1.1/Schematics/RF.SchDoc
boards/2.0/H2H Main Board v1.1/Schematics/User Interface.SchDoc
boards/2.0/H2H Main Board v1.1/Schematics/Voltage Regulation.SchDoc
boards/2.0/H2H Power Supply v1.0/H2H Power Supply v1.0.PrjPCB
boards/2.0/H2H Power Supply v1.0/PCB/Power Supply.PcbDoc
boards/2.0/H2H Power Supply v1.0/Schematics/Power Supply.SchDoc
boards/2.0/H2H Power Supply v1.1/H2H Power Supply v1.1.PrjPCB
boards/2.0/H2H Power Supply v1.1/PCB/Power Supply.PcbDoc
boards/2.0/H2H Power Supply v1.1/Schematics/Power Supply.SchDoc
