b105-h2h/h2h/code/Persimmon/H2H Access Device/Inc/bt_const_and_struct.h

/*
 * bt_const_and_struct.h
 *
 *  Created on: 22/6/2015
 *      Author: Tomas Funk
 */
#ifndef BT_CONST_AND_STRUCT_H_
#define BT_CONST_AND_STRUCT_H_

#define MAX_INQUIRY_RESULTS                        (20)  /* Denotes the max   */
                                                         /* number of inquiry */
                                                         /* results.          */

																		 
#define MAX_SUPPORTED_LINK_KEYS                    (1)   /* Max supported Link*/
                                                         /* keys.             */

#define DEFAULT_IO_CAPABILITY          (icNoInputNoOutput)  /* Denotes the       */
                                                         /* default I/O       */
                                                         /* Capability that is*/
                                                         /* used with Secure  */
                                                         /* Simple Pairing.   */

#define DEFAULT_MITM_PROTECTION                  (TRUE)  /* Denotes the       */
                                                         /* default value used*/
                                                         /* for Man in the    */
                                                         /* Middle (MITM)     */
                                                         /* protection used   */
                                                         /* with Secure Simple*/
                                                         /* Pairing.          */

#define NO_COMMAND_ERROR                           (-1)  /* Denotes that no   */
                                                         /* command was       */
                                                         /* specified to the  */
                                                         /* parser.           */

#define INVALID_COMMAND_ERROR                      (-2)  /* Denotes that the  */
                                                         /* Command does not  */
                                                         /* exist for         */
                                                         /* processing.       */

#define EXIT_CODE                                  (-3)  /* Denotes that the  */
                                                         /* Command specified */
                                                         /* was the Exit      */
                                                         /* Command.          */

#define FUNCTION_ERROR                             (-4)  /* Denotes that an   */
                                                         /* error occurred in */
                                                         /* execution of the  */
                                                         /* Command Function. */

#define TO_MANY_PARAMS                             (-5)  /* Denotes that there*/
                                                         /* are more          */
                                                         /* parameters then   */
                                                         /* will fit in the   */
                                                         /* UserCommand.      */

#define INVALID_PARAMETERS_ERROR                   (-6)  /* Denotes that an   */
                                                         /* error occurred due*/
                                                         /* to the fact that  */
                                                         /* one or more of the*/
                                                         /* required          */
                                                         /* parameters were   */
                                                         /* invalid.          */

#define UNABLE_TO_INITIALIZE_STACK                 (-7)  /* Denotes that an   */
                                                         /* error occurred    */
                                                         /* while Initializing*/
                                                         /* the Bluetooth     */
                                                         /* Protocol Stack.   */

#define INVALID_STACK_ID_ERROR                     (-8)  /* Denotes that an   */
                                                         /* occurred due to   */
                                                         /* attempted         */
                                                         /* execution of a    */
                                                         /* Command when a    */
                                                         /* Bluetooth Protocol*/
                                                         /* Stack has not been*/
                                                         /* opened.           */

#define UNABLE_TO_REGISTER_SERVER                  (-9)  /* Denotes that an   */
                                                         /* error occurred    */
                                                         /* when trying to    */
                                                         /* create a Serial   */
                                                         /* Port Server.      */

#define EXIT_MODE                                  (-10) /* Flags exit from   */
                                                         /* any Mode.         */

   /* Determine the Name we will use for this compilation.              */
#define APP_DEMO_NAME                              "BETE_TURBO_3000"


   /* The following represent the possible values of UI_Mode variable.  */
#define UI_MODE_IS_CLIENT      (2)
#define UI_MODE_IS_SERVER      (1)
#define UI_MODE_SELECT         (0)
#define UI_MODE_IS_INVALID     (-1)

   /* Following converts a Sniff Parameter in Milliseconds to frames.   */
#define MILLISECONDS_TO_BASEBAND_SLOTS(_x)   ((_x) / (0.625))


#define APPLICATION_ERROR_INVALID_PARAMETERS       (-1000)
#define APPLICATION_ERROR_UNABLE_TO_OPEN_STACK     (-1001)

#define MAX_STRING_LENGTH 50

#define gen_init "INICIO GENERACION"
#define gen_ack  "ACK GENERACION"
#define key_ready "CONTRASEÑA LISTA"
#define access_ok "ACCESO ACEPTADO"
#define access_denied "ACCESO RECHAZADO"

   /* The following type definition represents the container type which */
   /* holds the mapping between Bluetooth devices (based on the BD_ADDR)*/
   /* and the Link Key (BD_ADDR <-> Link Key Mapping).                  */
typedef struct _tagLinkKeyInfo_t
{
   BD_ADDR_t  BD_ADDR;
   Link_Key_t LinkKey;
} LinkKeyInfo_t;

   /* User to represent a structure to hold a BD_ADDR return from       */
   /* BD_ADDRToStr.                                                     */
typedef char BoardStr_t[15];

   /* The following structure holds status information about a send     */
   /* process.                                                          */
typedef struct _tagSend_Info_t
{
   DWord_t PendingCount;
   DWord_t BytesToSend;
   DWord_t BytesSent;
} Send_Info_t;

   /* The following structure is used to hold information of the 		*/
   /* FIRMWARE version.                                                 */
typedef struct FW_Version_t
{
   Byte_t StatusResult;
   Byte_t HCI_VersionResult;
   Word_t HCI_RevisionResult;
   Byte_t LMP_VersionResult;
   Word_t Manufacturer_NameResult;
   Word_t LMP_SubversionResult;
} FW_Version;

typedef struct device_info_t
{
  BD_ADDR_t physical_address;
  char Name[MAX_STRING_LENGTH];
} device_info_t;


   /* Internal Variables to this Module (Remember that all variables    */
   /* declared static are initialized to 0 automatically by the         */
   /* compiler as part of standard C/C++).                              */

#endif /* BT_CONST_AND_STRUCT_H_ */
