b105-h2h/h2h/code/Persimmon/H2H Access Device/Dep/H2H.ioc

Mcu.UserName=STM32L162VDTx
PA0-WKUP1.GPIO_Label=SYS_WKUP
PA0-WKUP1.Signal=GPXTI0
PA1.GPIO_Label=AFE_DRDY
PA1.Signal=GPXTI1
PA10.GPIO_Label=BT_RX
PA10.Signal=USART1_RX
PA11.GPIO_Label=BT_CTS
PA11.Signal=USART1_CTS
PA12.GPIO_Label=BT_RTS
PA12.Signal=USART1_RTS
PA13.Signal=SYS_JTMS-SWDIO
PA14.Signal=SYS_JTCK-SWCLK
PA15.Signal=SYS_JTDI
PA2.GPIO_Label=AFE_RESET
PA2.Signal=GPIO_Output
PA3.GPIO_Label=AFE_START
PA3.Signal=GPIO_Output
PA4.GPIO_Label=AFE_CS
PA4.Signal=GPIO_Output
PA5.GPIO_Label=AFE_SCLK
PA5.Signal=SPI1_SCK
PA6.GPIO_Label=AFE_DOUT
PA6.Signal=SPI1_MISO
PA7.GPIO_Label=AFE_DIN
PA7.Signal=SPI1_MOSI
PA8.GPIO_Label=BT_SLOW_CLK
PA8.Signal=RCC_MCO
PA9.GPIO_Label=BT_TX
PA9.Signal=USART1_TX
PB0.GPIO_Label=UI_BUZZER
PB0.Signal=S_TIM3_CH3
PB1.GPIO_Label=NC
PB1.Signal=GPIO_Analog
PB10.GPIO_Label=TP_BUSY
PB10.Signal=GPIO_Analog
PB11.GPIO_Label=TP_PEN
PB11.Signal=GPXTI11
PB12.GPIO_Label=TP_CS
PB12.Signal=GPIO_Output
PB13.GPIO_Label=TP_SCLK
PB13.Signal=SPI2_SCK
PB14.GPIO_Label=TP_MISO
PB14.Signal=SPI2_MISO
PB15.GPIO_Label=TP_MOSI
PB15.Signal=SPI2_MOSI
PB2.GPIO_Label=BOOT1
PB2.Signal=GPIO_Input
PB3.Signal=SYS_JTDO-TRACESWO
PB4.Signal=SYS_JTRST
PB5.GPIO_Label=NC
PB5.Signal=GPIO_Analog
PB6.GPIO_Label=FG_SCL
PB6.Signal=I2C1_SCL
PB7.GPIO_Label=FG_SDA
PB7.Signal=I2C1_SDA
PB8.GPIO_Label=NC
PB8.Signal=GPIO_Analog
PB9.GPIO_Label=NC
PB9.Signal=GPIO_Analog
PC0.GPIO_Label=NC
PC0.Signal=GPIO_Analog
PC1.GPIO_Label=NC
PC1.Signal=GPIO_Analog
PC10.GPIO_Label=UI_LED_R
PC10.Signal=GPIO_Output
PC11.GPIO_Label=UI_LED_G
PC11.Signal=GPIO_Output
PC12.GPIO_Label=UI_LED_B
PC12.Signal=GPIO_Output
PC13-WKUP2.GPIO_Label=NC
PC13-WKUP2.Signal=GPIO_Analog
PC14-OSC32_IN.GPIO_Label=X2_P
PC14-OSC32_IN.Signal=RCC_OSC32_IN
PC15-OSC32_OUT.GPIO_Label=X2_N
PC15-OSC32_OUT.Signal=RCC_OSC32_OUT
PC2.GPIO_Label=VDD_AFE_D_EN
PC2.Signal=GPIO_Output
PC3.GPIO_Label=VDD_AFE_A_EN
PC3.Signal=GPIO_Output
PC4.GPIO_Label=NC
PC4.Signal=GPIO_Analog
PC5.GPIO_Label=VDD_SCREEN_EN
PC5.Signal=GPIO_Output
PC6.GPIO_Label=VDD_RF_PW_EN
PC6.Signal=GPIO_Output
PC7.GPIO_Label=VDD_RF_IO_EN
PC7.Signal=GPIO_Output
PC8.GPIO_Label=NC
PC8.Signal=GPIO_Analog
PC9.GPIO_Label=nSHUTD
PC9.Signal=GPIO_Output
PD0.Signal=FSMC_D2
PD1.Signal=FSMC_D3
PD10.Signal=FSMC_D15
PD11.Signal=FSMC_A16
PD12.GPIO_Label=UI_BACKLIGHT
PD12.Signal=GPIO_Output
PD13.GPIO_Label=NC
PD13.Signal=GPIO_Analog
PD14.Signal=FSMC_D0
PD15.Signal=FSMC_D1
PD2.GPIO_Label=NC
PD2.Signal=GPIO_Analog
PD3.GPIO_Label=NC
PD3.Signal=GPIO_Analog
PD4.Signal=FSMC_NOE
PD5.Signal=FSMC_NWE
PD6.GPIO_Label=NC
PD6.Signal=GPIO_Analog
PD7.Signal=FSMC_NE1
PD8.Signal=FSMC_D13
PD9.Signal=FSMC_D14
PE0.GPIO_Label=NC
PE0.Signal=GPIO_Analog
PE1.GPIO_Label=NC
PE1.Signal=GPIO_Analog
PE10.Signal=FSMC_D7
PE11.Signal=FSMC_D8
PE12.Signal=FSMC_D9
PE13.Signal=FSMC_D10
PE14.Signal=FSMC_D11
PE15.Signal=FSMC_D12
PE2.GPIO_Label=NC
PE2.Signal=GPIO_Analog
PE3.GPIO_Label=FG_GPOUT
PE3.Signal=GPXTI3
PE4.GPIO_Label=CHRG_PG
PE4.Signal=GPXTI4
PE5.GPIO_Label=CHRG_CHG
PE5.Signal=GPXTI5
PE6-WKUP3.GPIO_Label=CHRG_JACK_DET
PE6-WKUP3.Signal=GPXTI6
PE7.Signal=FSMC_D4
PE8.Signal=FSMC_D5
PE9.Signal=FSMC_D6
PH0-OSC_IN.GPIO_Label=X1_P
PH0-OSC_IN.Signal=RCC_OSC_IN
PH1-OSC_OUT.GPIO_Label=X1_N
PH1-OSC_OUT.Signal=RCC_OSC_OUT
PH2.GPIO_Label=NC
PH2.Signal=GPIO_Analog
