b105-h2h/h2h/code/Persimmon/H2H Access Device/Inc/state_main.h

/*
 * state_main.h
 *
 *  Created on: 29/9/2015
 *      Author: Smau
 */

#ifndef STATE_MAIN_H_
#define STATE_MAIN_H_

#include "state.h"

void behaviour_main(state_ptr state);
void entry_to_main(state_ptr state);

#endif /* STATE_MAIN_H_ */
