b105-h2h/h2h/code/Persimmon/H2H Access Device/Inc/state_ecg.h

/*
 * state_ecg.h
 *
 *  Created on: 29/9/2015
 *      Author: Smau
 */

#ifndef STATE_ECG_H_
#define STATE_ECG_H_

#include "state.h"

void behaviour_ecg(state_ptr state);
void entry_to_ecg(state_ptr state);

#endif /* STATE_ECG_H_ */
