b105-h2h/h2h/code/Persimmon/H2H Access Device/Inc/state_ecg_1_lead.h

/*
 * state_ecg_1_lead.h
 *
 *  Created on: 29/9/2015
 *      Author: Smau
 */

#ifndef STATE_ECG_1_LEAD_H_
#define STATE_ECG_1_LEAD_H_

#include "state.h"

void behaviour_ecg_1_lead(state_ptr state);
void entry_to_ecg_1_lead(state_ptr state);

#endif /* STATE_ECG_1_LEAD_H_ */
