b105-h2h/h2h/code/Persimmon/H2H Access Device/Inc/state_goodbye.h

/*
 * state_goodbye.h
 *
 *  Created on: 29/9/2015
 *      Author: Smau
 */

#ifndef STATE_GOODBYE_H_
#define STATE_GOODBYE_H_

#include "state.h"

void behaviour_goodbye(state_ptr state);
void entry_to_goodbye(state_ptr state);

#endif /* STATE_GOODBYE_H_ */
