b105-h2h/h2h/code/Persimmon/H2H Access Device/Inc/buzzer_constants.h

/*
 * buzzer_constants.h
 *
 * Buzzer constant definitions
 *
 *  Created on: 23/6/2016
 *      Author: slopez
 */

#ifndef BUZZER_CONSTANTS_H_
#define BUZZER_CONSTANTS_H_

#define A2      18180   //<= 'A' 110 Hz
#define Bb2     17160
#define B2      16197

#define C3      15287
#define Db3     14429
#define D3      13620
#define Eb3     12855
#define E3      12134
#define F3      11453
#define Gb3     10810
#define G3      10203
#define Ab3     9631
#define A3      9090    //<= 'A' 220 Hz
#define Bb3     8580
#define B3      8098

#define C4      7644
#define Db4     7215
#define D4      6810
#define Eb4     6428
#define E4      6067
#define F4      5726
#define Gb4     5405
#define G4      5102
#define Ab4     4815
#define A4      4545    //<= 'A' 440 Hz
#define Bb4     4290
#define B4      4049

#define C5      3822
#define Db5     3607
#define D5      3405
#define Eb5     3214
#define E5      3033
#define F5      2863
#define Gb5     2702
#define G5      2551
#define Ab5     2408
#define A5      2273    //<= 'A' 880 Hz
#define Bb5     2145
#define B5      2025

#define C6      1911
#define Db6     1804
#define D6      1702
#define Eb6     1607
#define E6      1517
#define F6      1432
#define Gb6     1351
#define G6      1275
#define Ab6     1204
#define A6      1136    //<= 'A' 1760 Hz

#endif /* BUZZER_CONSTANTS_H_ */
