b105-h2h/h2h/code/Persimmon/H2H Access Device/Inc/state_h2h_ongoing_error.h

/*
 * state_h2h_ongoing_error.h
 *
 *  Created on: 29/9/2015
 *      Author: Smau
 */

#ifndef STATE_H2H_ONGOING_ERROR_H_
#define STATE_H2H_ONGOING_ERROR_H_

#include "state.h"

void behaviour_h2h_ongoing_error(state_ptr state);
void entry_to_h2h_ongoing_error(state_ptr state);

#endif /* STATE_H2H_ONGOING_ERROR_H_ */
