b105-h2h/h2h/code/Persimmon/H2H Access Device/Inc/state_menu.h

/*
 * state_menu.h
 *
 *  Created on: 29/9/2015
 *      Author: Smau
 */

#ifndef STATE_MENU_H_
#define STATE_MENU_H_

#include "state.h"

#include <string.h>

void behaviour_menu(state_ptr state);
void entry_to_menu(state_ptr state);

#endif /* STATE_MENU_H_ */
