b105-h2h/h2h/code/Persimmon/H2H Access Device/Inc/state_running.h

/*
 * state_running.h
 *
 *  Created on: 29/9/2015
 *      Author: Smau
 */

#ifndef STATE_RUNNING_H_
#define STATE_RUNNING_H_

#include "state.h"

void behaviour_running(state_ptr state);
void entry_to_running(state_ptr state);

#endif /* STATE_RUNNING_H_ */
