b105-h2h/h2h/code/Persimmon/H2H Access Device/Inc/state_settings_configtabs_timedate.h

/*
 * state_settings_configtabs_timedate.h
 *
 *  Created on: 29/9/2015
 *      Author: Smau
 */

#ifndef STATE_SETTINGS_CONFIGTABS_TIMEDATE_H_
#define STATE_SETTINGS_CONFIGTABS_TIMEDATE_H_

#include "state.h"

void behaviour_settings_configtabs_timedate(state_ptr state);
void entry_to_settings_configtabs_timedate(state_ptr state);

#endif /* STATE_SETTINGS_CONFIGTABS_TIMEDATE_H_ */
