b105-h2h/h2h/code/Persimmon/H2H Access Device/Inc/state_settings_touchcalib_point_3.h

/*
 * state_settings_touchcalib_point_3.h
 *
 *  Created on: 29/9/2015
 *      Author: Smau
 */

#ifndef STATE_SETTINGS_TOUCHCALIB_POINT_3_H_
#define STATE_SETTINGS_TOUCHCALIB_POINT_3_H_

#include "state.h"

void behaviour_settings_touchcalib_point_3(state_ptr state);
void entry_to_settings_touchcalib_point_3(state_ptr state);

#endif /* STATE_SETTINGS_TOUCHCALIB_POINT_3_H_ */
