b105-h2h/h2h/code/Persimmon/H2H Access Device/Inc/state_welcome.h

/*
 * state_welcome.h
 *
 *  Created on: 29/9/2015
 *      Author: Smau
 */

#ifndef STATE_WELCOME_H_
#define STATE_WELCOME_H_

#include "state.h"

void behaviour_welcome(state_ptr state);
void entry_to_welcome(state_ptr state);

#endif /* STATE_WELCOME_H_ */
