b105-h2h/h2h/code/Persimmon/H2H Access Device/Inc/authentication.h

/*
 * authentication.h
 *
 *  Created on: 29/9/2015
 *      Author: Smau
 */

#ifndef AUTENTICATION_H_
#define AUTENTICATION_H_

#include <stdint.h>

#define NUMBER_OF_IPI 16
typedef enum {ACCEPTED, REJECTED} autentitication_t;
typedef enum {READY, NOT_READY  } key_state_t;
typedef enum {EXTERN, INTERN  } key_origin_t;


typedef struct validation_key_t
{
  uint64_t token;
  uint8_t index;
  key_state_t state;
  key_origin_t origin;
}validation_key_t;

void init_key(validation_key_t* key, key_origin_t origin);
void erase_key(validation_key_t* key);
void write_token_key(validation_key_t* key, uint64_t token);
key_state_t write_key(uint32_t bpm, validation_key_t* key);
autentitication_t validate(validation_key_t* master_key, validation_key_t* received_key);


#endif /* AUTENTICATION_H_ */
