b105-h2h/h2h/code/Persimmon/H2H Access Device/Inc/dsp.h

/*
 * dsp.h
 *
 *  Created on: 29/9/2015
 *      Author: Smau
 */

#ifndef DSP_H_
#define DSP_H_

#include <stdint.h>

int32_t bpm_preprocessing(int32_t value);
int32_t show_filter(int32_t value);

#endif /* DSP_H_ */
