b105-h2h/h2h/code/Persimmon/H2H Access Device/Inc/gauge.h

/*
 * gauge.h
 *
 *  Created on: 10/05/2016
 *      Author: Smau
 */
#ifndef GAUGE_H_
#define GAUGE_H_

#include "gauge_hal.h"

void gauge_init(gauge_t *gauge, I2C_HandleTypeDef *hi2c);

void gauge_start_read(gauge_t *gauge);
void gauge_format_data(gauge_t *gauge);

#endif /* GAUGE_H_ */
