b105-h2h/h2h/code/dep/v1.0/serial.h

/*
 * serial.h
 *
 *  Created on: 29/9/2015
 *      Author: Smau
 */

#ifndef SERIAL_H_
#define SERIAL_H_

#include "utils.h"
#include "afe/afe.h"
#include "buzzer/buzzer.h"
#include "data/ecg_data.h"
#include "display/display.h"
#include "display/display_src/display_functions.h"
#include "touch/touch.h"
#include "filters/filters.h"

#endif /* SERIAL_H_ */
