b105-h2h/h2h/code/dep/v2.0 Persimmon/Inc/afe.h

/*
 * afe.h
 *
 *  Created on: 29/9/2015
 *      Author: Smau
 */

#ifndef AFE_AFE_H_
#define AFE_AFE_H_

#include "gpio.h"
#include "spi.h"

#include "afe_constants.h"

void afe_init();

#endif /* AFE_AFE_H_ */
